tawender/Sensor_Research_System_Hardware/die_outline.bmp

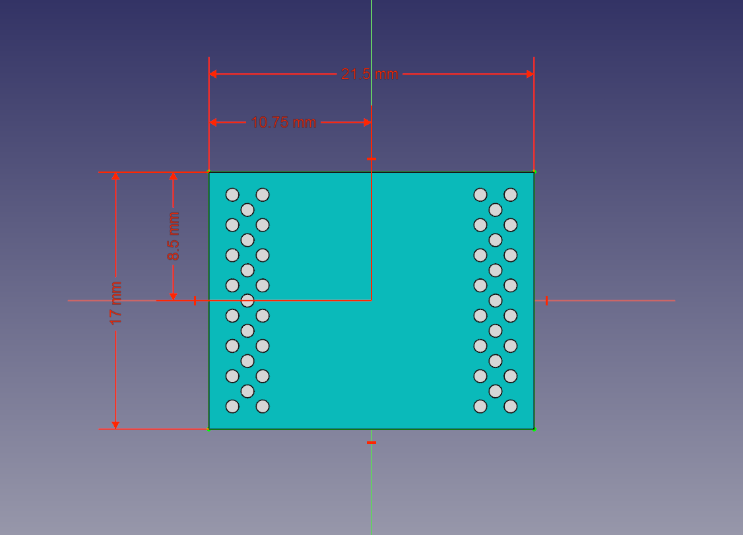
die_outline.bmp
