tawender/Sensor_Research_System_Hardware/fixture_bot.bmp

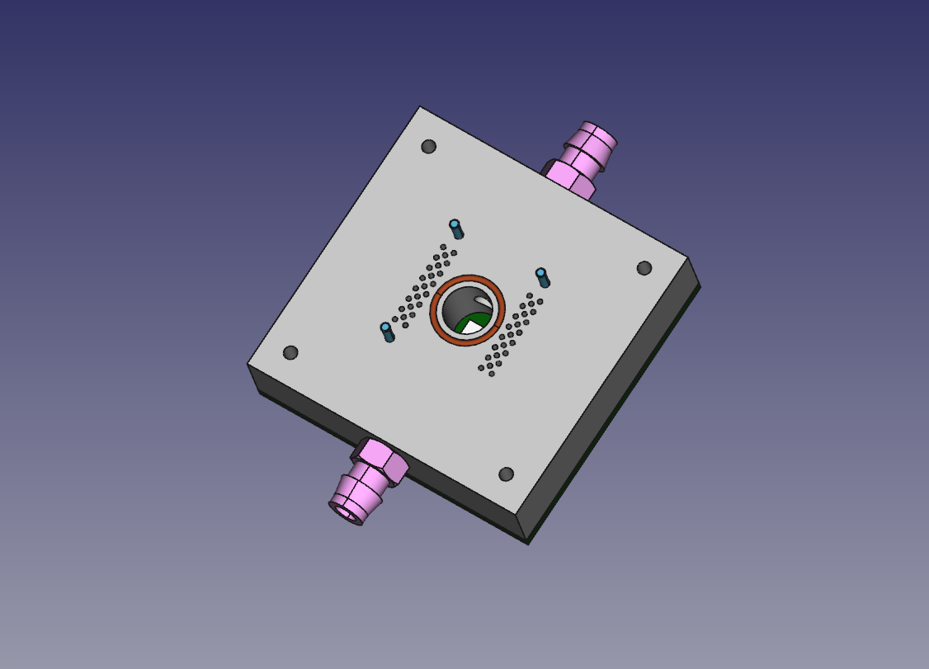
fixture_bot.bmp
