tawender/Sensor_Research_System_Hardware/mechanical_fixture_rev1_archive/readme.txt

These models were used to order the first go at this version 2 mechanical fixture to hold the nea sensor die.
The base was made of aluminum. The top and bottom probe holding plates were made of teflon and had the alignment dowels pressed into them.
