tawender/Sensor_Research_System_Hardware/pcb-breakout/rev1/nea_fixture_breakout_board_layout-R1.pdf

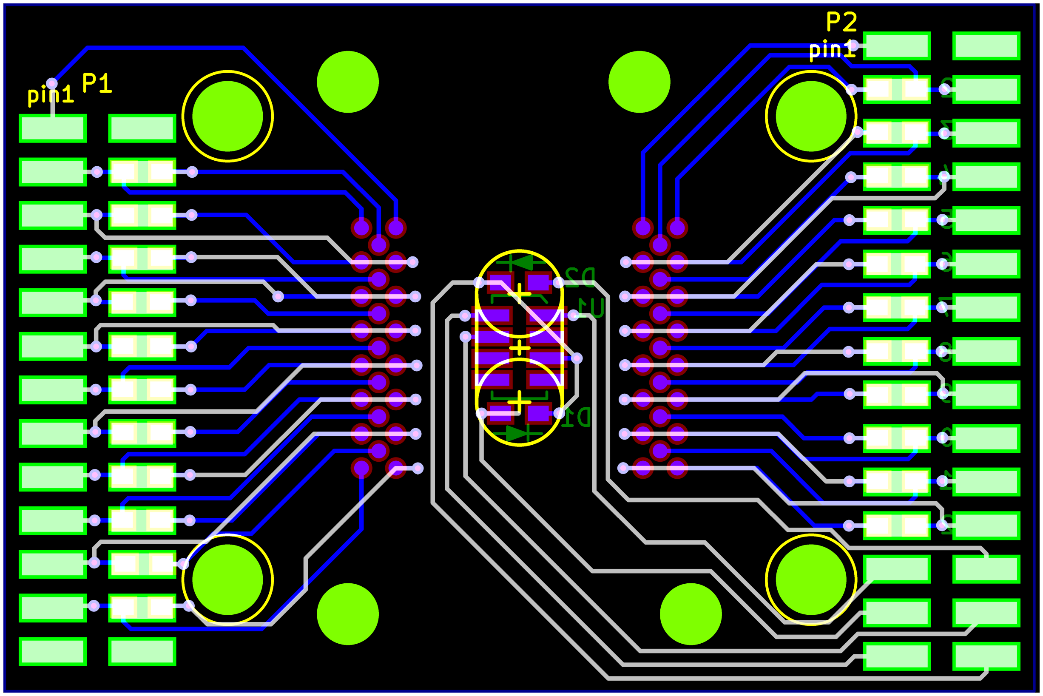
[picture p4: page 1]
