tawender/Sensor_Research_System_Hardware/bond_pad_spacing.bmp

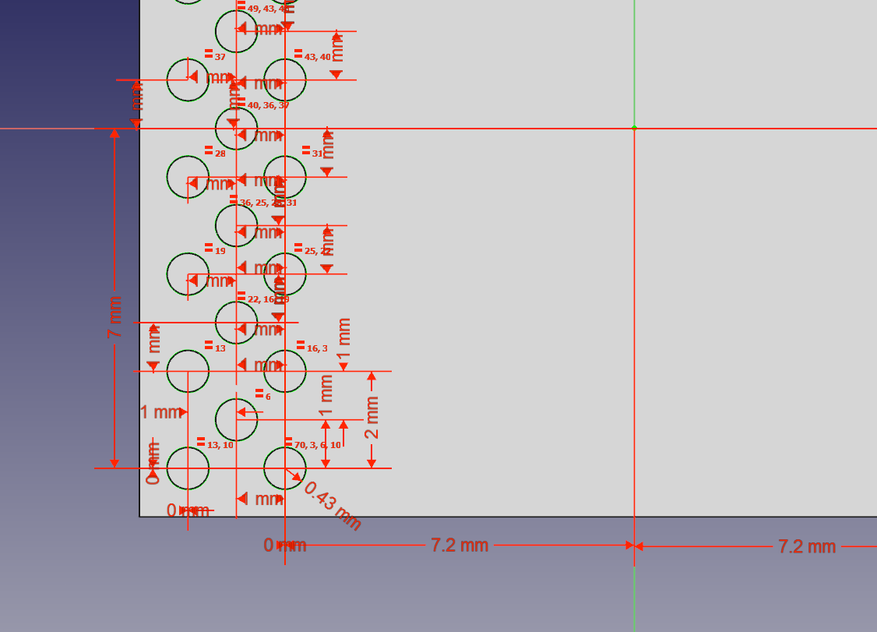
bond_pad_spacing.bmp
