tawender/Sensor_Research_System_Hardware/double_ended_probe_DE-50.png

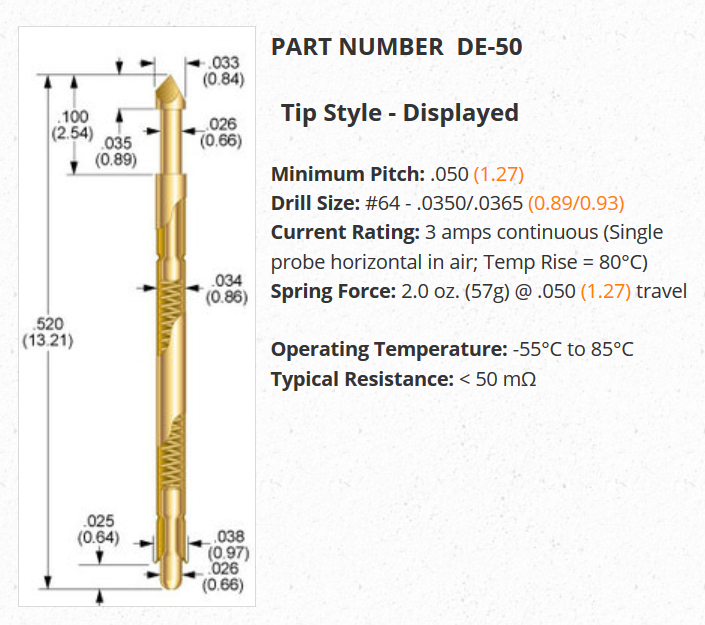
double_ended_probe_DE-50.png
