tawender/Sensor_Research_System_Hardware/fixture_top.bmp

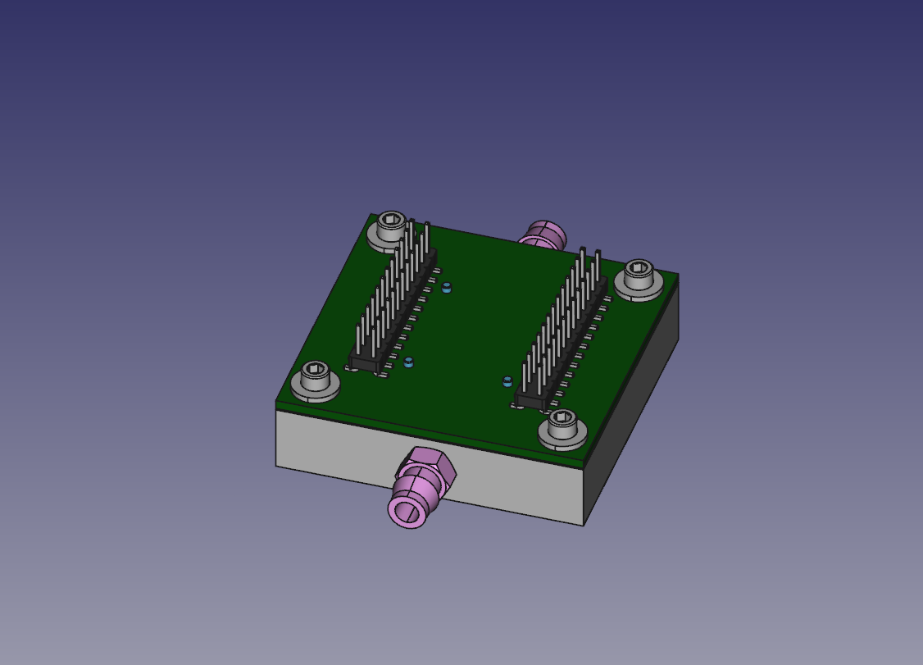
fixture_top.bmp
