tawender/Sensor_Research_System_Hardware/invoices/20170411_220916.jpg

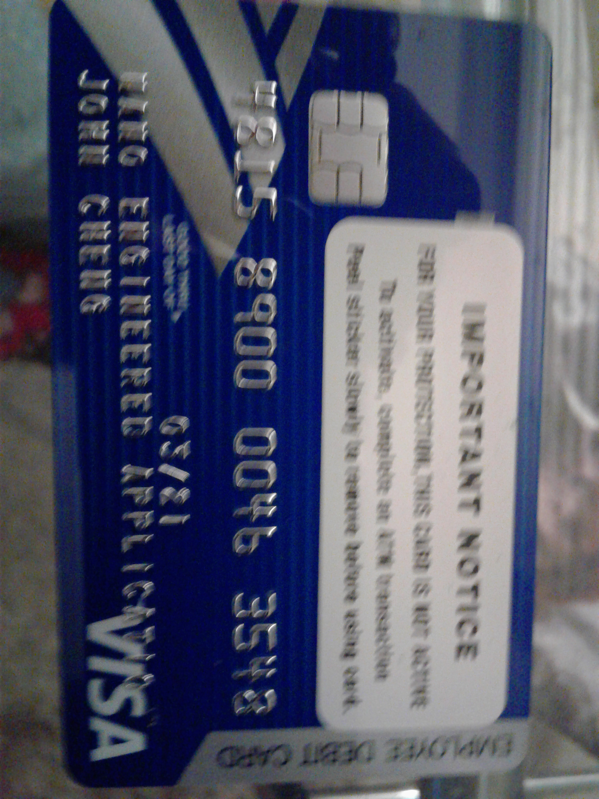
invoices/20170411_220916.jpg
