tawender/Sensor_Research_System_Hardware/invoices/20170411_221020.jpg

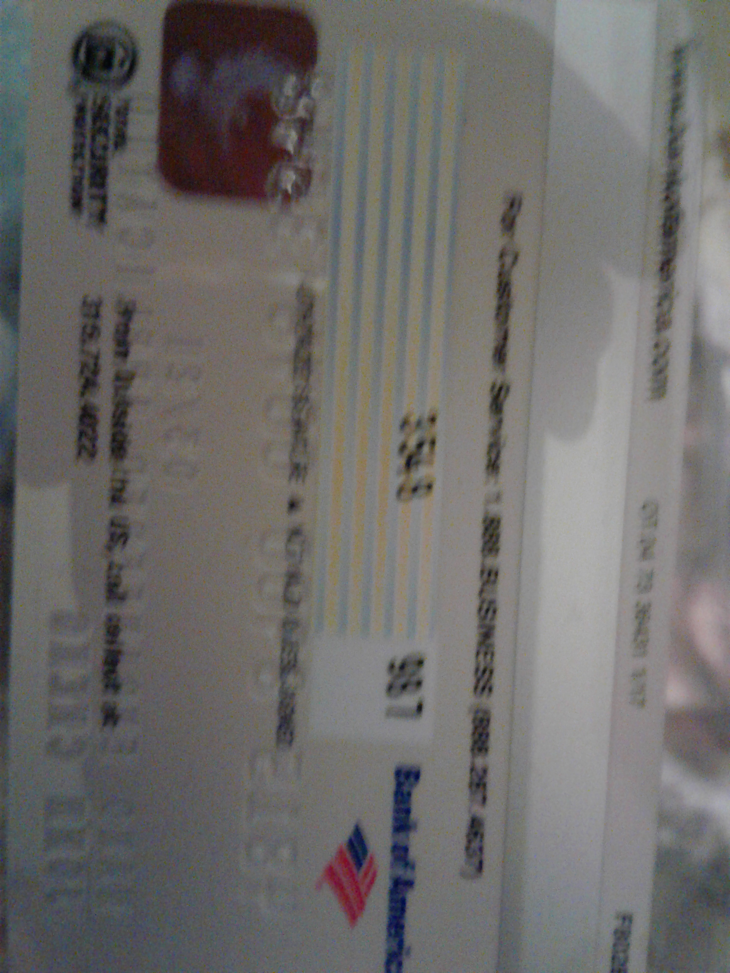
invoices/20170411_221020.jpg
