tawender/Sensor_Research_System_Hardware/new_screenshots/fixture_bot.bmp

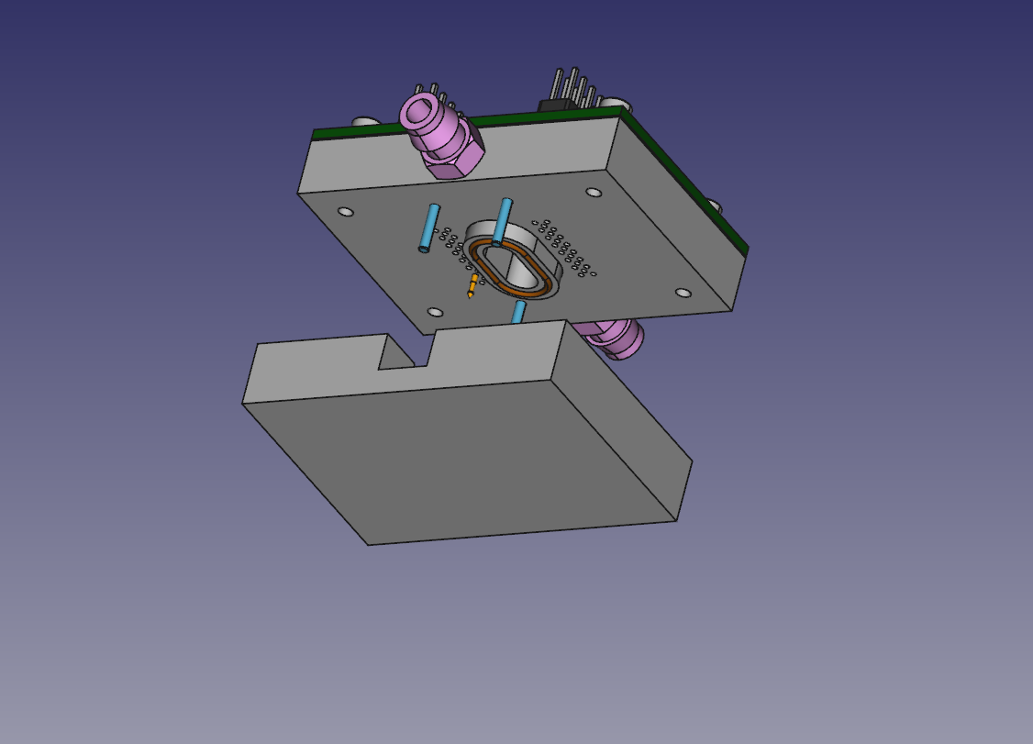
new_screenshots/fixture_bot.bmp
