tawender/Sensor_Research_System_Hardware/new_screenshots/fixture_top.bmp

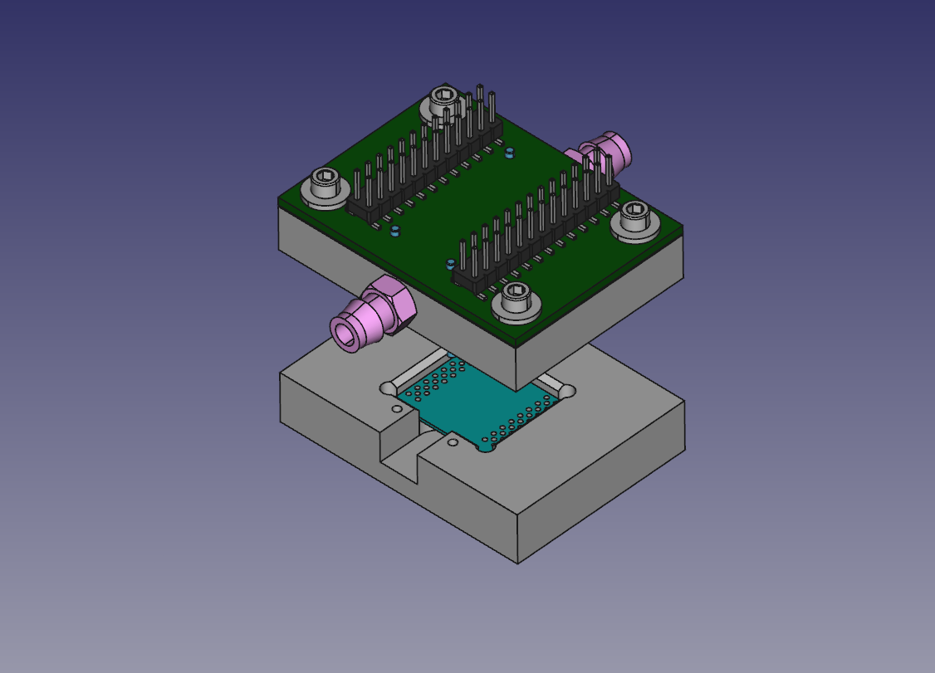
new_screenshots/fixture_top.bmp
