tawender/Sensor_Research_System_Hardware/pcb-measurement board/measurement_board_rev1_BOM.xls

BOM for NEA research fixture measurement board rev.1
# boards | 6
Reference | quantity | qty reqd | ordered | Value | supplier pn | description | Footprint | supplier | manufacturer | manufacturer pn
C1,C6,C13,C20,C26,C28,C19,C24,C33,C34,C30,C32,C16,C17,C22,C8,C25,C23,C15,C18,C5,C36,C37,C29,C40 | 25 | 150 | 250 | 0.1uF | 490-1532-1-ND | CAP CER 0.1UF 16V X7R 0603 | footprints_on_Cdrive:0603 | digikey | AVX Corporation | GRM188R71C104KA01D
C2,C10 | 2 |  |  | DNI | NA | do not install | footprints_on_Cdrive:0603 | NA | NA | NA
C21,C7,C35 | 3 | 18 | 100 | 10uF | 490-3896-1-ND | CAP CER 10UF 6.3V X5R 0603 | footprints_on_Cdrive:0603 | digikey | Murata | GRM188R60J106ME47D
C27 | 1 | 6 | 100 | 39nF | 399-9078-1-ND | CAP CER 0.039UF 16V X7R 0603 | footprints_on_Cdrive:0603 | digikey | Kemet | C0603C393K4RACTU
C31,C14,C38 | 3 | 18 | 100 | 1.1nF | 490-1452-1-ND | CAP CER 1100PF 50V C0G/NP0 0603 | footprints_on_Cdrive:0603 | digikey | Murata | GRM1885C1H112JA01D
C39 | 1 | 6 | 100 | 10pF | 490-5921-1-ND | CAP CER 10PF 50V C0G/NP0 0402 | footprints_on_Cdrive:0402 | digikey | Murata | GRM1555C1H100JA01D
C4,C3,C11,C12 | 4 | 24 | 100 | 0.47uF | 1276-1898-1-ND | CAP CER 0.47UF 10V X5R 0603 | footprints_on_Cdrive:0603 | digikey | Samsung | CL10A474KP8NNNC
C9 | 1 | 6 | 100 | 51pF | 490-1420-1-ND | CAP CER 51PF 50V C0G/NP0 0603 | footprints_on_Cdrive:0603 | digikey | Murata | GRM1885C1H510JA01D
P1 | 1 | 6 | 7 | 10-Pin Flex Conn | WM6745CT-ND | CONN_FFC_FPC_10POS_0.50MM_R/A | footprints_on_Cdrive:WM6745-FPC | digikey | Molex | 512811094
P2 | 1 | 6 | 6 | CONN_02X15 | A26494-ND | CONN RECEPT 30POS .100 VERT DUAL | footprints_on_Cdrive:Pin_Header_Straight_2x15_Pitch2.54mm | digikey | TE | 1-534998-5
P3 | 1 | 6 | 6 | CONN_02X13 | A26492-ND | CONN RECEPT 26POS .100 VERT DUAL | footprints_on_Cdrive:Pin_Header_Straight_2x13_Pitch2.54mm | digikey | TE | 1-534998-3
P4,P5 | 2 | 12 | 10 | CONN_02X05 | S2012EC-40-ND | CONN HEADER .100" DUAL STR 80POS | footprints_on_Cdrive:header_2x5_idc | digikey | Sullins Connector | PREC040DAAN-RC
Q1 | 1 | 6 | 20 | Si1103X | SI1013X-T1-GE3CT-ND | MOSFET P-CH 20V 350MA SC89-3 | footprints_on_Cdrive:SOT23 | digikey | Vishay | SI1013X-T1-GE3
Q2 | 1 | 6 | 25 | 2N7002 | 2N7002-FDICT-ND | MOSFET N-CH 60V 115MA SOT23-3 | footprints_on_Cdrive:SOT23 | digikey | Diodes Inc. | 2N7002-7-F
R4 | 1 | 6 | 100 | 2k | 311-2.00KHRCT-ND | RES SMD 2K OHM 1% 1/10W 0603 | footprints_on_Cdrive:0603 | digikey | Yageo | RC0603FR-072KL
R3 | 1 | 6 | 100 | 10k | 311-10.0KHRCT-ND | RES SMD 10.0K OHM 1% 1/10W 0603 | footprints_on_Cdrive:0603 | digikey | Yageo | RC0603FR-0710KL
R1 | 1 | 6 | 100 | 30k | 311-30.0KHRCT-ND | RES SMD 30K OHM 1% 1/10W 0603 | footprints_on_Cdrive:0603 | digikey | Yageo | RC0603FR-0730KL
R2 | 1 | 6 | 100 | 75k | 311-75.0KHRCT-ND | RES SMD 75K OHM 1% 1/10W 0603 | footprints_on_Cdrive:0603 | digikey | Yageo | RC0603FR-0775KL
R10,R5,R6,R8 | 4 | 24 | 100 | 1K | 311-1.00KHRCT-ND | RES SMD 1K OHM 1% 1/10W 0603 | footprints_on_Cdrive:0603 | digikey | Yageo | RC0603FR-071KLL
R11,R7 | 2 | 12 | 100 | 100k | 311-100KHRCT-ND | RES SMD 100K OHM 1% 1/10W 0603 | footprints_on_Cdrive:0603 | digikey | Yageo | RC0603FR-07100KL
R12 | 1 | 6 | 100 | 24.9k | 311-24.9KHRCT-ND | RES SMD 24.9K OHM 1% 1/10W 0603 | footprints_on_Cdrive:0603 | digikey | Yageo | RC0603FR-0724K9L
R14,R13 | 2 | 12 | --- | DNI | NA | NA | footprints_on_Cdrive:0603 | NA | NA | NA
R15,R16 | 2 | 12 | 100 | 47K | 311-47.0KHRCT-ND | RES SMD 47K OHM 1% 1/10W 0603 | footprints_on_Cdrive:0603 | digikey | Yageo | RC0603FR-0747KL
R17,R18 | 2 | 12 | 100 | 0 ohm | 311-0.0JRCT-ND | RES SMD 0.0OHM JUMPER 1/16W 0402 | footprints_on_Cdrive:0402 | digikey | Yageo | RC0402JR-070RL
R9 | 1 | 6 | 25 | 10ohm 0.1% | A110351CT-ND | RES SMD 10 OHM 0.1% 1/4W 0805 | footprints_on_Cdrive:0805 | digikey | TE Connectivity | 2-1625868-7
TP2,TP5,TP1,TP8,TP9,TP10,TP12,TP4,TP16,TP3 | 11 | 66 | --- | TP_SMT | None | None | footprints_on_Cdrive:TP_SMT.02 | None | None | None
U1,U4,U8,U11,U17,U18 | 6 | 36 | 40 | NX3L4051 | 568-12393-1-ND | IC ANALOG SWITCH 8CH 16TSSOP | footprints_on_Cdrive:TSSOP16 | digikey | NXP | NX3L4051PW-118
U12 | 1 | 6 | 7 | MSP430G2955 | 296-35703-1-ND | IC MCU 16BIT 56KB FLASH 40VQFN | footprints_on_Cdrive:VQFN40 | digikey | Texas Instruments | MSP430G2955IRHA40R
U16 | 1 | 6 | 10 | AD8293 | AD8293G160ARJZ-R7CT-ND | IC OPAMP INSTR 500HZ RRO SOT23-8 | footprints_on_Cdrive:SOT23-8 | digikey | Analog Devices Inc. | AD8293G160ARJZ-R7
U19,U20 | 2 | 12 | 13 | QS4A110 | 800-1776-5-ND | IC SWITCH 5PST 24QSOP | footprints_on_Cdrive:QSOP-24 | digikey | IDT | QS4A110QG
U2 | 1 | 6 | 15 | TPS73133 | 296-32553-1-ND | IC REG LDO 3.3V 0.15A SOT23-5 | footprints_on_Cdrive:SOT23-5 | digikey | Texas Instruments | TPS73133DBVR
U23 | 1 | 6 | 10 | AD7683 | AD7683ARMZRL7CT-ND | IC ADC 16BIT SAR 100KSPS 8MSOP | footprints_on_Cdrive:RM-8 | digikey | Analog Devices | AD7683ARMZRL7
U3 | 1 | 6 | 10 | 74CBTLV3253 | 568-5422-1-ND | IC MUX/DEMUX DUAL 1OF4 DHVQFN16 | footprints_on_Cdrive:DHVQFN16 | digikey | NXP Semiconductors | 74CBTLV3253BQ-115
U5 | 1 | 6 | 15 | TPS73125 | 296-15803-1-ND | IC REG LDO 2.5V 0.15A SOT23-5 | footprints_on_Cdrive:SOT23-5 | digikey | Texas Instruments | TPS73125DBVT
U6,U13 | 2 | 12 | 20 | AD8603 | AD8603AUJZREEL7CT-ND | IC OPAMP GP 400KHZ RRO TSOT23-5 | footprints_on_Cdrive:SOT23-5 | digikey | Analog Devices | AD8603AUJZ-REEL7
U7,U15 | 2 | 12 | 25 | MCP4921 | MCP4921T-E/MSCT-ND | ICDAC 12BIT SNGL W/SPI 8MSOP | footprints_on_Cdrive:MSOP-8 | digikey | Microchip Technology | MCP4921T-E/MS
U9,U14,U10,U21,U22 | 5 | 30 | 40 | TLV1G125 | 296-9109-1-ND | IC LV SINGLE FET BUS SW SOT-23-5 | footprints_on_Cdrive:SOT23-5 | digikey | Texas Instruments | SN74CBTLV1G125DBVR
BOM line items | 34
part count | 84
thruhole part count | 4
