tawender/Sensor_Research_System_Hardware/models_submitted/rev2/probe_block_combined01.step

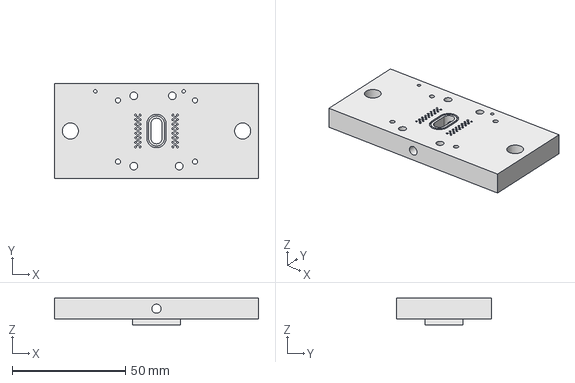
[picture p12: CAD file, 2017-04-08]
models_submitted/rev2/probe_block_combined01.step
90.0 x 42.0 x 11.7 mm
