tawender/Sensor_Research_System_Hardware/die_holder_block.FCStd

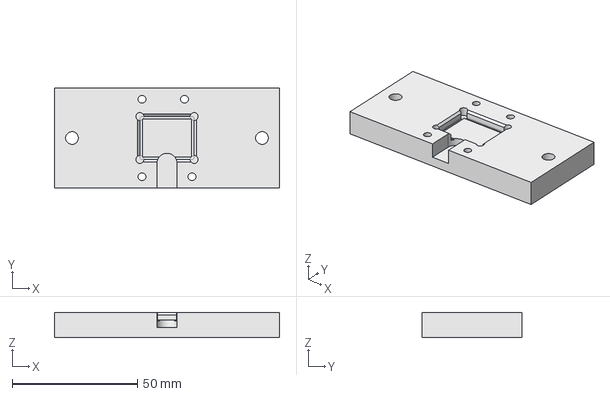
[picture p14: CAD file, 2017-04-08]
die_holder_block.FCStd
90.0 x 40.0 x 10.0 mm
