tawender/Sensor_Research_System_Hardware/models_submitted/rev2/probe_block_top_gas.step

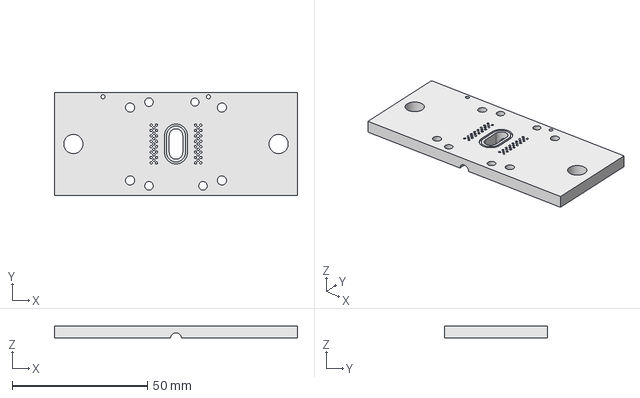
[picture p16: CAD file, 2017-02-18]
models_submitted/rev2/probe_block_top_gas.step
90.0 x 38.0 x 4.60 mm
