tawender/Sensor_Research_System_Hardware/pcb.FCStd

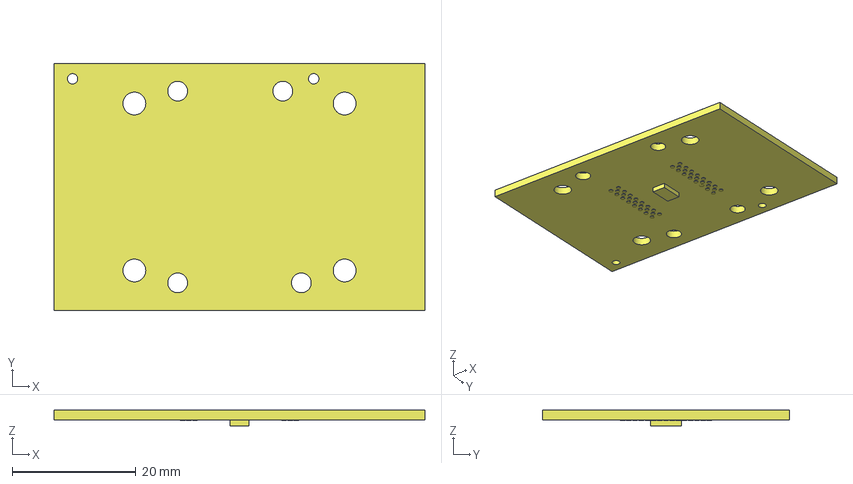
[picture p17: CAD file, 2017-02-22]
pcb.FCStd
60.0 x 40.0 x 2.57 mm
