tawender/Sensor_Research_System_Hardware/dowel_0.125x.625L.FCStd

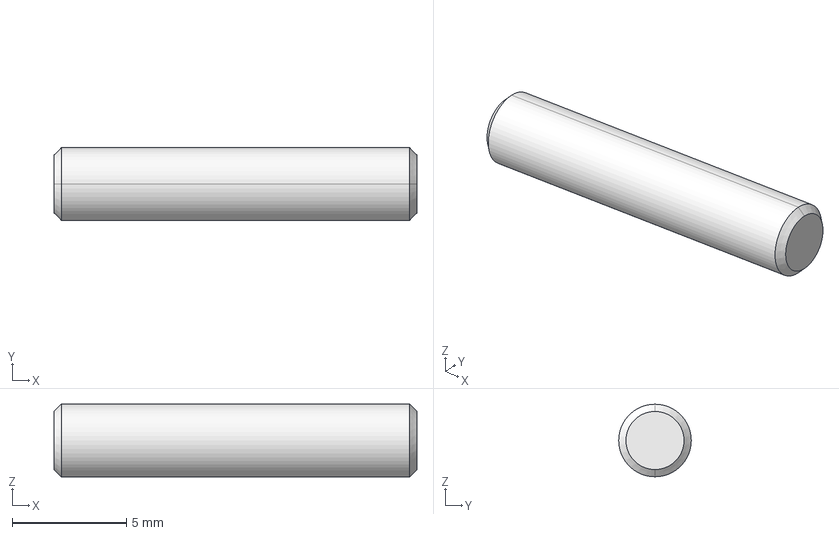
[picture p18: CAD file, 2017-02-22]
dowel_0.125x.625L.FCStd
15.9 x 3.17 x 3.17 mm
