tawender/Sensor_Research_System_Hardware/wafer_layout/SENSOR_CHIP_DAISY.DXF

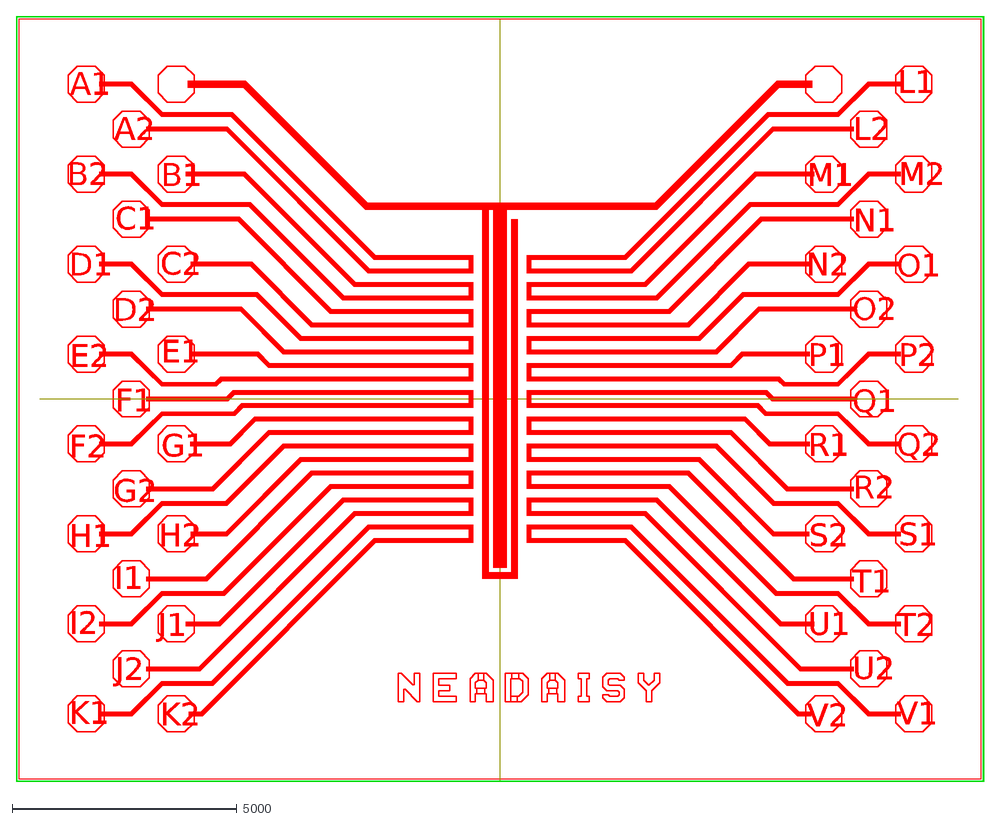
[picture p20: CAD file, 2017-01-20]
wafer_layout/SENSOR_CHIP_DAISY.DXF
A1
A2
B1
B2
C1
C2
D1
D2
E1
E2
F1
F2
G1
G2
H1
H2
I1
I2
J1
J2
K1
K2
L1
L2
M1
M2
N1
N2
O1
O2
P1
P2
Q1
Q2
R1
R2
S1
S2
T1
T2
U1
U2
V1
V2
