tawender/Sensor_Research_System_Hardware/dowel_0.0625x.5L.FCStd

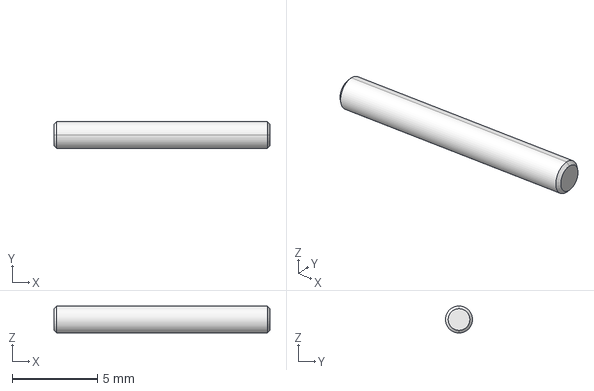
[picture p21: CAD file, 2017-02-22]
dowel_0.0625x.5L.FCStd
12.7 x 1.59 x 1.59 mm
