tawender/Sensor_Research_System_Hardware/models_submitted/rev2/probe_block_bot.step

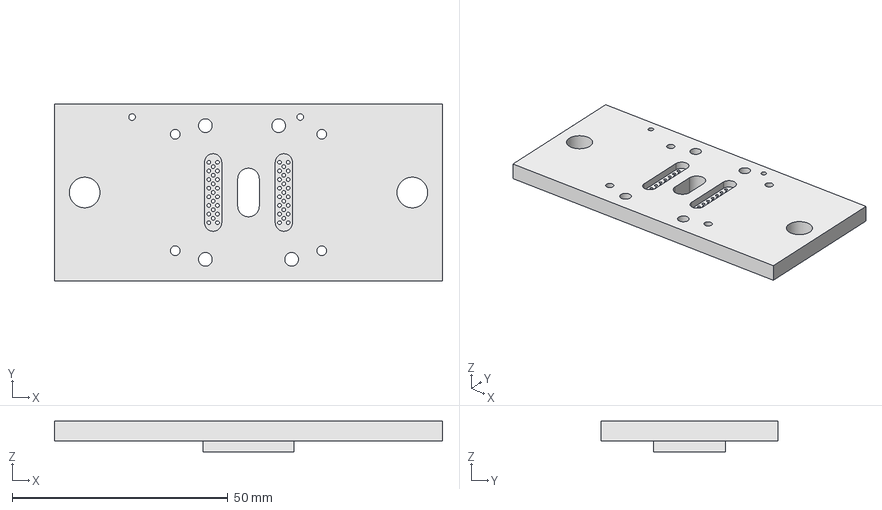
[picture p22: CAD file, 2017-02-18]
models_submitted/rev2/probe_block_bot.step
90.0 x 41.0 x 7.10 mm
