tawender/Sensor_Research_System_Hardware/models_submitted/rev2/die_holder_block_r2.step

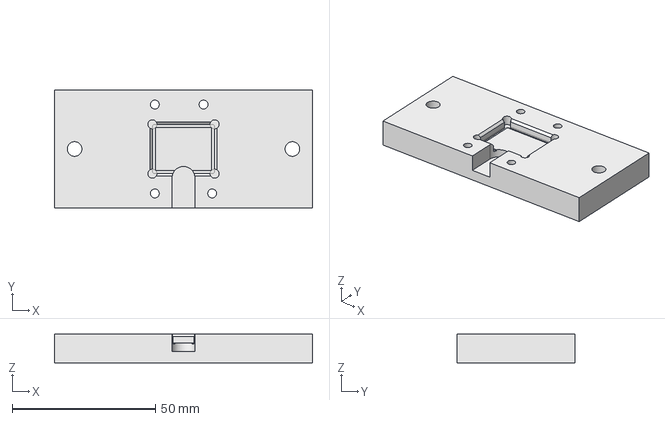
[picture p23: CAD file, 2017-02-15]
models_submitted/rev2/die_holder_block_r2.step
90.0 x 41.0 x 10.0 mm
