tawender/Sensor_Research_System_Hardware/models_submitted/rev2/probe_block_bot_gas.step

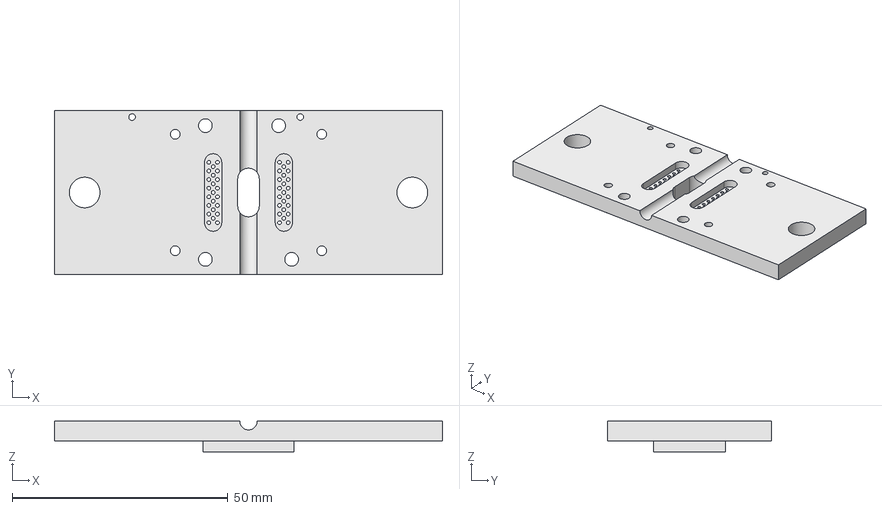
[picture p24: CAD file, 2017-02-15]
models_submitted/rev2/probe_block_bot_gas.step
90.0 x 38.0 x 7.10 mm
