tawender/Sensor_Research_System_Hardware/headers_smt_30.FCStd

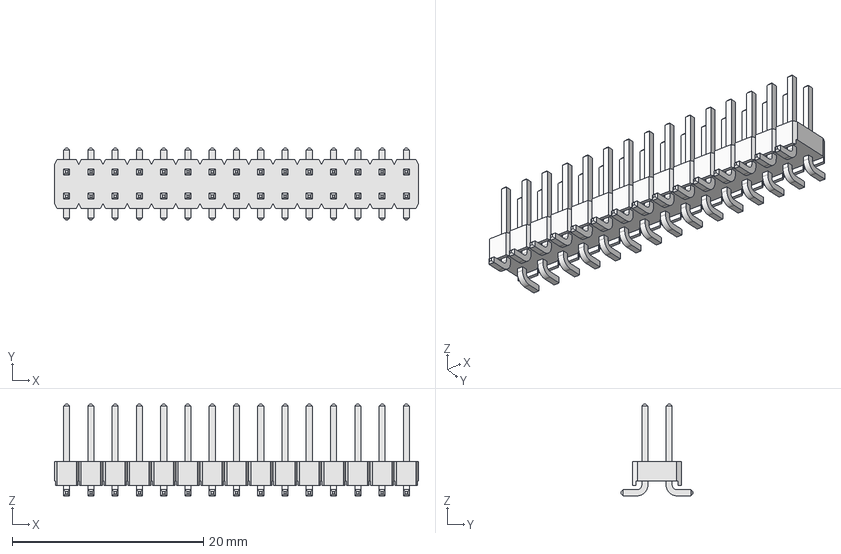
[picture p25: CAD file, 2017-01-21]
headers_smt_30.FCStd
38.1 x 7.50 x 9.60 mm
