tawender/Sensor_Research_System_Hardware/SHCS_4-40x0.4375.FCStd

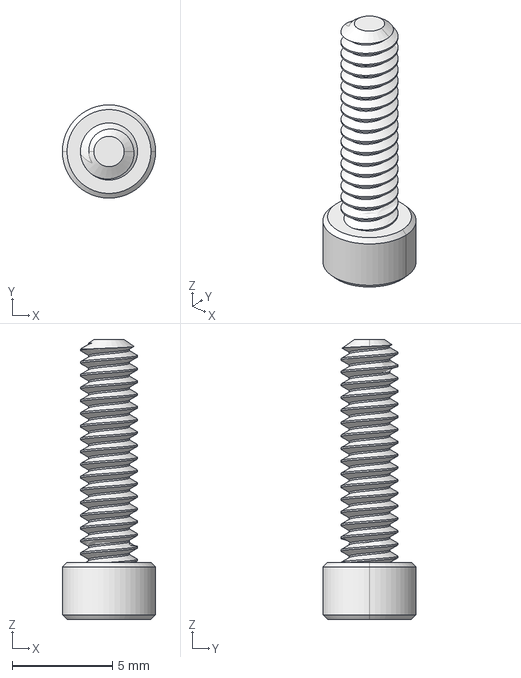
[picture p26: CAD file, 2017-01-20]
SHCS_4-40x0.4375.FCStd
4.65 x 4.65 x 14.0 mm
