tawender/Sensor_Research_System_Hardware/SHCS_4-40x0.5.FCStd

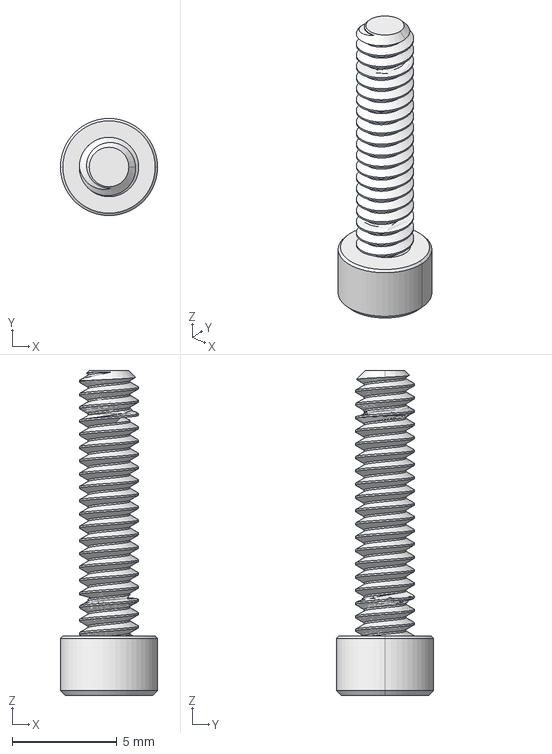
[picture p27: CAD file, 2017-01-20]
SHCS_4-40x0.5.FCStd
4.65 x 4.65 x 15.5 mm
