tawender/Sensor_Research_System_Hardware/thd_insert_0.25-20.FCStd

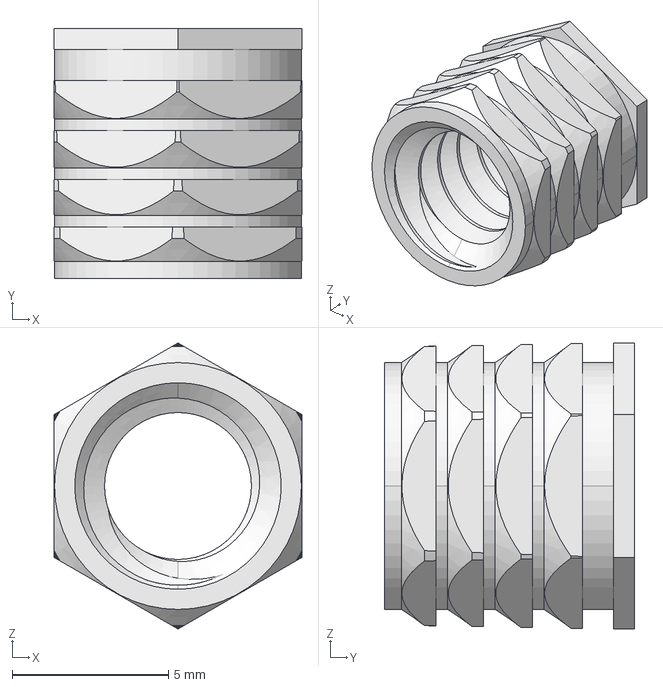
[picture p28: CAD file, 2017-01-20]
thd_insert_0.25-20.FCStd
7.92 x 8.00 x 9.15 mm
