tawender/Sensor_Research_System_Hardware/NEA_research_fixture_R2.FCStd

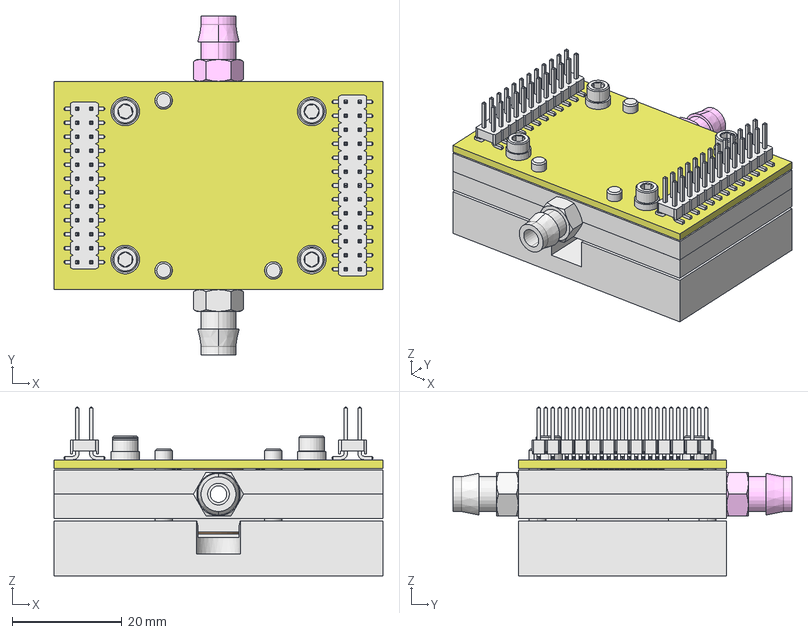
[picture p29: CAD file, 2017-01-19]
NEA_research_fixture_R2.FCStd
60.0 x 61.8 x 30.8 mm
hose_barb_10_32_01
pcb_01
hose_barb_10_32_01001
headers_smt_26_01
headers_smt_24_01
washer_num4_01
SHCS_1_4_20_01
SHCS_1_4_20_01001
washer_num4_02
SHCS_1_4_20_01002
washer_num4_03
SHCS_1_4_20_01003
washer_num4_04
probe_DE_50_01
o_ring_11mm_oval_01
o_ring_11mm_oval_01001
die_rev2_01
die_holder_block_01
probe_block_top_01
probe_block_bot01
dowel_0_125x_875L_01
dowel_0_125x_875L_01001
dowel_0_125x_875L_01002
