tawender/Sensor_Research_System_Hardware/dowel_0.125x.875L.FCStd

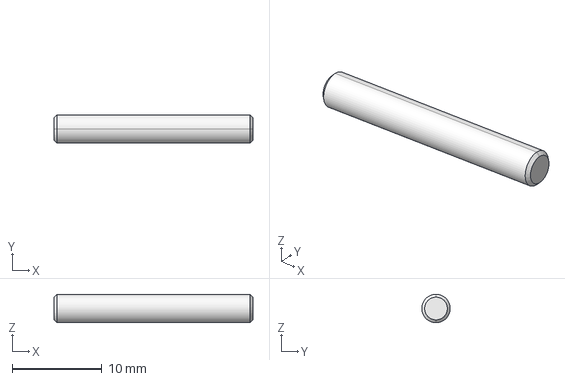
[picture p30: CAD file, 2017-01-18]
dowel_0.125x.875L.FCStd
22.2 x 3.17 x 3.17 mm
