tawender/Sensor_Research_System_Hardware/die_rev2.FCStd

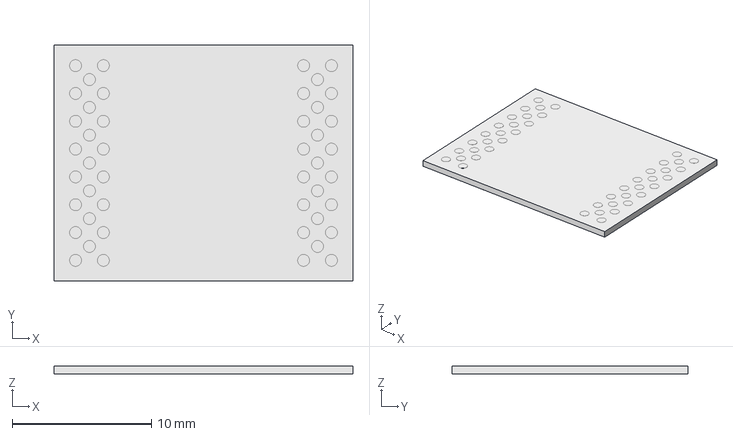
[picture p31: CAD file, 2017-01-17]
die_rev2.FCStd
21.5 x 17.0 x 0.61 mm
