tawender/Sensor_Research_System_Hardware/dowel_0.125x.75L.FCStd

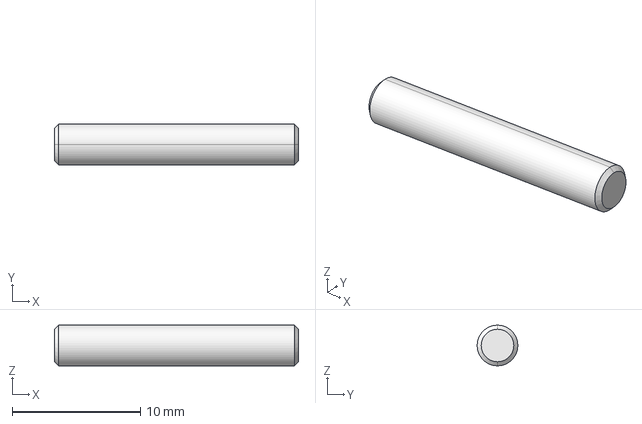
[picture p32: CAD file, 2017-01-17]
dowel_0.125x.75L.FCStd
19.1 x 3.17 x 3.17 mm
