tawender/Sensor_Research_System_Hardware/o-ring_11mm_oval.FCStd

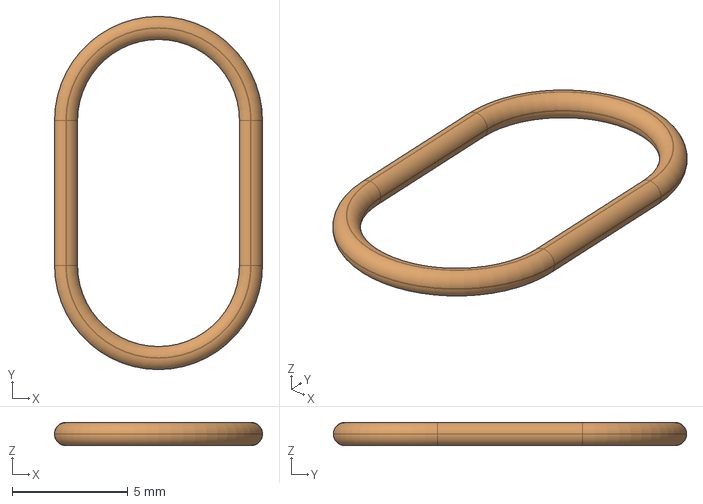
[picture p33: CAD file, 2017-01-11]
o-ring_11mm_oval.FCStd
9.00 x 15.3 x 1.00 mm
