tawender/Sensor_Research_System_Hardware/SHCS_4-40x0.25.FCStd

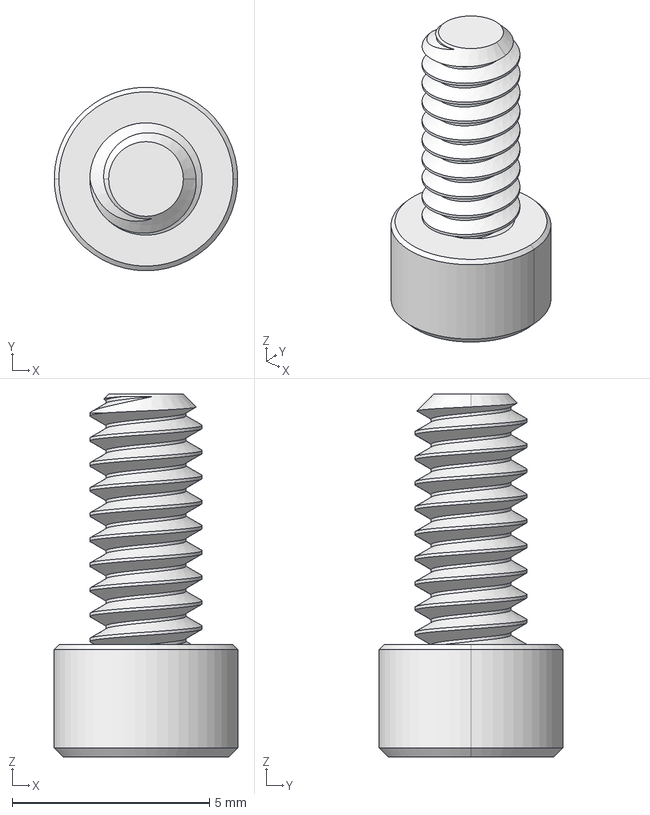
[picture p34: CAD file, 2017-01-11]
SHCS_4-40x0.25.FCStd
4.65 x 4.65 x 9.19 mm
