tawender/Sensor_Research_System_Hardware/o-ring_10mm.FCStd

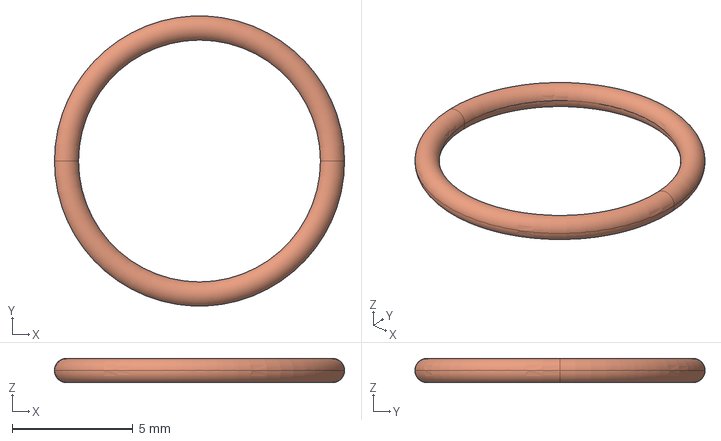
[picture p35: CAD file, 2017-01-11]
o-ring_10mm.FCStd
12.0 x 12.0 x 1.00 mm
