tawender/Sensor_Research_System_Hardware/headers_smt_26.FCStd

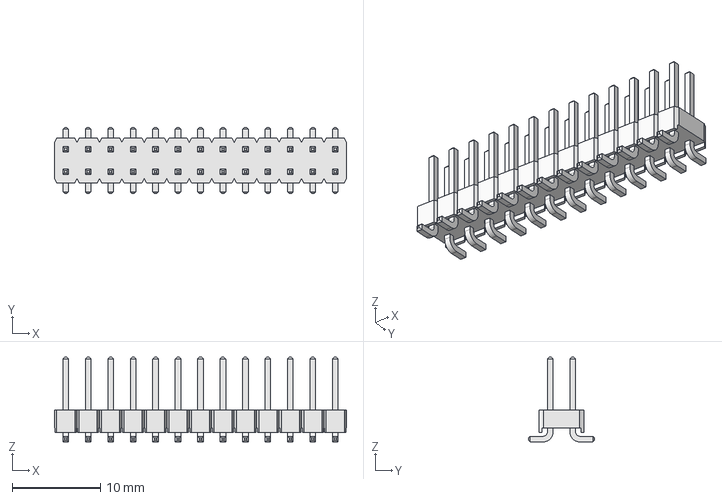
[picture p36: CAD file, 2017-01-11]
headers_smt_26.FCStd
33.0 x 7.50 x 9.60 mm
