tawender/Sensor_Research_System_Hardware/probe_DE-50.FCStd

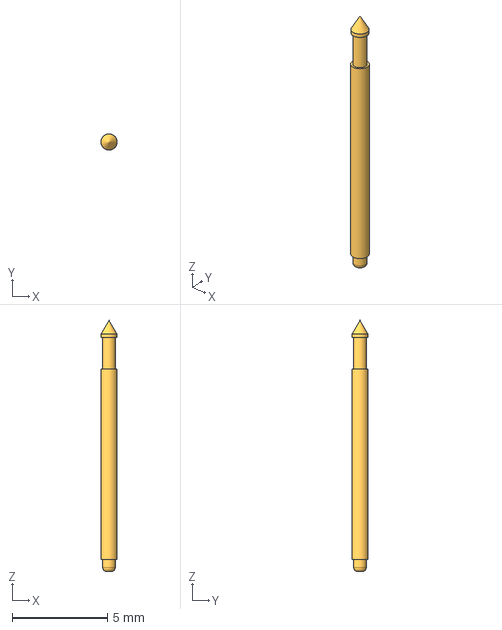
[picture p37: CAD file, 2017-01-11]
probe_DE-50.FCStd
0.859 x 0.86 x 13.2 mm
