tawender/Sensor_Research_System_Hardware/dowel_0.0625x.75L.FCStd

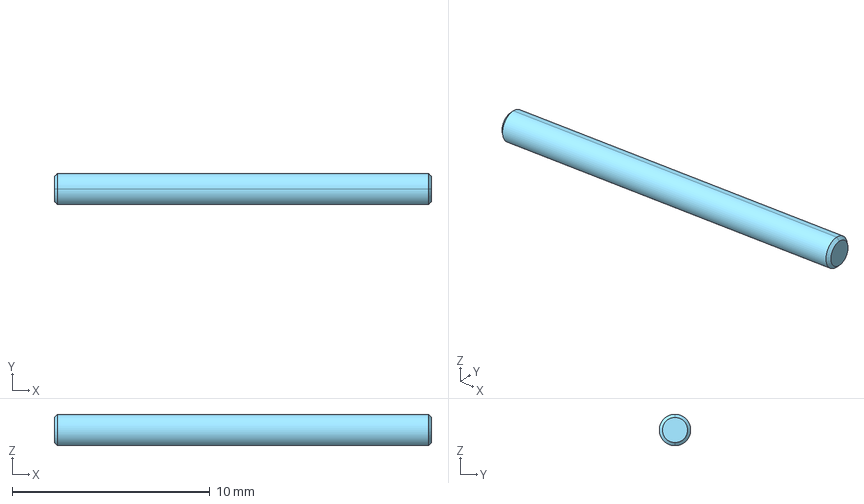
[picture p38: CAD file, 2017-01-11]
dowel_0.0625x.75L.FCStd
19.1 x 1.59 x 1.59 mm
