tawender/Sensor_Research_System_Hardware/headers_smt_24.FCStd

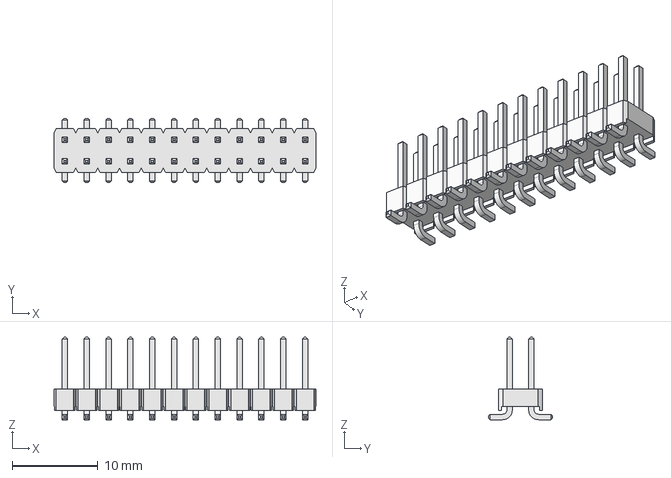
[picture p39: CAD file, 2017-01-11]
headers_smt_24.FCStd
30.5 x 7.50 x 9.60 mm
