tawender/Sensor_Research_System_Hardware/hose_barb_0.25.FCStd

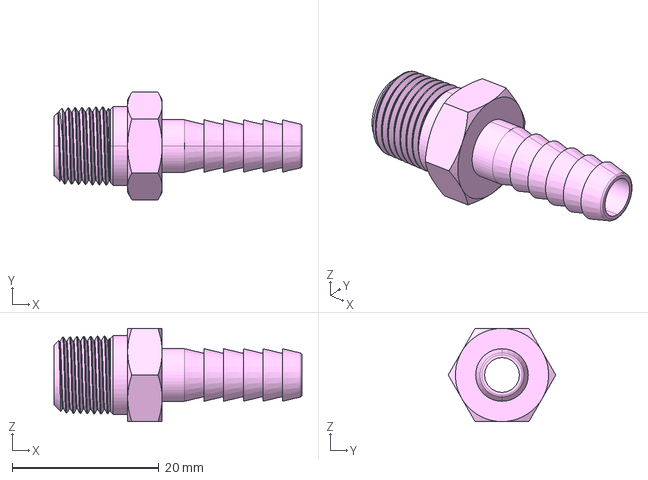
[picture p40: CAD file, 2017-01-11]
hose_barb_0.25.FCStd
33.8 x 14.7 x 12.7 mm
