tawender/Sensor_Research_System_Hardware/hose_barb_10-32.FCStd

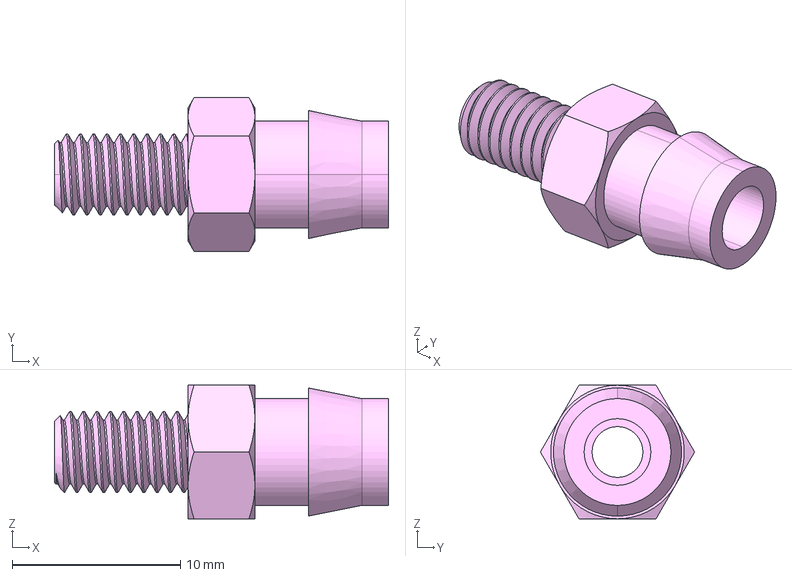
[picture p41: CAD file, 2017-01-11]
hose_barb_10-32.FCStd
19.8 x 9.17 x 7.94 mm
