tawender/Sensor_Research_System_Hardware/probe_block_thick.step

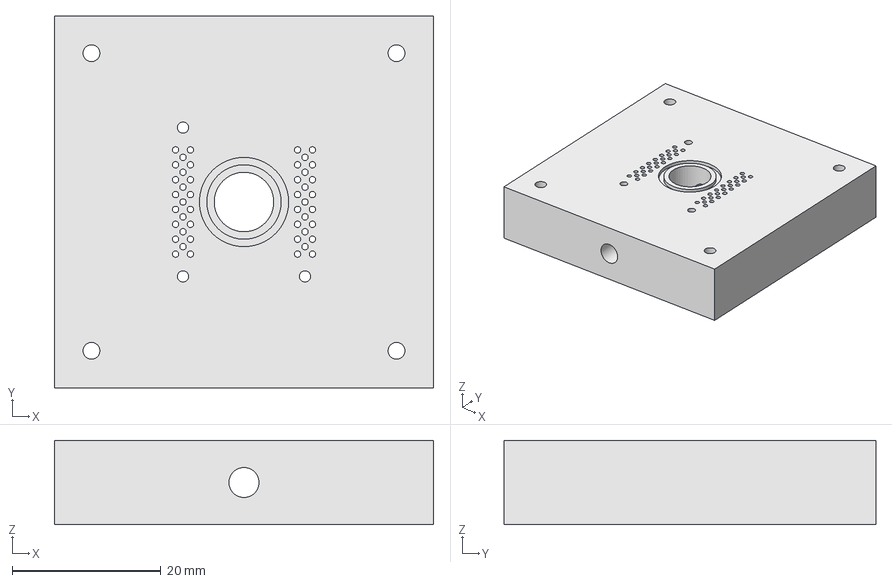
[picture p42: CAD file, 2017-01-11]
probe_block_thick.step
51.0 x 50.0 x 11.3 mm
