tawender/Sensor_Research_System_Hardware/(list of files, cad)

Other CAD files:
probe_block.FCStd
models_submitted/rev2/die_holder_block_r3.step
wafer_layout/NEA_002.DXF
probe_block_top_gas.FCStd
probe_block_bot_.FCStd
probe_block_top.FCStd
probe_block_bot_gas.FCStd
die_holder_block_thumbscrews.step
mechanical_fixture_rev1_archive/die_holder_block.FCStd
mechanical_fixture_rev1_archive/probe_block_bot_.FCStd
mechanical_fixture_rev1_archive/probe_block_top.FCStd
models_submitted/rev1/die_holder_block.step
models_submitted/rev1/probe_block_bot.step
models_submitted/rev1/probe_block_top.step
probe_block_bot_thumbscrews.step
probe_block_top_thumbscrews.step
thumbscrew_.25-20x.625.FCStd
washer_num4.FCStd
washer_num4_nylon.FCStd
