tawender/Sensor_Research_System_Hardware/fixture_rev2_wiring_diagram_SPI.xls

Sheet: Sheet1
The die test fixture has a breakout board with 26-pin(2x13) and 30-pin(2x15) headers on it
There is also a switch board that mates to the 2 headers on the breakout board.
The switch board combines the 26-pin and the 30-pin headers into a single 60-pin header.
A 60-pin ribbon cable with multiple connectors on it can connect multiple die fixtures to the tester. The tester can then control which die is 'switched' in for measurements.
On the breakout board there are 2 spots for ultraviolet LEDs and a sensor that is able to measure pressure, humidity, and temperature
The pressure/humidity/temperature sensor on the breakout board uses a SPI interface for communication
26-pin IDC on new SPI breakout board |  | 30-pin IDC on new SPI breakout board |  | 60-pin IDC on new SPI switch board
connector pin # | Die Pad # | connector pin # | Die Pad # | connector pin # | Die Pad # | Die Pad Numbering
1 | Com1 | 1 | Com2 | 1 | COM1 | A1 |  | Com1 | Com2 |  | L1
2 | NC | 2 | NC | 2 | COM2 |  | A2 |  |  | L2
3 | A1 | 3 | L1 | 3 | AQ | B2 |  | B1 | M1 |  | M2
4 | A2 | 4 | L2 | 4 | A2 |  | C1 |  |  | N1
5 | B1 | 5 | M1 | 5 | B1 | D1 |  | C2 | N2 |  | O1
6 | B2 | 6 | M2 | 6 | B2 |  | D2 |  |  | O2
7 | C1 | 7 | N1 | 7 | C1 | E2 |  | E1 | P1 |  | P2
8 | C2 | 8 | N2 | 8 | C2 |  | F1 |  |  | Q1
9 | D1 | 9 | O1 | 9 | D1 | F2 |  | G1 | R1 |  | Q2
10 | D2 | 10 | O2 | 10 | D2 |  | G2 |  |  | R2
11 | E1 | 11 | P1 | 11 | E1 | H1 |  | H2 | S2 |  | S1
12 | E2 | 12 | P2 | 12 | E2 |  | I1 |  |  | T1
13 | F1 | 13 | Q1 | 13 | F1 | I2 |  | U1 | U1 |  | T2
14 | F2 | 14 | Q2 | 14 | F2 |  | U2 |  |  | U2
15 | G1 | 15 | R1 | 15 | G1 | K1 |  | K2 | V2 |  | V1
16 | G2 | 16 | R2 | 16 | G2 | NEADAISY
17 | H1 | 17 | S1 | 17 | H1
18 | H2 | 18 | S2 | 18 | H2
19 | I1 | 19 | T1 | 19 | I1
20 | I2 | 20 | T2 | 20 | I2
21 | J1 | 21 | U1 | 21 | J1
22 | J2 | 22 | U2 | 22 | J2
23 | K1 | 23 | V1 | 23 | K1
24 | K2 | 24 | V2 | 24 | K2
25 | SIMO | 25 | VDD | 25 | L1
26 | SOMI | 26 | LED2 | 26 | L2
 |  | 27 | LED1 | 27 | M1
 |  | 28 | *CS | 28 | M2
 |  | 29 | SCL | 29 | N1
 |  | 30 | GND | 30 | N2
 |  |  |  | 31 | O1
 |  |  |  | 32 | O2
 |  |  |  | 33 | P1
 |  |  |  | 34 | P2
 |  |  |  | 35 | Q1
 |  |  |  | 36 | Q2
 |  |  |  | 37 | R1
 |  |  |  | 38 | R2
 |  |  |  | 39 | S1
 |  |  |  | 40 | S2
 |  |  |  | 41 | T1
 |  |  |  | 42 | T2
 |  |  |  | 43 | U1
 |  |  |  | 44 | U2
 |  |  |  | 45 | V1
 |  |  |  | 46 | V2
 |  |  |  | 47 | LED1
 |  |  |  | 48 | LED2
 |  |  |  | 49 | *CS
 |  |  |  | 50 | SCL
 |  |  |  | 51 | 5V
 |  |  |  | 52 | 5V
 |  |  |  | 53 | 5V
 |  |  |  | 54 | SIMO
 |  |  |  | 55 | 3V3
 |  |  |  | 56 | 3V3
 |  |  |  | 57 | SOMI
 |  |  |  | 58 | GND
 |  |  |  | 59 | GND
 |  |  |  | 60 | GND

Sheet: Sheet4
The die test fixture has a breakout board with 26-pin(2x13) and 30-pin(2x15) headers on it
There is also a switch board that mates to the 2 headers on the breakout board.
The switch board combines the 26-pin and the 30-pin headers into a single 60-pin header.
A 60-pin ribbon cable with multiple connectors on it can connect multiple die fixtures to the tester. The tester can then control which die is 'switched' in for measurements.
The connectors in gray show the pinout for a revised pcb that changes the pressure, temperature, humidity sensor to a BME280 in order to use the SPI bus instead of I2C so that I2C is free for the measurement board to use
26-pin IDC on original I2C breakout board |  | 26-pin IDC on new SPI breakout board |  | 30-pin IDC on original I2C breakout board |  | 30-pin IDC on new SPI breakout board |  | 60-pin IDC on original I2C switch board |  | 60-pin IDC on new SPI switch board
connector pin # | Die Pad # | connector pin # | Die Pad # | connector pin # | Die Pad # | connector pin # | Die Pad # | connector pin # | Die Pad # | connector pin # | Die Pad # | Die Pad Numbering
1 | Com1 | 1 | Com1 | 1 | Com2 | 1 | Com2 | 1 | COM1 | 1 | COM1 | A1 |  | Com1 | Com2 |  | L1
2 | NC | 2 | NC | 2 | NC | 2 | NC | 2 | COM2 | 2 | COM2 |  | A2 |  |  | L2
3 | A1 | 3 | A1 | 3 | L1 | 3 | L1 | 3 | AQ | 3 | AQ | B2 |  | B1 | M1 |  | M2
4 | A2 | 4 | A2 | 4 | L2 | 4 | L2 | 4 | A2 | 4 | A2 |  | C1 |  |  | N1
5 | B1 | 5 | B1 | 5 | M1 | 5 | M1 | 5 | B1 | 5 | B1 | D1 |  | C2 | N2 |  | O1
6 | B2 | 6 | B2 | 6 | M2 | 6 | M2 | 6 | B2 | 6 | B2 |  | D2 |  |  | O2
7 | C1 | 7 | C1 | 7 | N1 | 7 | N1 | 7 | C1 | 7 | C1 | E2 |  | E1 | P1 |  | P2
8 | C2 | 8 | C2 | 8 | N2 | 8 | N2 | 8 | C2 | 8 | C2 |  | F1 |  |  | Q1
9 | D1 | 9 | D1 | 9 | O1 | 9 | O1 | 9 | D1 | 9 | D1 | F2 |  | G1 | R1 |  | Q2
10 | D2 | 10 | D2 | 10 | O2 | 10 | O2 | 10 | D2 | 10 | D2 |  | G2 |  |  | R2
11 | E1 | 11 | E1 | 11 | P1 | 11 | P1 | 11 | E1 | 11 | E1 | H1 |  | H2 | S2 |  | S1
12 | E2 | 12 | E2 | 12 | P2 | 12 | P2 | 12 | E2 | 12 | E2 |  | I1 |  |  | T1
13 | F1 | 13 | F1 | 13 | Q1 | 13 | Q1 | 13 | F1 | 13 | F1 | I2 |  | U1 | U1 |  | T2
14 | F2 | 14 | F2 | 14 | Q2 | 14 | Q2 | 14 | F2 | 14 | F2 |  | U2 |  |  | U2
15 | G1 | 15 | G1 | 15 | R1 | 15 | R1 | 15 | G1 | 15 | G1 | K1 |  | K2 | V2 |  | V1
16 | G2 | 16 | G2 | 16 | R2 | 16 | R2 | 16 | G2 | 16 | G2 | NEADAISY
17 | H1 | 17 | H1 | 17 | S1 | 17 | S1 | 17 | H1 | 17 | H1
18 | H2 | 18 | H2 | 18 | S2 | 18 | S2 | 18 | H2 | 18 | H2
19 | I1 | 19 | I1 | 19 | T1 | 19 | T1 | 19 | I1 | 19 | I1
20 | I2 | 20 | I2 | 20 | T2 | 20 | T2 | 20 | I2 | 20 | I2
21 | J1 | 21 | J1 | 21 | U1 | 21 | U1 | 21 | J1 | 21 | J1
22 | J2 | 22 | J2 | 22 | U2 | 22 | U2 | 22 | J2 | 22 | J2
23 | K1 | 23 | K1 | 23 | V1 | 23 | V1 | 23 | K1 | 23 | K1
24 | K2 | 24 | K2 | 24 | V2 | 24 | V2 | 24 | K2 | 24 | K2
25 | NC | 25 | SIMO | 25 | VDD | 25 | VDD | 25 | L1 | 25 | L1
26 | NC | 26 | SOMI | 26 | LED2 | 26 | LED2 | 26 | L2 | 26 | L2
 |  |  |  | 27 | LED1 | 27 | LED1 | 27 | M1 | 27 | M1
 |  |  |  | 28 | SDA | 28 | *CS | 28 | M2 | 28 | M2
 |  |  |  | 29 | SCL | 29 | SCL | 29 | N1 | 29 | N1
 |  |  |  | 30 | GND | 30 | GND | 30 | N2 | 30 | N2
 |  |  |  |  |  |  |  | 31 | O1 | 31 | O1
 |  |  |  |  |  |  |  | 32 | O2 | 32 | O2
 |  |  |  |  |  |  |  | 33 | P1 | 33 | P1
 |  |  |  |  |  |  |  | 34 | P2 | 34 | P2
 |  |  |  |  |  |  |  | 35 | Q1 | 35 | Q1
 |  |  |  |  |  |  |  | 36 | Q2 | 36 | Q2
 |  |  |  |  |  |  |  | 37 | R1 | 37 | R1
 |  |  |  |  |  |  |  | 38 | R2 | 38 | R2
 |  |  |  |  |  |  |  | 39 | S1 | 39 | S1
 |  |  |  |  |  |  |  | 40 | S2 | 40 | S2
 |  |  |  |  |  |  |  | 41 | T1 | 41 | T1
 |  |  |  |  |  |  |  | 42 | T2 | 42 | T2
 |  |  |  |  |  |  |  | 43 | U1 | 43 | U1
 |  |  |  |  |  |  |  | 44 | U2 | 44 | U2
 |  |  |  |  |  |  |  | 45 | V1 | 45 | V1
 |  |  |  |  |  |  |  | 46 | V2 | 46 | V2
 |  |  |  |  |  |  |  | 47 | LED1 | 47 | LED1
 |  |  |  |  |  |  |  | 48 | LED2 | 48 | LED2
 |  |  |  |  |  |  |  | 49 | SDA | 49 | *CS
 |  |  |  |  |  |  |  | 50 | SCL | 50 | SCL
 |  |  |  |  |  |  |  | 51 | 5V | 51 | 5V
 |  |  |  |  |  |  |  | 52 | 5V | 52 | 5V
 |  |  |  |  |  |  |  | 53 | 5V | 53 | 5V
 |  |  |  |  |  |  |  | 54 | 3V3 | 54 | SIMO
 |  |  |  |  |  |  |  | 55 | 3V3 | 55 | 3V3
 |  |  |  |  |  |  |  | 56 | 3V3 | 56 | 3V3
 |  |  |  |  |  |  |  | 57 | NC | 57 | SOMI
 |  |  |  |  |  |  |  | 58 | GND | 58 | GND
 |  |  |  |  |  |  |  | 59 | GND | 59 | GND
 |  |  |  |  |  |  |  | 60 | GND | 60 | GND
