tawender/Sensor_Research_System_Hardware/pcb-measurement board/New folder/nea_research_current_measurement.xls

Sheet: calculated
Vbias | 0.5
Rsense | 10
Rhigh | 40000
Rlow | 1000 |  | gain | 160
Ihigh | 1.25e-05 |  | Vhigh | 0.020
Ilow | 0.0005 |  | Vlow | 0.800
Resistance (kohms) | Vout (volts) | Sensor Current (uAmps)
1 | 0.8000 | 500
2 | 0.4000 | 250
3 | 0.2667 | 166.6666667
4 | 0.2000 | 125
5 | 0.1600 | 100
6 | 0.1333 | 83.33333333
7 | 0.1143 | 71.42857143
8 | 0.1000 | 62.5
9 | 0.0889 | 55.55555556
10 | 0.0800 | 50
11 | 0.0727 | 45.45454545
12 | 0.0667 | 41.66666667
13 | 0.0615 | 38.46153846
14 | 0.0571 | 35.71428571
15 | 0.0533 | 33.33333333
16 | 0.0500 | 31.25
17 | 0.0471 | 29.41176471
18 | 0.0444 | 27.77777778
19 | 0.0421 | 26.31578947
20 | 0.0400 | 25
21 | 0.0381 | 23.80952381
22 | 0.0364 | 22.72727273
23 | 0.0348 | 21.73913043
24 | 0.0333 | 20.83333333
25 | 0.0320 | 20
26 | 0.0308 | 19.23076923
27 | 0.0296 | 18.51851852
28 | 0.0286 | 17.85714286
29 | 0.0276 | 17.24137931
30 | 0.0267 | 16.66666667
31 | 0.0258 | 16.12903226
32 | 0.0250 | 15.625
33 | 0.0242 | 15.15151515
34 | 0.0235 | 14.70588235
35 | 0.0229 | 14.28571429
36 | 0.0222 | 13.88888889
37 | 0.0216 | 13.51351351
38 | 0.0211 | 13.15789474
39 | 0.0205 | 12.82051282
40 | 0.0200 | 12.5
41 | 0.0195 | 12.19512195
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
