tawender/Sensor_Research_System_Hardware/hose_barb.pdf

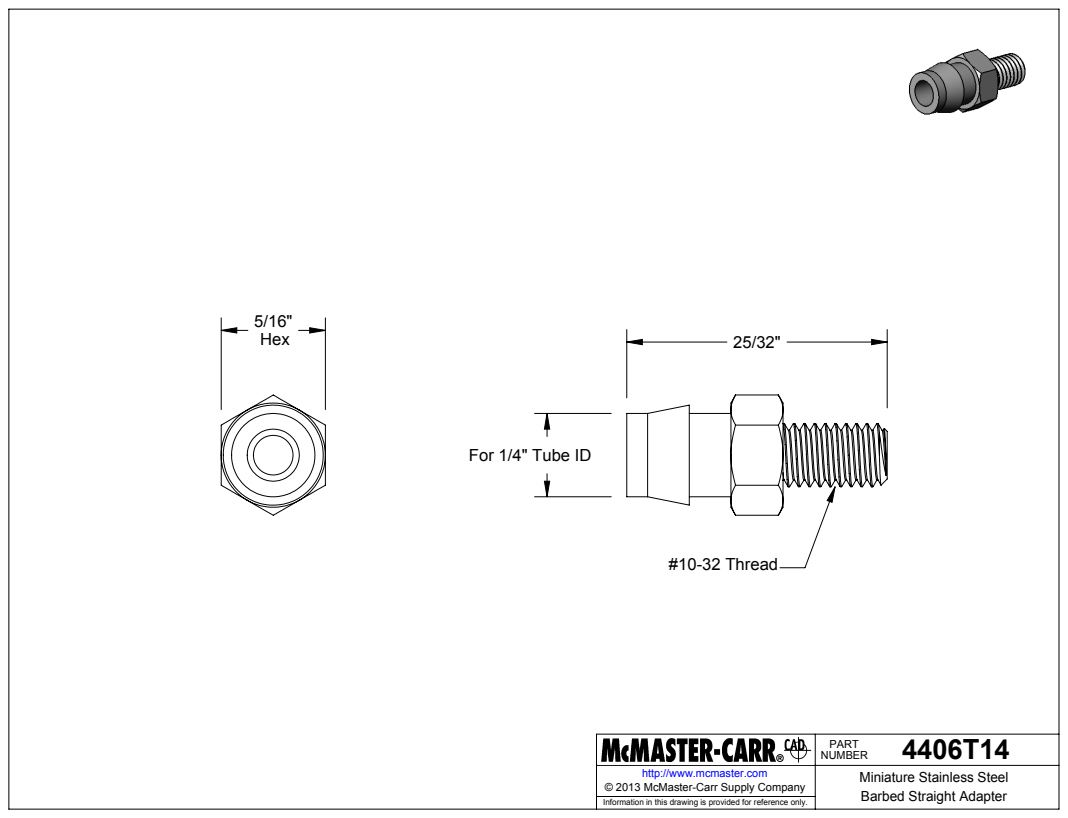
[picture p43: page 1]
#10-32 Thread

For 1/4" Tube ID

4406T14 PART NUMBER

http://www.mcmaster.com | Miniature Stainless Steel Barbed Straight Adapter © 2013 McMaster-Carr Supply Company

Information in this drawing is provided for reference only.
