tawender/Sensor_Research_System_Hardware/pcb-measurement board/Schematic-NEA_research_fixture_measurement_board.pdf

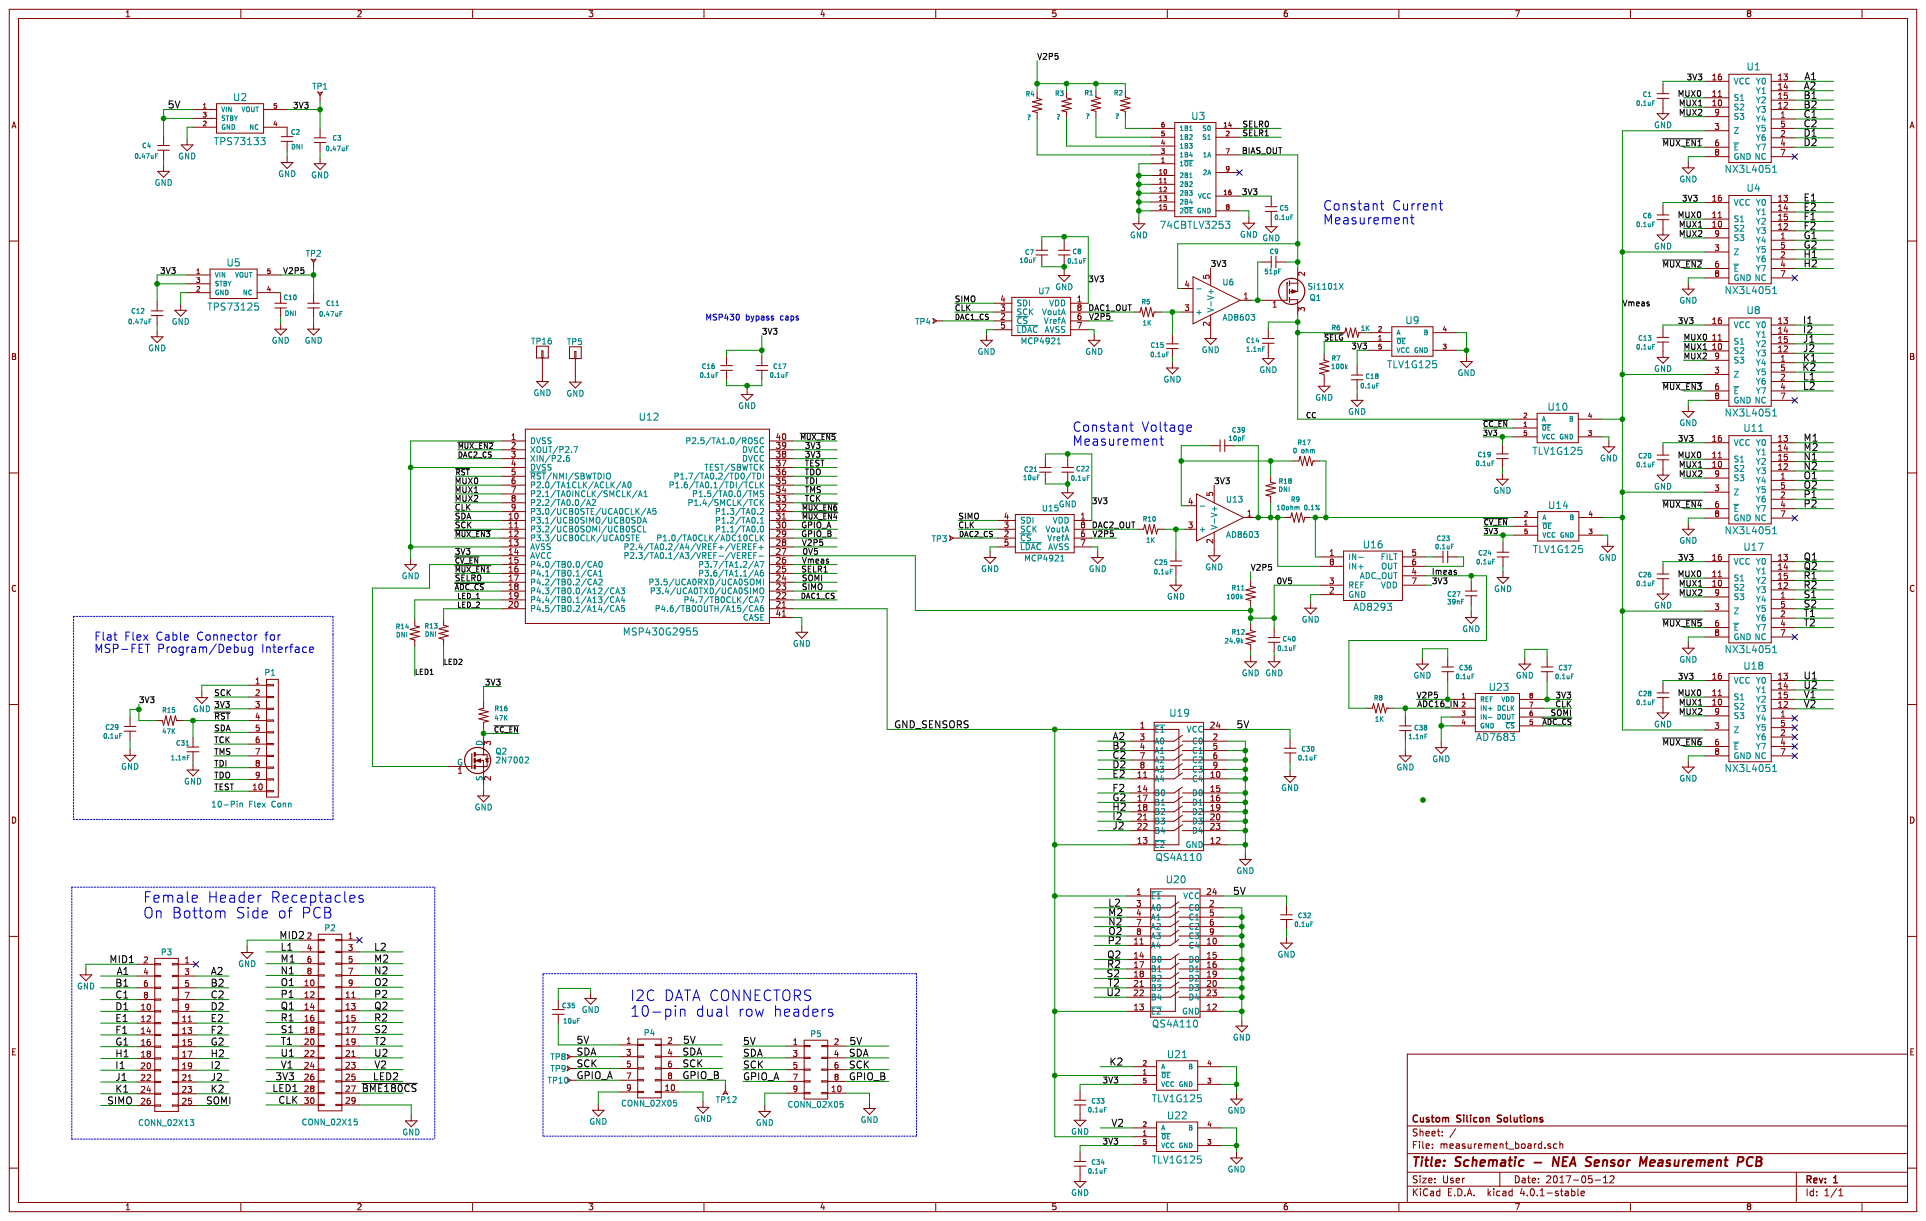
[picture p44: page 1]
