tawender/Sensor_Research_System_Hardware/pcb-breakout/rev2/nea_fixture_breakout_board_rev2_schematic.pdf

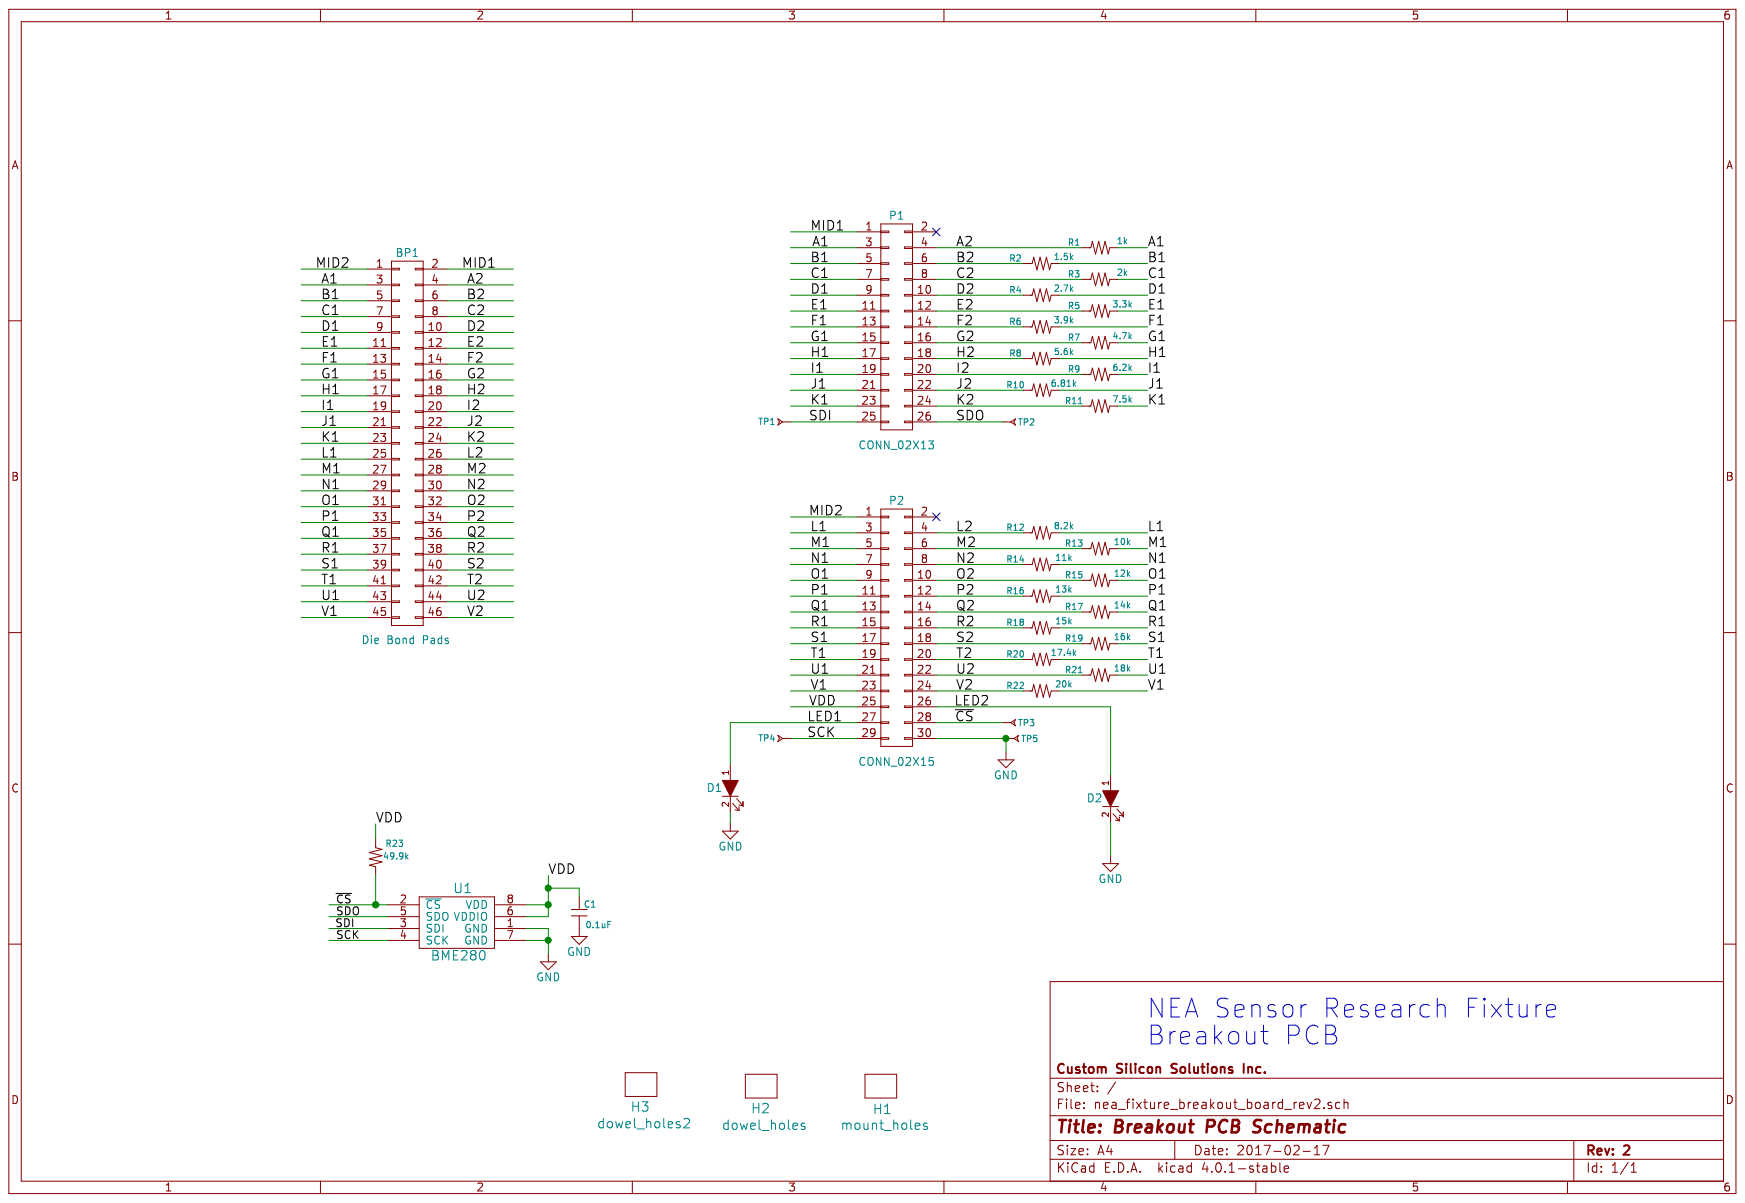
[picture p45: page 1]
