tawender/Sensor_Research_System_Hardware/pcb-switch_board/rev2/pcb-switch_board_schematic_rev2.pdf

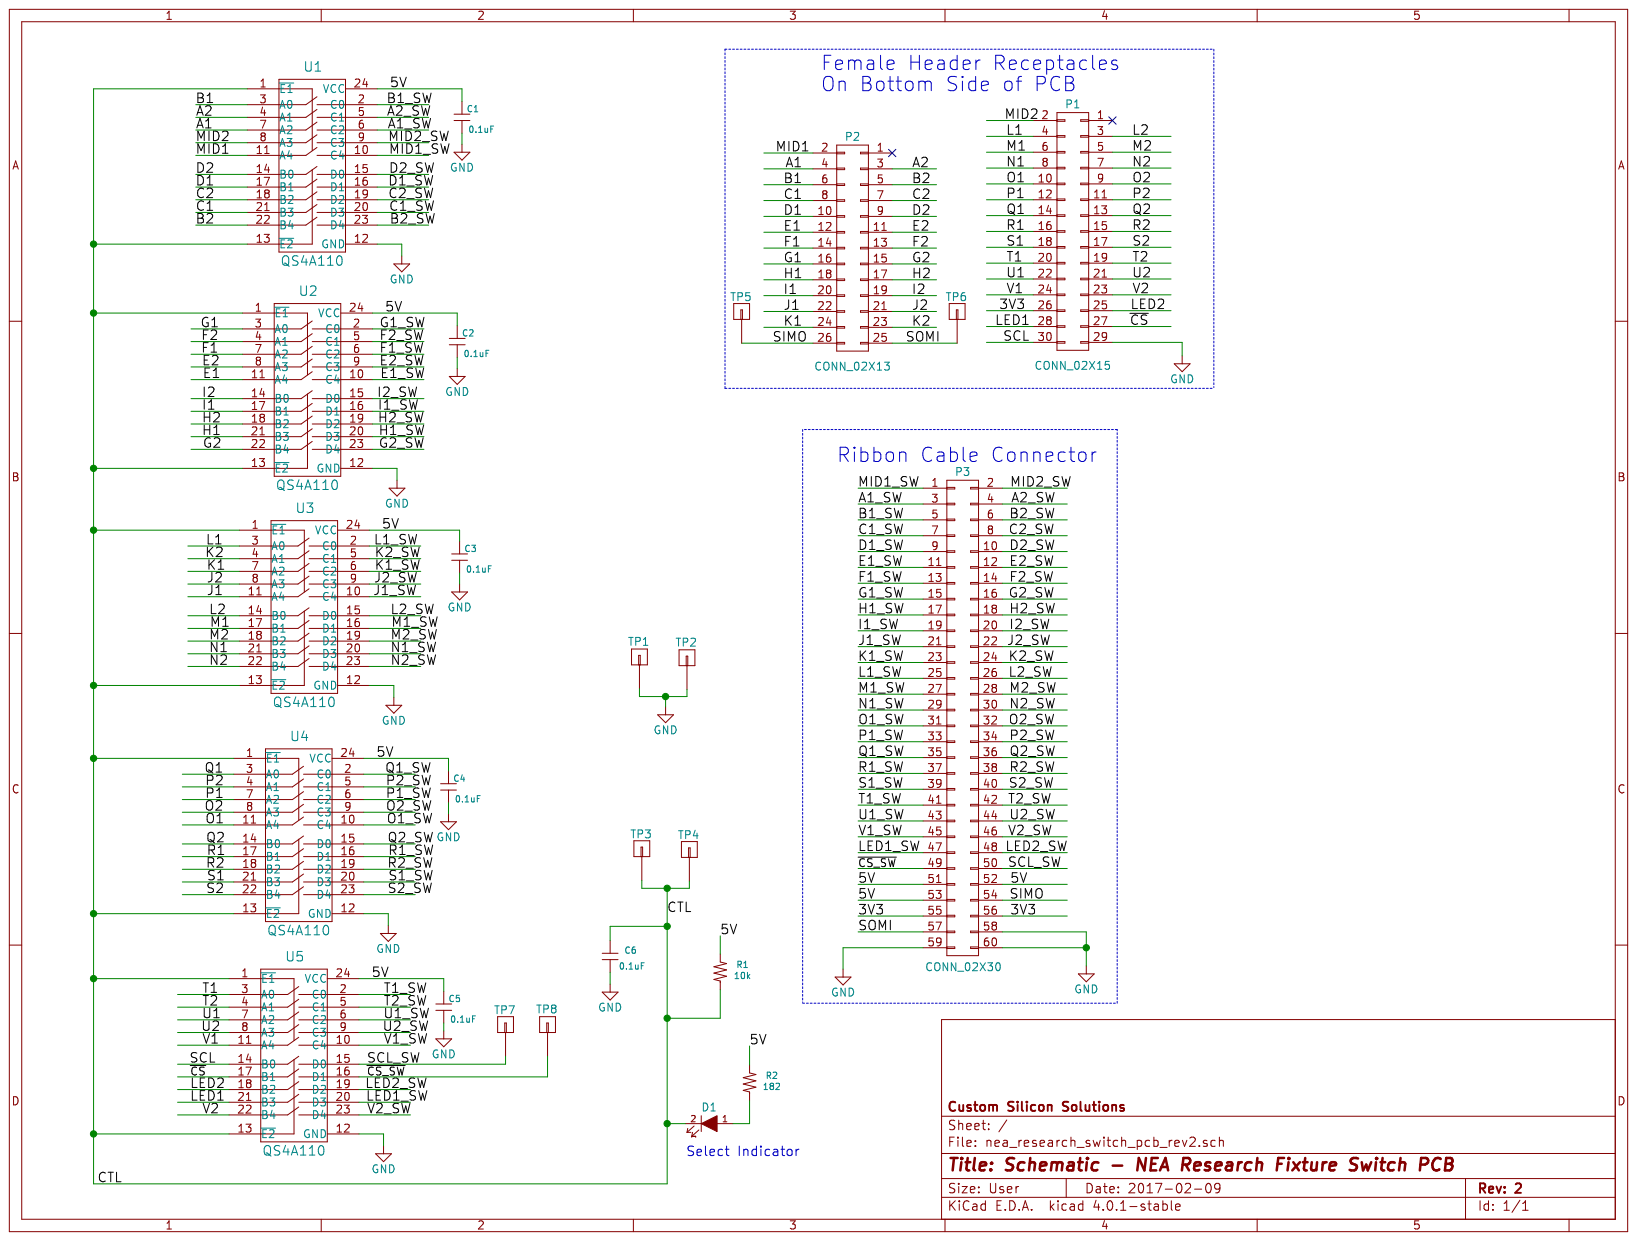
[picture p46: page 1]
