tawender/Sensor_Research_System_Hardware/pcb-control_board/nea_research_control_board_sch.pdf

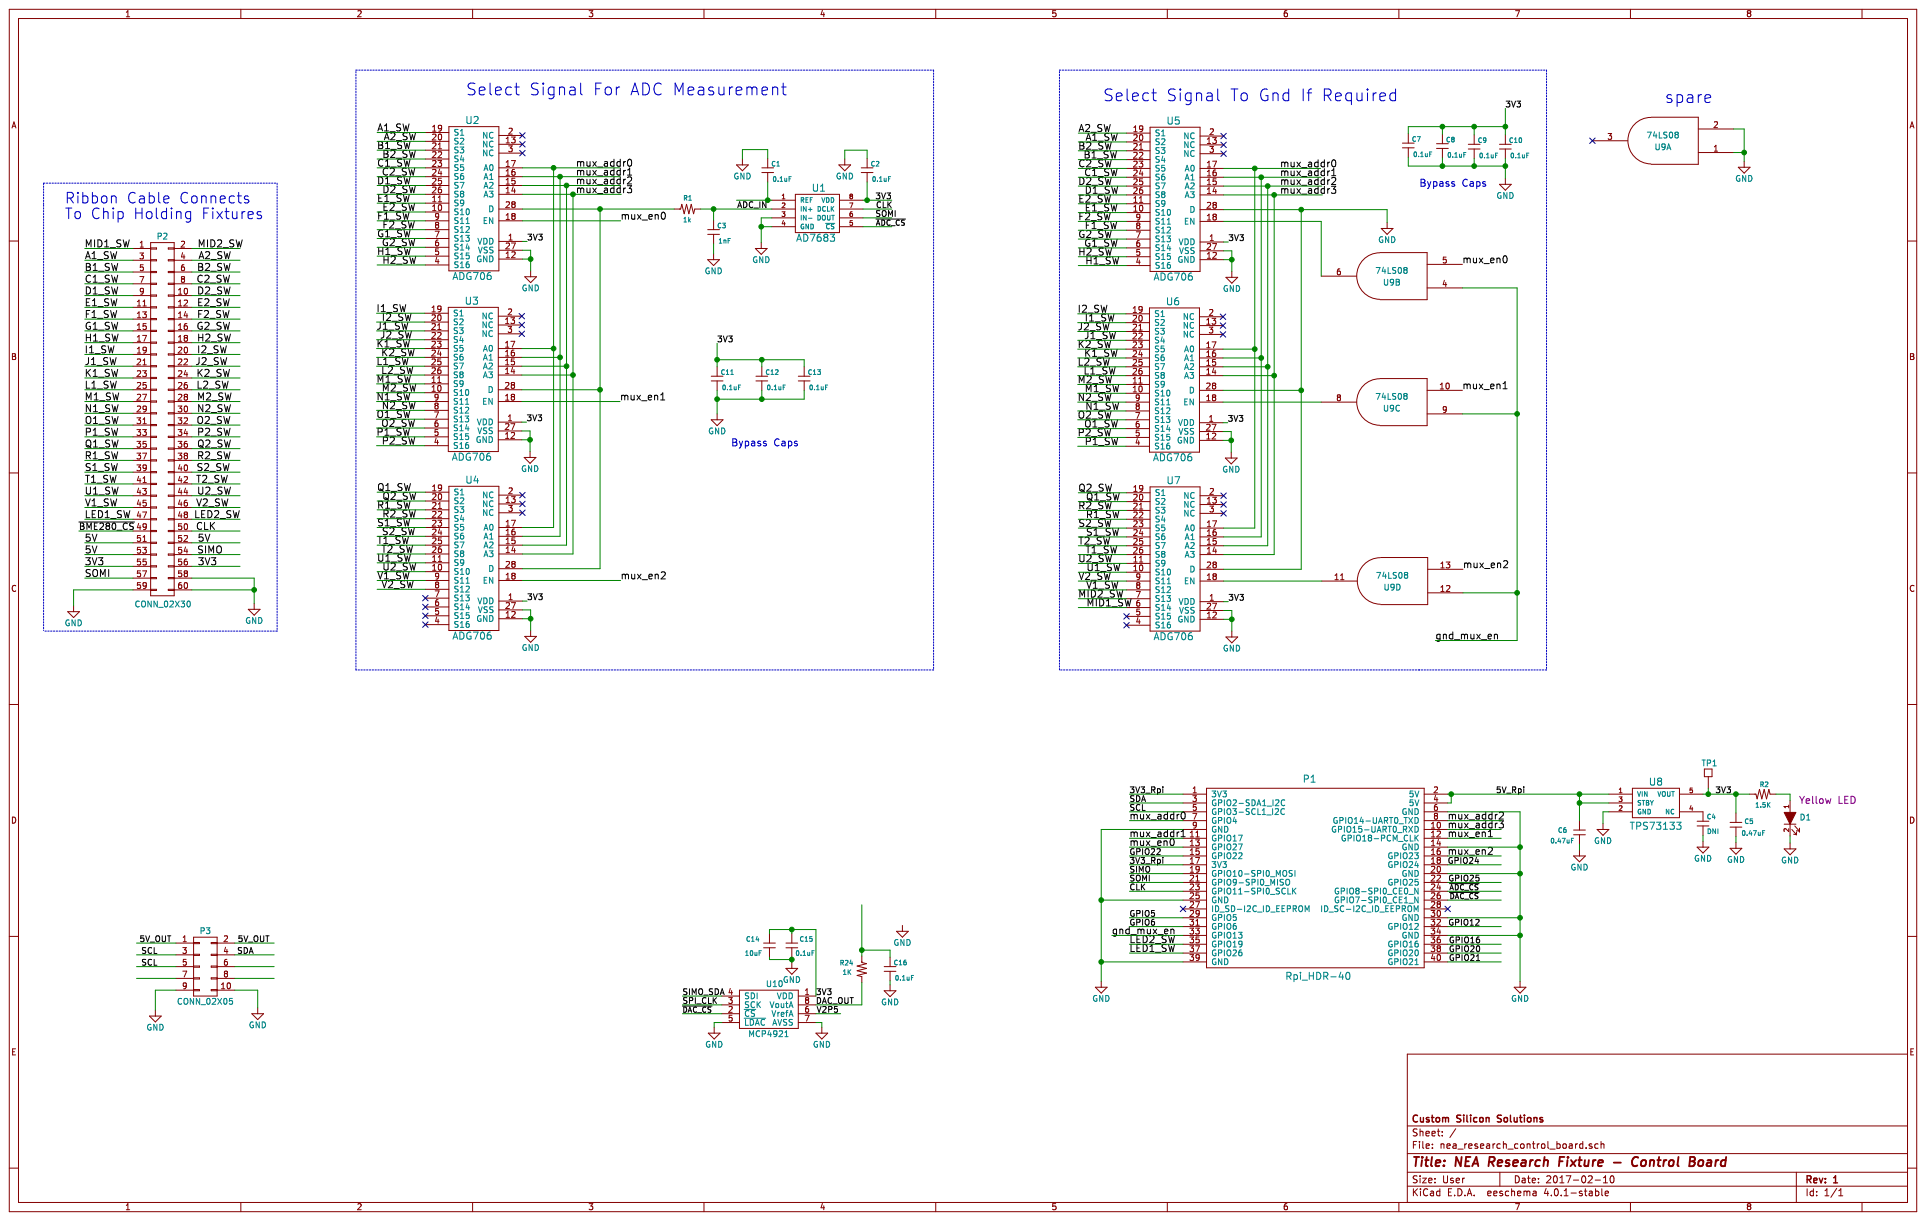
[picture p47: page 1]
