tawender/Sensor_Research_System_Hardware/pcb-breakout/rev1/nea_fixture_breakout_board_schematic-R1.pdf

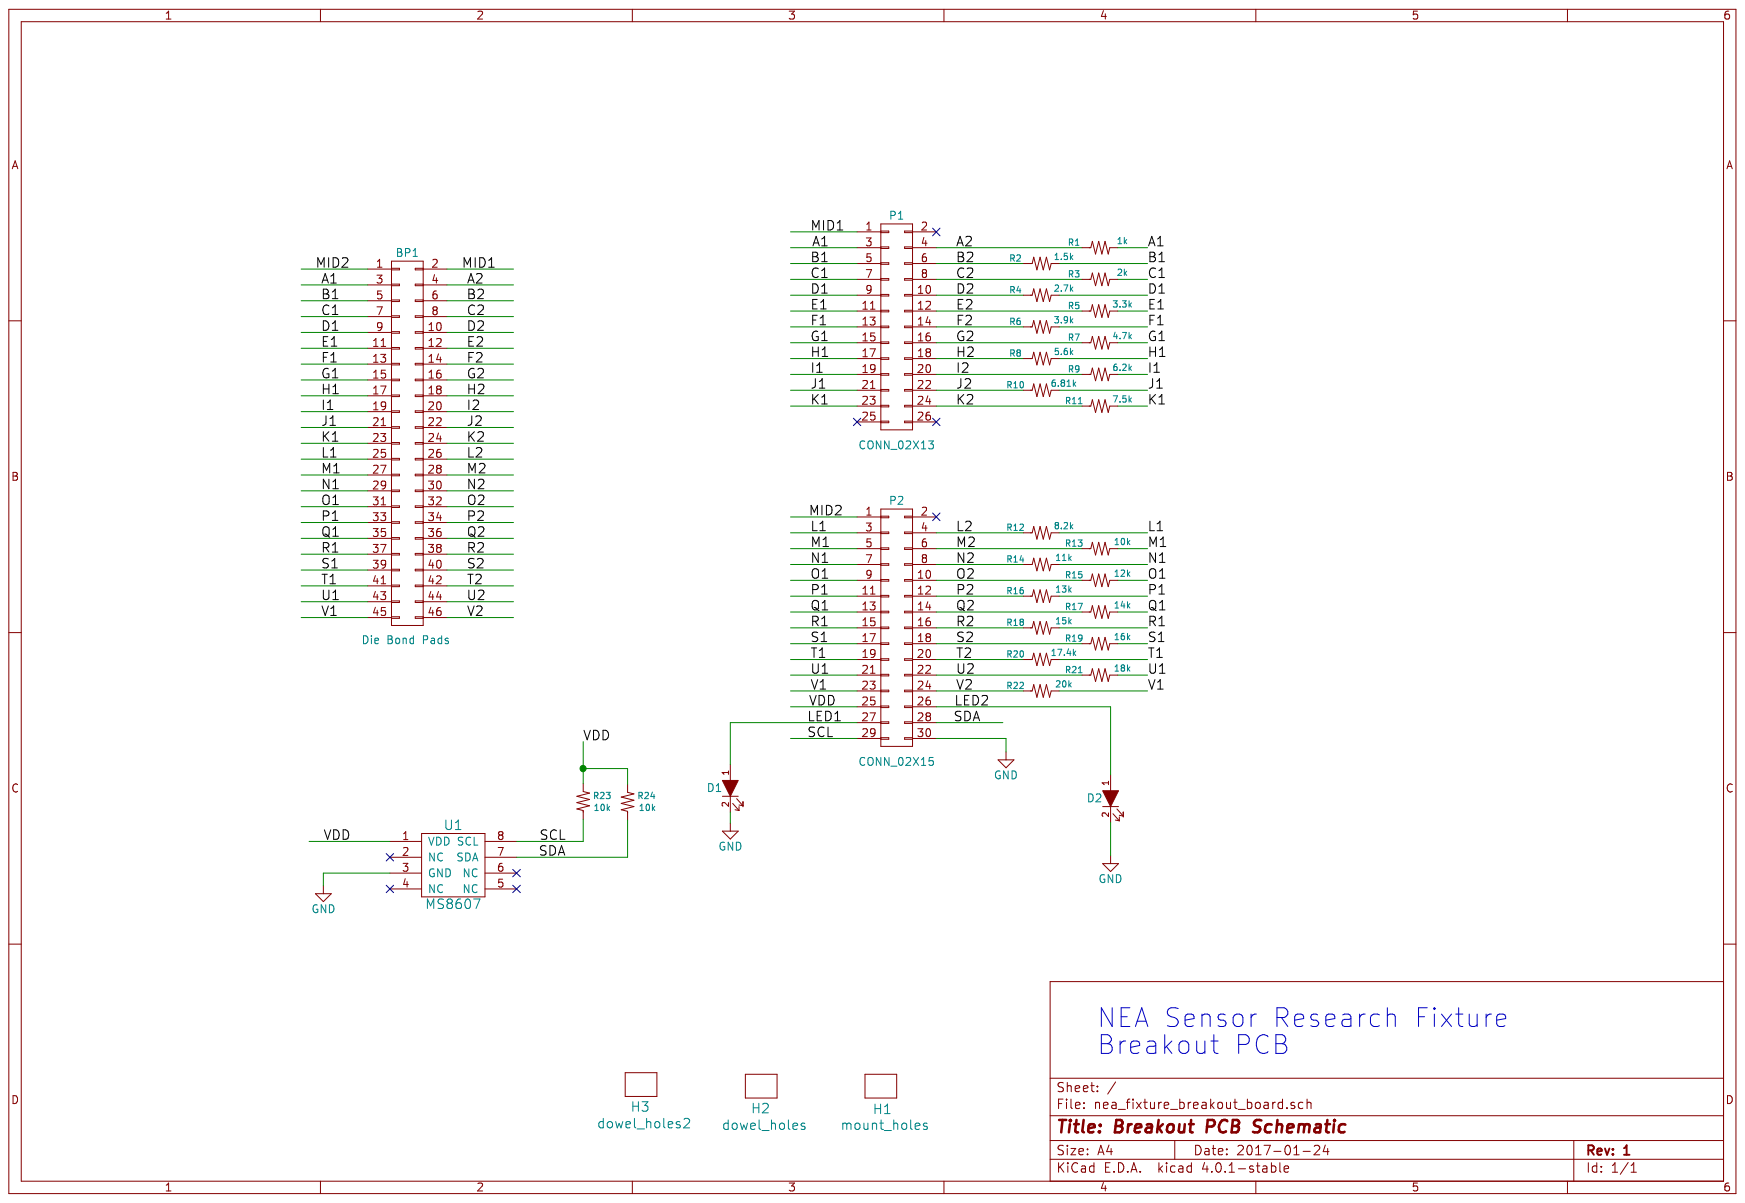
[picture p48: page 1]
