tawender/Sensor_Research_System_Hardware/pcb-switch_board/rev1/nea_research_fixture_switch_board_schematic_rev1.pdf

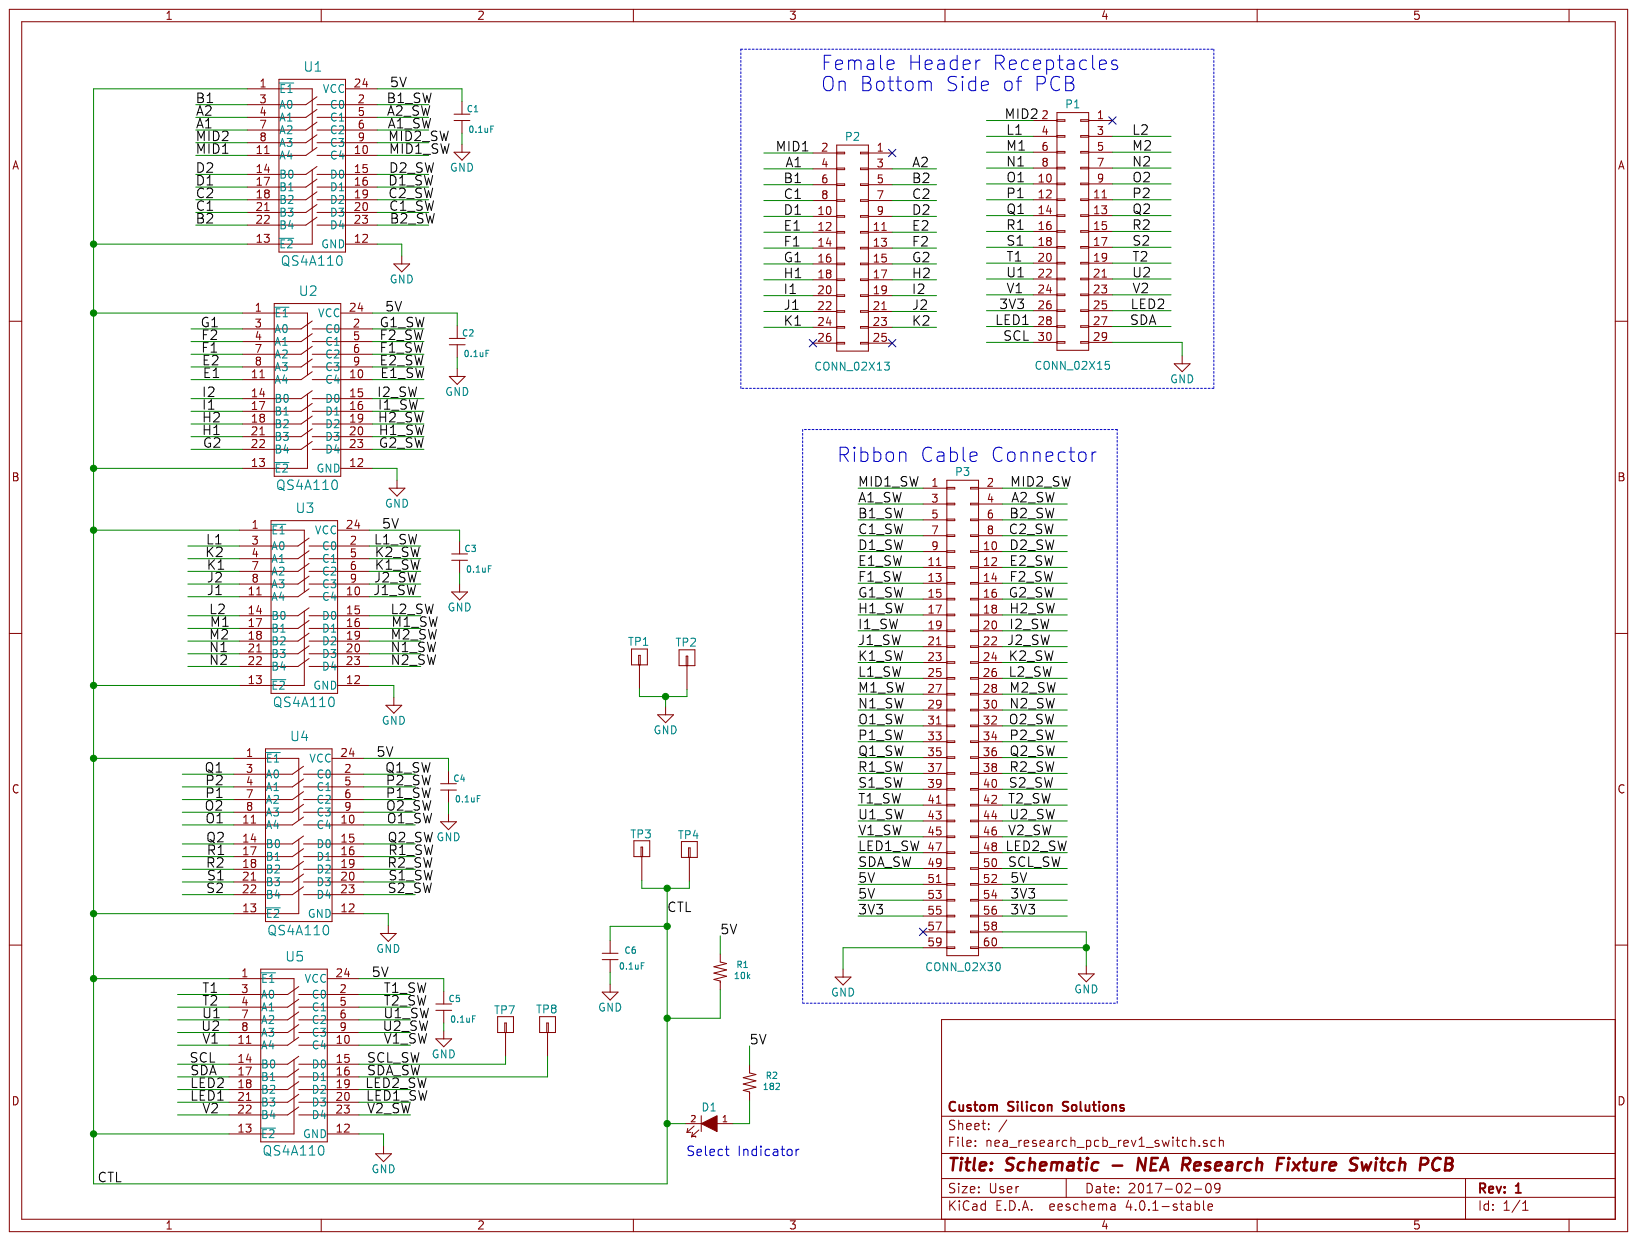
[picture p49: page 1]
