tawender/Sensor_Research_System_Hardware/pcb-measurement board/measurement_board.kicad_pcb

## KiCad design pcb-measurement board/measurement_board.kicad_pcb (2017-07-20)

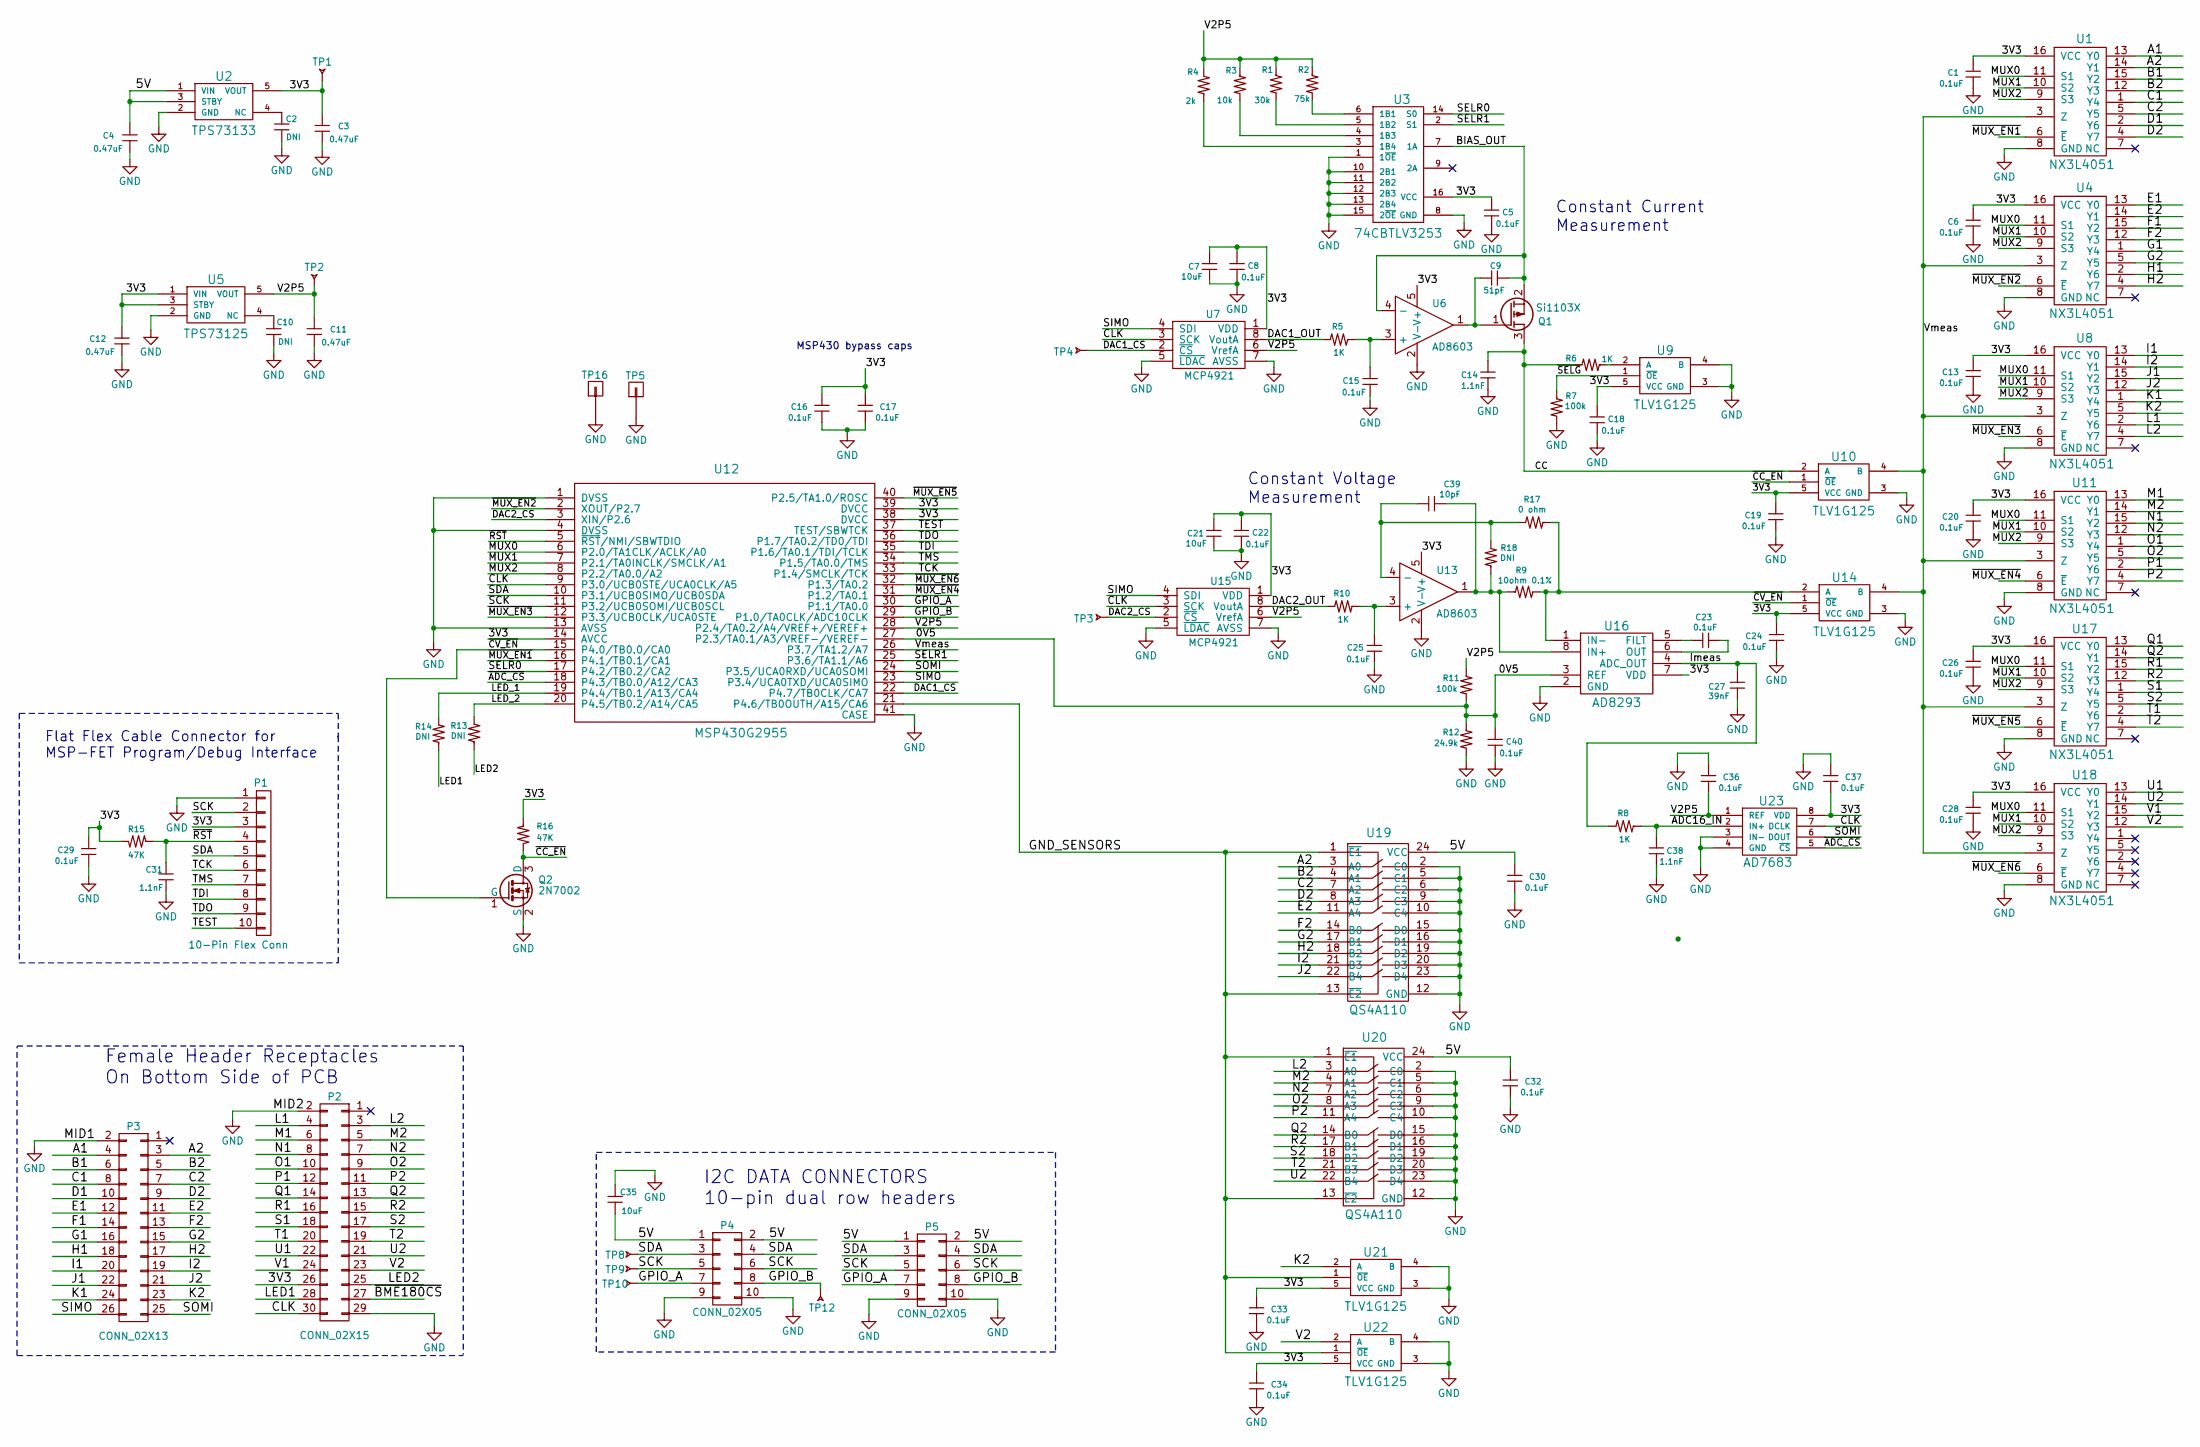
[picture p50: schematic measurement_board.sch, Schematic - NEA Sensor Measurement PCB]

Parts:
C1, C5, C6, C8, C13, C15, C16, C17, C18, C19, C20, C22, C23, C24, C25, C26, C28, C29, C36, C37, C40: 0.1uF; 0603; manufacturer pn GRM188R71C104KA01D
C2, C10: DNI; 0603; manufacturer pn NA
C3, C4, C11, C12: 0.47uF; 0603; manufacturer pn CL10A474KP8NNNC
C7, C21, C35: 10uF; 0603; manufacturer pn GRM188R60J106ME47D
C9: 51pF; 0603; manufacturer pn GRM1885C1H510JA01D
C14, C31, C38: 1.1nF; 0603; manufacturer pn GRM1885C1H112JA01D
C27: 39nF; 0603; manufacturer pn C0603C393K4RACTU
C30, C32, C33, C34: 0.1uF; R_0603_HandSoldering; manufacturer pn GRM188R71C104KA01D
C39: 10pF; 0402; manufacturer pn GRM1555C1H100JA01D
P1: 10-Pin Flex Conn; WM6745-FPC; manufacturer pn 0512811094
P2: CONN_02X15; Pin_Header_Straight_2x15_Pitch2.54mm; manufacturer pn 1-534998-5
P3: CONN_02X13; Pin_Header_Straight_2x13_Pitch2.54mm; manufacturer pn 1-534998-3
P4: CONN_02X05; header_2x5_idc; manufacturer pn PREC040DAAN-RC
P5: CONN_02X05; header_2x5_idc
Q1: Si1103X; SOT23; manufacturer pn SI1013X-T1-GE3
Q2: 2N7002; SOT23; manufacturer pn 2N7002-7-F
R1: 30k; 0603; manufacturer pn RC0603FR-0730KL
R2: 75k; 0603; manufacturer pn RC0603FR-0775KL
R3: 10k; 0603; manufacturer pn RC0603FR-0710KL
R4: 2k; 0603; manufacturer pn RC0603FR-072KL
R5, R6, R8, R10: 1K; 0603; manufacturer pn RC0603FR-071KLL
R7, R11: 100k; 0603; manufacturer pn RC0603FR-07100KL
R9: 10ohm 0.1%; 0805; manufacturer pn 2-1625868-7
R12: 24.9k; 0603; manufacturer pn RC0603FR-0724K9L
R13, R14: DNI; 0603
R15, R16: 47K; 0603; manufacturer pn RC0603FR-0747KL
R17: 0 ohm; 0402; manufacturer pn RC0402JR-070RL
R18: DNI; 0402; manufacturer pn RC0402JR-070RL
TP1, TP2, TP3, TP4, TP8, TP9, TP10, TP12: TP_SMT; TP_SMT.02
TP5, TP16: header_pin; Header_Pin_Rnd
U1, U4, U8, U11, U17, U18: NX3L4051; TSSOP16; manufacturer pn NX3L4051PW-118
U2: TPS73133; SOT23-5; manufacturer pn TPS73133DBVR
U3: 74CBTLV3253; DHVQFN16; manufacturer pn 74CBTLV3253BQ-115
U5: TPS73125; SOT23-5; manufacturer pn TPS73125DBVT
U6, U13: AD8603; SOT23-5; manufacturer pn AD8603AUJZ-REEL7
U7, U15: MCP4921; MSOP-8; manufacturer pn MCP4921T-E/MS
U9, U10, U14, U21, U22: TLV1G125; SOT23-5; manufacturer pn SN74CBTLV1G125DBVR
U12: MSP430G2955; VQFN40; manufacturer pn MSP430G2955IRHA40R
U16: AD8293; SOT23-8; manufacturer pn AD8293G160ARJZ-R7
U19, U20: QS4A110; QSOP-24; manufacturer pn QS4A110QG
U23: AD7683; RM-8; manufacturer pn AD7683ARMZRL7

Connections:
/0V5: C40.1, R11.1, R12.2, U12.27 (P2.3/TA0.1/A3/VREF-/VEREF-), U16.3 (REF)
/3V3: C1.1, C3.1, C5.1, C6.1, C7.1, C8.1, C12.1, C13.1, C16.1, C17.1, C18.1, C19.1, C20.1, C21.1, C22.1, C24.1, C26.1, C28.1, C29.1, C33.1, C34.1, C37.2, P1.3, P2.26, R15.1, R16.2, TP1.1, U1.16 (VCC), U2.5 (VOUT), U3.16 (VCC), U4.16 (VCC), U5.1 (VIN), U5.3 (STBY), U6.5 (V+), U7.1 (VDD), U8.16 (VCC), U9.5 (VCC), U10.5 (VCC), U11.16 (VCC), U12.14 (AVCC), U12.38 (DVCC), U12.39 (DVCC), U13.5 (V+), U14.5 (VCC), U15.1 (VDD), U16.7 (VDD), U17.16 (VCC), U18.16 (VCC), U21.5 (VCC), U22.5 (VCC), U23.8 (VDD)
/5V: C4.1, C30.1, C32.1, C35.2, P4.1, P4.2, P5.1, P5.2, U2.1 (VIN), U2.3 (STBY), U19.24 (VCC), U20.24 (VCC)
/A1: P3.4, U1.13 (Y0)
/A2: P3.3, U1.14 (Y1), U19.3 (A0)
/ADC16_IN: C38.1, R8.2, U23.2 (IN+)
/B1: P3.6, U1.15 (Y2)
/B2: P3.5, U1.12 (Y3), U19.4 (A1)
/BIAS_OUT: C9.1, Q1.2 (S), U3.7 (1A), U6.4 (-)
/C1: P3.8, U1.1 (Y4)
/C2: P3.7, U1.5 (Y5), U19.7 (A2)
/CC: C14.1, Q1.3 (D), R6.1, U10.2 (A)
/CLK: P2.30, U7.3 (SCK), U12.9 (P3.0/UCB0STE/UCA0CLK/A5), U15.3 (SCK), U23.7 (DCLK)
/D1: P3.10, U1.2 (Y6)
/D2: P3.9, U1.4 (Y7), U19.8 (A3)
/DAC1_CS: TP4.1, U7.2 (~CS~), U12.22 (P4.7/TB0CLK/CA7)
/DAC1_OUT: R5.1, U7.8 (VoutA)
/DAC2_CS: TP3.1, U12.3 (XIN/P2.6), U15.2 (~CS~)
/DAC2_OUT: R10.1, U15.8 (VoutA)
/E1: P3.12, U4.13 (Y0)
/E2: P3.11, U4.14 (Y1), U19.11 (A4)
/F1: P3.14, U4.15 (Y2)
/F2: P3.13, U4.12 (Y3), U19.14 (B0)
/G1: P3.16, U4.1 (Y4)
/G2: P3.15, U4.5 (Y5), U19.17 (B1)
/GND_SENSORS: U12.21 (P4.6/TB0OUTH/A15/CA6), U19.1 (~E1), U19.13 (~E2), U20.1 (~E1), U20.13 (~E2), U21.1 (~OE), U22.1 (~OE)
/GPIO_A: P4.7, P5.7, TP10.1, U12.30 (P1.1/TA0.0)
/GPIO_B: P4.8, P5.8, TP12.1, U12.29 (P1.0/TA0CLK/ADC10CLK)
/H1: P3.18, U4.2 (Y6)
/H2: P3.17, U4.4 (Y7), U19.18 (B2)
/I1: P3.20, U8.13 (Y0)
/I2: P3.19, U8.14 (Y1), U19.21 (B3)
/Imeas: C27.1, R8.1, U16.4 (ADC_OUT)
/J1: P3.22, U8.15 (Y2)
/J2: P3.21, U8.12 (Y3), U19.22 (B4)
/K1: P3.24, U8.1 (Y4)
/K2: P3.23, U8.5 (Y5), U21.2 (A)
/L1: P2.4, U8.2 (Y6)
/L2: P2.3, U8.4 (Y7), U20.3 (A0)
/LED1: P2.28, R14.2
/LED2: P2.25, R13.2
/LED_1: R14.1, U12.19 (P4.4/TB0.1/A13/CA4)
/LED_2: R13.1, U12.20 (P4.5/TB0.2/A14/CA5)
/M1: P2.6, U11.13 (Y0)
/M2: P2.5, U11.14 (Y1), U20.4 (A1)
/MUX0: U1.11 (S1), U4.11 (S1), U8.11 (S1), U11.11 (S1), U12.6 (P2.0/TA1CLK/ACLK/A0), U17.11 (S1), U18.11 (S1)
/MUX1: U1.10 (S2), U4.10 (S2), U8.10 (S2), U11.10 (S2), U12.7 (P2.1/TA0INCLK/SMCLK/A1), U17.10 (S2), U18.10 (S2)
/MUX2: U1.9 (S3), U4.9 (S3), U8.9 (S3), U11.9 (S3), U12.8 (P2.2/TA0.0/A2), U17.9 (S3), U18.9 (S3)
/N1: P2.8, U11.15 (Y2)
/N2: P2.7, U11.12 (Y3), U20.7 (A2)
/O1: P2.10, U11.1 (Y4)
/O2: P2.9, U11.5 (Y5), U20.8 (A3)
/P1: P2.12, U11.2 (Y6)
/P2: P2.11, U11.4 (Y7), U20.11 (A4)
/Q1: P2.14, U17.13 (Y0)
/Q2: P2.13, U17.14 (Y1), U20.14 (B0)
/R1: P2.16, U17.15 (Y2)
/R2: P2.15, U17.12 (Y3), U20.17 (B1)
/S1: P2.18, U17.1 (Y4)
/S2: P2.17, U17.5 (Y5), U20.18 (B2)
/SCK: P1.2, P4.5, P4.6, P5.5, P5.6, TP9.1, U12.11 (P3.2/UCB0SOMI/UCB0SCL)
/SDA: P1.5, P4.3, P4.4, P5.3, P5.4, TP8.1, U12.10 (P3.1/UCB0SIMO/UCB0SDA)
/SELR0: U3.14 (S0), U12.17 (P4.2/TB0.2/CA2)
/SELR1: U3.2 (S1), U12.25 (P3.6/TA1.1/A6)
/SIMO: P3.26, U7.4 (SDI), U12.23 (P3.4/UCA0TXD/UCA0SIMO), U15.4 (SDI)
/SOMI: P3.25, U12.24 (P3.5/UCA0RXD/UCA0SOMI), U23.6 (DOUT)
/T1: P2.20, U17.2 (Y6)
/T2: P2.19, U17.4 (Y7), U20.21 (B3)
/TCK: P1.6, U12.33 (P1.4/SMCLK/TCK)
/TDI: P1.8, U12.35 (P1.6/TA0.1/TDI/TCLK)
/TDO: P1.9, U12.36 (P1.7/TA0.2/TD0/TDI)
/TEST: P1.10, U12.37 (TEST/SBWTCK)
/TMS: P1.7, U12.34 (P1.5/TA0.0/TMS)
/U1: P2.22, U18.13 (Y0)
/U2: P2.21, U18.14 (Y1), U20.22 (B4)
/V1: P2.24, U18.15 (Y2)
/V2: P2.23, U18.12 (Y3), U22.2 (A)
/Vmeas: U1.3 (Z), U4.3 (Z), U8.3 (Z), U10.4 (B), U11.3 (Z), U12.26 (P3.7/TA1.2/A7), U14.4 (B), U17.3 (Z), U18.3 (Z)
/~ADC_CS: U12.18 (P4.3/TB0.0/A12/CA3), U23.5 (~CS)
/~BME180CS: P2.27
/~CC_EN: Q2.3 (D), R16.1, U10.1 (~OE)
/~CV_EN: Q2.1 (G), U12.15 (P4.0/TB0.0/CA0), U14.1 (~OE)
/~MUX_EN1: U1.6 (~E), U12.16 (P4.1/TB0.1/CA1)
/~MUX_EN2: U4.6 (~E), U12.2 (XOUT/P2.7)
/~MUX_EN3: U8.6 (~E), U12.12 (P3.3/UCB0CLK/UCA0STE)
/~MUX_EN4: U11.6 (~E), U12.31 (P1.2/TA0.1)
/~MUX_EN5: U12.40 (P2.5/TA1.0/ROSC), U17.6 (~E)
/~MUX_EN6: U12.32 (P1.3/TA0.2), U18.6 (~E)
/~RST: C31.1, P1.4, R15.2, U12.5 (~RST~/NMI/SBWTDIO)
/~SELG: R7.2, U9.1 (~OE)
GND: C1.2, C2.2, C3.2, C4.2, C5.2, C6.2, C7.2, C8.2, C10.2, C11.2, C12.2, C13.2, C14.2, C15.2, C16.2, C17.2, C18.2, C19.2, C20.2, C21.2, C22.2, C24.2, C25.2, C26.2, C27.2, C28.2, C29.2, C30.2, C31.2, C32.2, C33.2, C34.2, C35.1, C36.1, C37.1, C38.2, C40.2, P1.1, P2.2, P2.29, P3.2, P4.9, P4.10, P5.9, P5.10, Q2.2 (S), R7.1, R12.1, TP5.1, TP16.1, U1.8 (GND), U2.2 (GND), U3.1 (1~OE), U3.8 (GND), U3.10 (2B1), U3.11 (2B2), U3.12 (2B3), U3.13 (2B4), U3.15 (2~OE), U4.8 (GND), U5.2 (GND), U6.2 (V-), U7.5 (~LDAC~), U7.7 (AVSS), U8.8 (GND), U9.3 (GND), U9.4 (B), U10.3 (GND), U11.8 (GND), U12.1 (DVSS), U12.4 (DVSS), U12.13 (AVSS), U12.41 (CASE), U13.2 (V-), U14.3 (GND), U15.5 (~LDAC~), U15.7 (AVSS), U16.2 (GND), U17.8 (GND), U18.8 (GND), U19.2 (C0), U19.5 (C1), U19.6 (C2), U19.9 (C3), U19.10 (C4), U19.12 (GND), U19.15 (D0), U19.16 (D1), U19.19 (D2), U19.20 (D3), U19.23 (D4), U20.2 (C0), U20.5 (C1), U20.6 (C2), U20.9 (C3), U20.10 (C4), U20.12 (GND), U20.15 (D0), U20.16 (D1), U20.19 (D2), U20.20 (D3), U20.23 (D4), U21.3 (GND), U21.4 (B), U22.3 (GND), U22.4 (B), U23.3 (IN-), U23.4 (GND)
unnamed: C2.1, U2.4 (NC)
unnamed: C9.2, Q1.1 (G), U6.1
unnamed: C10.1, U5.4 (NC)
unnamed: C15.1, R5.2, U6.3 (+)
unnamed: C23.1, U16.6 (OUT)
unnamed: C23.2, U16.5 (FILT)
unnamed: C25.1, R10.2, U13.3 (+)
unnamed: C39.1, R9.2, R18.2, U13.1, U16.8 (IN+)
unnamed: C39.2, R17.1, R18.1, U13.4 (-)
unnamed: R1.1, U3.5 (1B2)
unnamed: R2.1, U3.6 (1B1)
unnamed: R3.1, U3.4 (1B3)
unnamed: R6.2, U9.2 (A)
unnamed: R9.1, R17.2, U14.2 (A), U16.1 (IN-)

Notes on the sheet:
MSP430 bypass caps
Female Header Receptacles On Bottom Side of PCB
Flat Flex Cable Connector for MSP-FET Program/Debug Interface
I2C DATA CONNECTORS 10-pin dual row headers
Constant Current Measurement
Constant Voltage Measurement

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
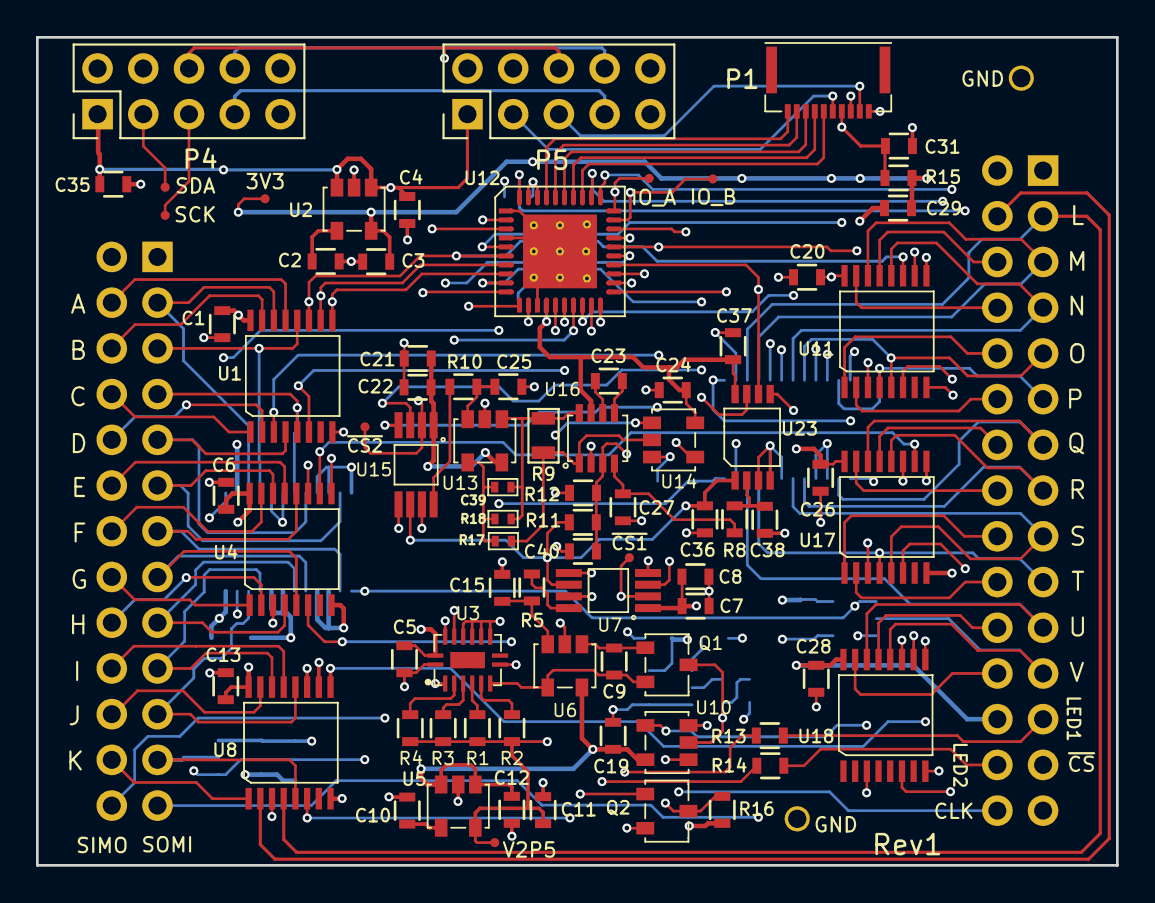
[picture p51: board pcb-measurement board/measurement_board.kicad_pcb from above]

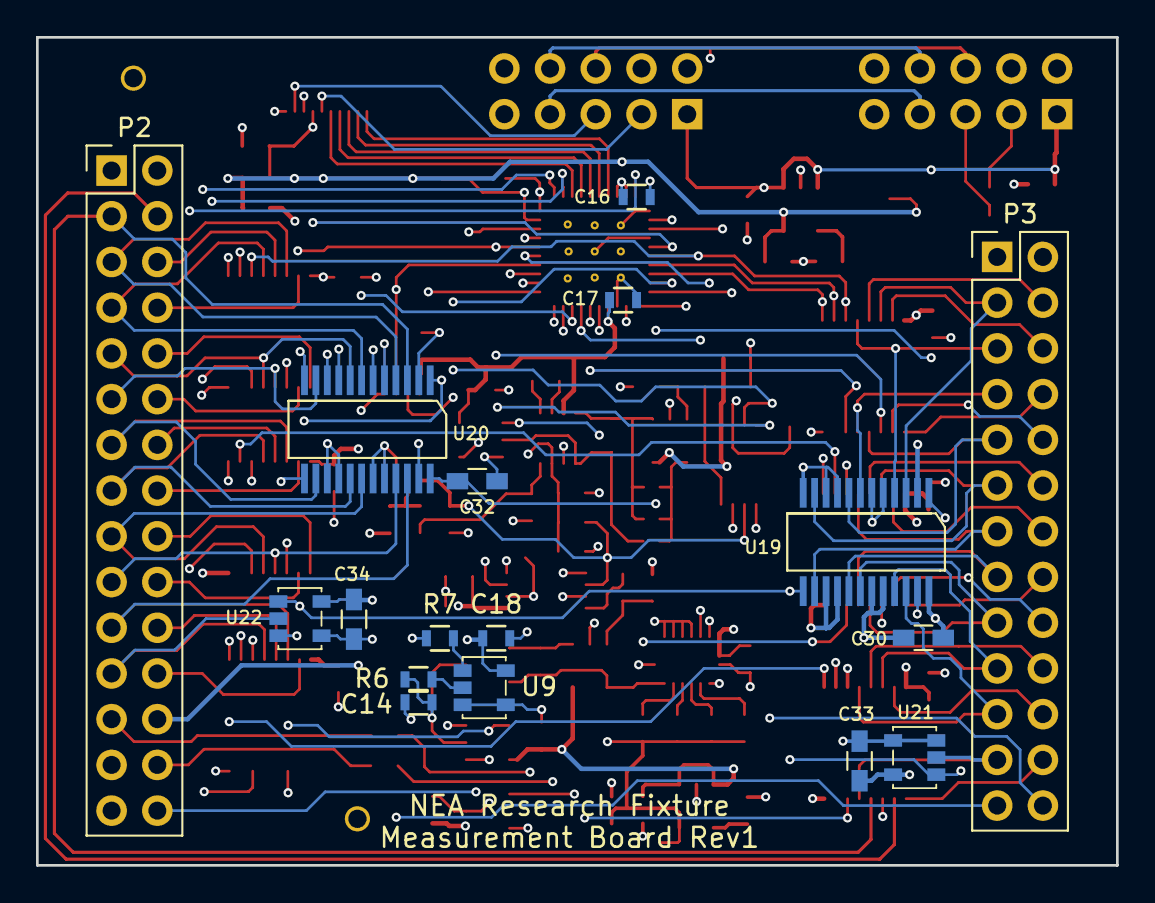
[picture p52: board pcb-measurement board/measurement_board.kicad_pcb from below]

Board: 4 copper layers, 60.0 x 46.0 mm, 98 parts (17 on the bottom side), 106 nets.
