tawender/Sensor_Research_System_Hardware/pcb-measurement board/New folder/measurement_board.kicad_pcb

## KiCad design pcb-measurement board/New folder/measurement_board.kicad_pcb (2017-04-28)

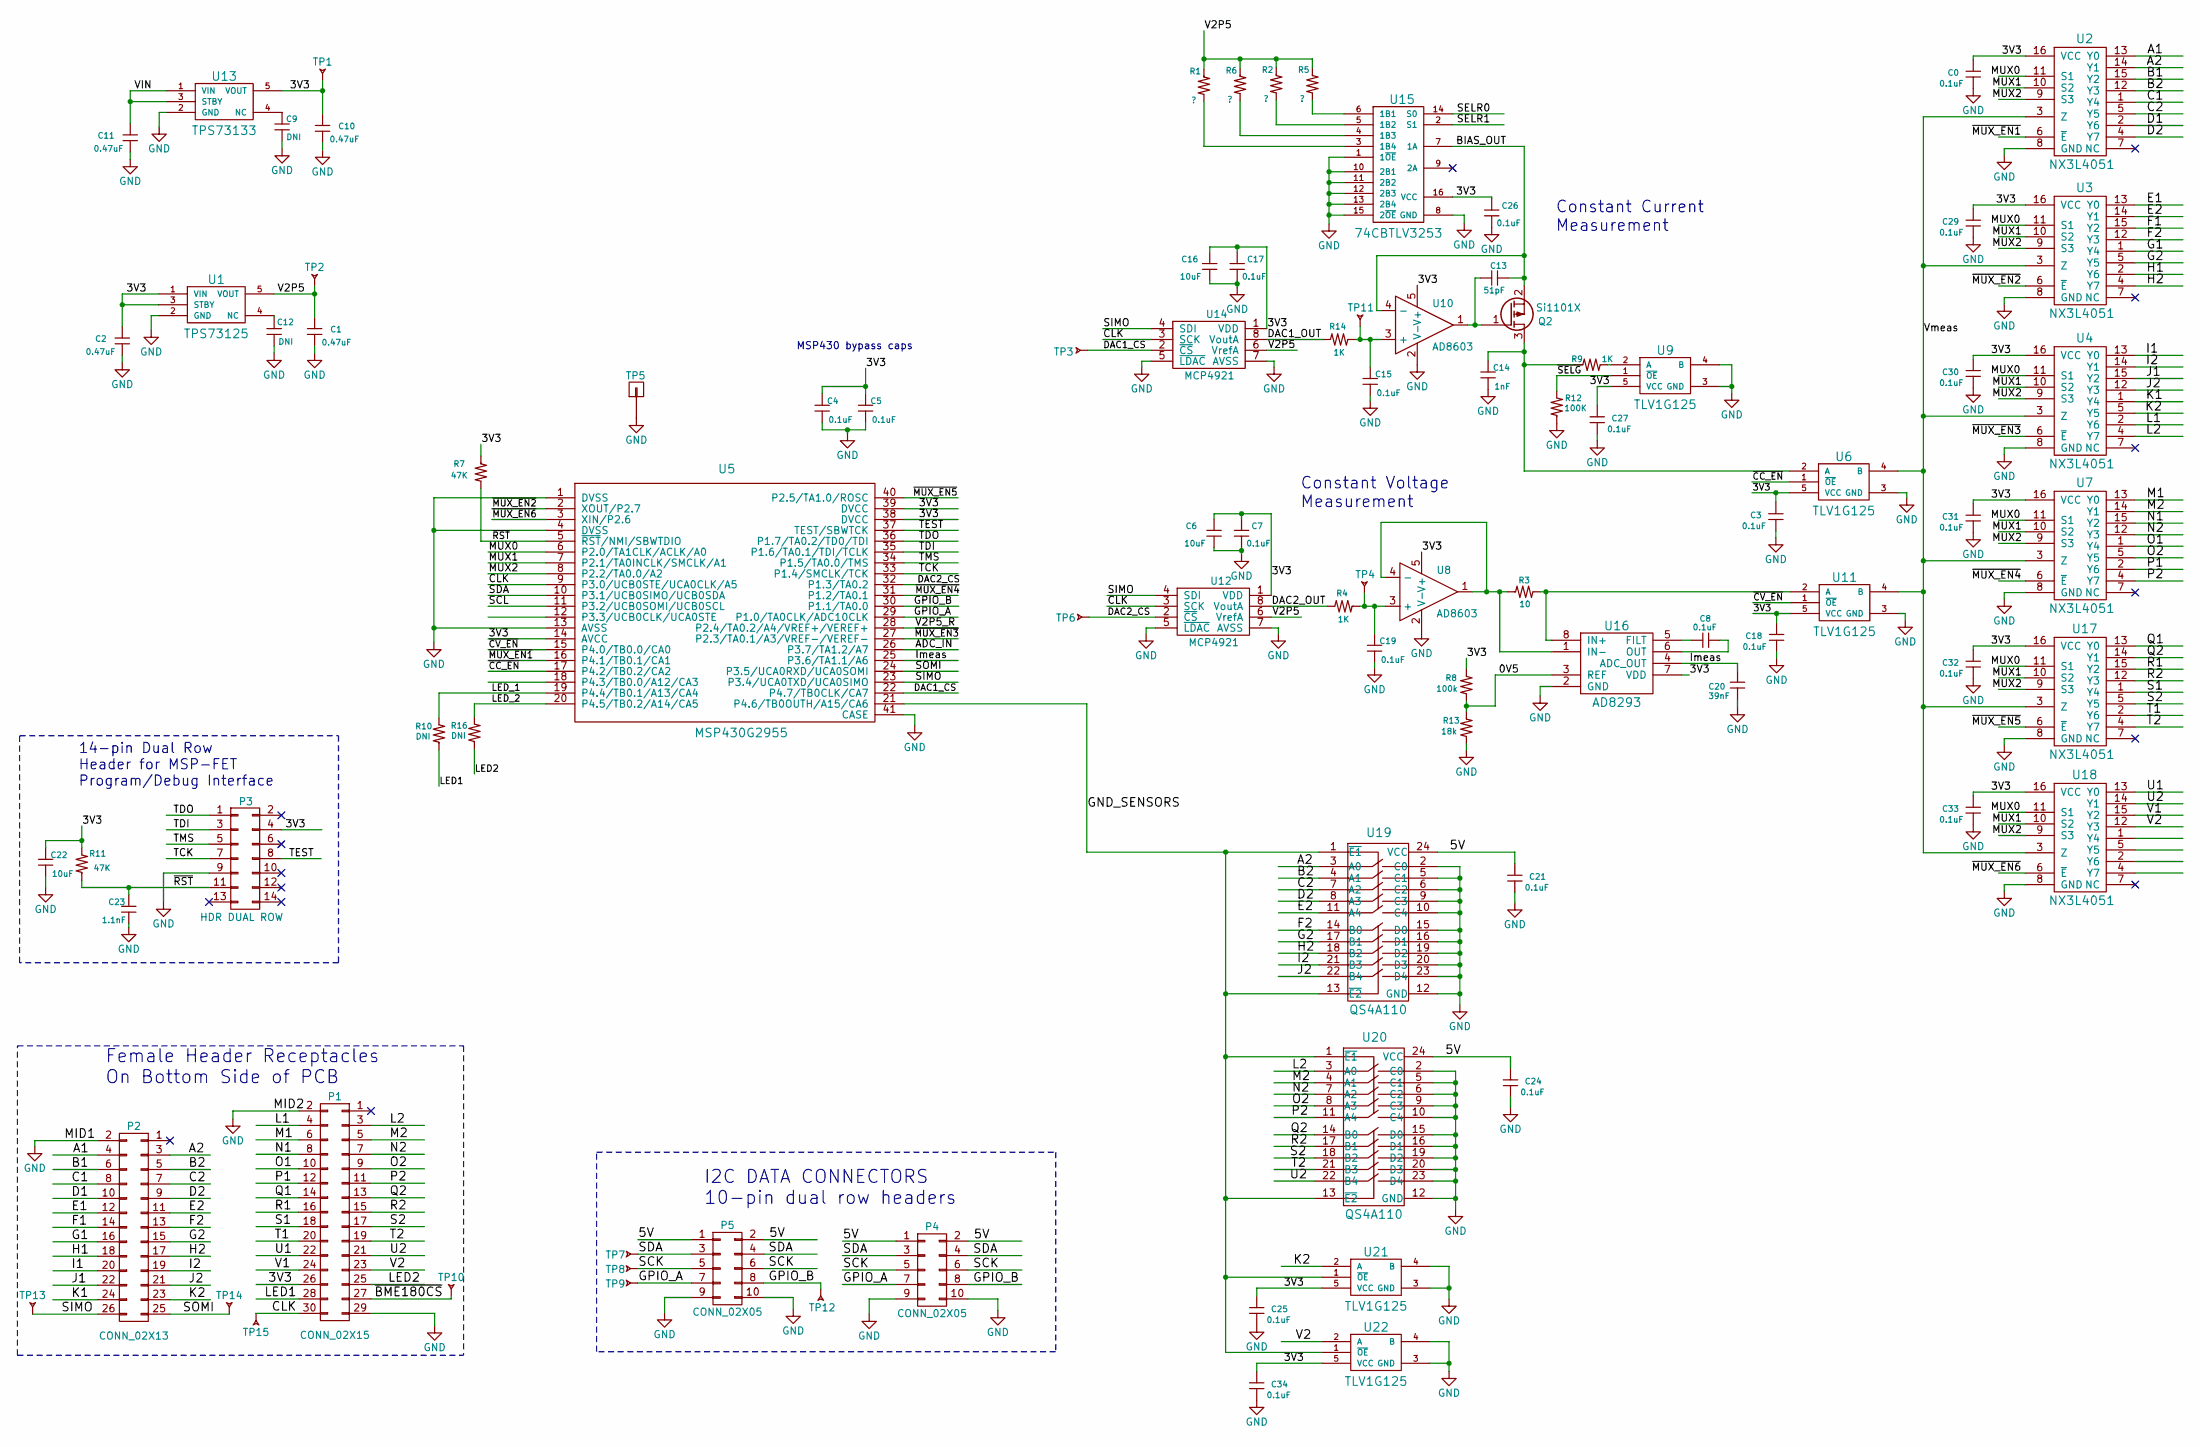
[picture p53: schematic measurement_board.sch, Schematic - NEA Sensor Measurement PCB]

Parts:
C0: 0.1uF; 0603; manufacturer pn GRM188R71C104KA01D
C1, C2, C10, C11: 0.47uF; 0603; manufacturer pn CL10A474KP8NNNC
C3, C18, C21, C24, C25, C27, C29, C30, C31, C32, C33, C34: 0.1uF; R_0603_HandSoldering; manufacturer pn GRM188R71C104KA01D
C4, C5, C7, C8, C15, C17, C19, C26: 0.1uF; 0402; manufacturer pn 0402YD104KAT2A
C6, C16: 10uF; 0402; manufacturer pn CL05A106MP8NUB8
C9, C12: DNI; 0603; manufacturer pn NA
C13: 51pF; 0402; manufacturer pn GRM1555C1H510JA01D
C14: 1nF; 0402; manufacturer pn GRM155R71H102KA01D
C20: 39nF; 0402; manufacturer pn 0402YD104KAT2A
C22: 10uF; 0402; manufacturer pn GRM155R60G106ME44D
C23: 1.1nF; 0402; manufacturer pn C0402C112J5GAC7867
P1: CONN_02X15; Pin_Header_Straight_2x15_Pitch2.54mm; manufacturer pn 2-146134-1
P2: CONN_02X13; Pin_Header_Straight_2x13_Pitch2.54mm; manufacturer pn 1-534998-5
P3: HDR DUAL ROW; Pin_Header_Straight_2x07_Pitch2.54mm; manufacturer pn PEC36DFAN
P4, P5: CONN_02X05; Pin_Header_Straight_2x05_Pitch2.54mm
Q2: Si1101X; SOT23; manufacturer pn SI1011X-T1-GE3
R1, R2, R5, R6: ?; 0603
R3: 10; 0402; manufacturer pn RC0402FR-07100KL
R4, R9, R14: 1K; 0402; manufacturer pn RC0402FR-071KL
R7: 47K; 0402; manufacturer pn RMCF0402FT47K0
R8: 100k; 0402; manufacturer pn RC0402FR-07100KL
R10, R16: DNI; 0603
R11: 47K; 0402; manufacturer pn RC0402FR-0747KL
R12: 100K; 0402; manufacturer pn RC0402FR-07100KL
R13: 18k; 0402; manufacturer pn RC0402FR-07100KL
TP1, TP2, TP3, TP4, TP6, TP7, TP8, TP9, TP10, TP11, TP12, TP13, TP14, TP15: TP_SMT; TP_SMT.02
TP5: header_pin; Header_Pin_Rnd
U1: TPS73125; SOT23-5; manufacturer pn TPS73125DBVT
U2, U3, U4, U7, U17, U18: NX3L4051; TSSOP16; manufacturer pn NX3L4051PW-118
U5: MSP430G2955; VQFN40; manufacturer pn MSP430G2955IRHA40R
U6, U9, U11, U21, U22: TLV1G125; SOT23-5; manufacturer pn SN74CBTLV1G125DBVR
U8, U10: AD8603; SOT23-5; manufacturer pn AD8603AUJZ-REEL7
U12, U14: MCP4921; MSOP-8; manufacturer pn MCP4921T-E/MS
U13: TPS73133; SOT23-5; manufacturer pn TPS73133DBVR
U15: 74CBTLV3253; DHVQFN16; manufacturer pn 74CBTLV3253BQ-115
U16: AD8293; SOT23-8; manufacturer pn AD8293G160ARJZ-R7
U19, U20: QS4A110; QSOP-24; manufacturer pn QS4A110QG

Connections:
/0V5: R8.1, R13.2, U16.3 (REF)
/3V3: C0.1, C2.1, C3.1, C4.1, C5.1, C6.1, C7.1, C10.1, C16.1, C17.1, C18.1, C22.1, C25.1, C26.1, C27.1, C29.1, C30.1, C31.1, C32.1, C33.1, C34.1, P1.26, P3.4, R7.2, R8.2, R11.1, TP1.1, U1.1 (VIN), U1.3 (STBY), U2.16 (VCC), U3.16 (VCC), U4.16 (VCC), U5.14 (AVCC), U5.38 (DVCC), U5.39 (DVCC), U6.5 (VCC), U7.16 (VCC), U8.5 (V+), U9.5 (VCC), U10.5 (V+), U11.5 (VCC), U12.1 (VDD), U13.5 (VOUT), U14.1 (VDD), U15.16 (VCC), U16.7 (VDD), U17.16 (VCC), U18.16 (VCC), U21.5 (VCC), U22.5 (VCC)
/5V: C21.1, C24.1, P4.1, P4.2, P5.1, P5.2, U19.24 (VCC), U20.24 (VCC)
/A1: P2.4, U2.13 (Y0)
/A2: P2.3, U2.14 (Y1), U19.3 (A0)
/ADC_IN: U5.26 (P3.7/TA1.2/A7)
/B1: P2.6, U2.15 (Y2)
/B2: P2.5, U2.12 (Y3), U19.4 (A1)
/BIAS_OUT: C13.1, Q2.2 (S), U10.4 (-), U15.7 (1A)
/C1: P2.8, U2.1 (Y4)
/C2: P2.7, U2.5 (Y5), U19.7 (A2)
/CLK: P1.30, TP15.1, U5.9 (P3.0/UCB0STE/UCA0CLK/A5), U12.3 (SCK), U14.3 (SCK)
/D1: P2.10, U2.2 (Y6)
/D2: P2.9, U2.4 (Y7), U19.8 (A3)
/DAC1_CS: TP3.1, U5.22 (P4.7/TB0CLK/CA7), U14.2 (~CS~)
/DAC1_OUT: R14.1, U14.8 (VoutA)
/DAC2_CS: TP6.1, U5.32 (P1.3/TA0.2), U12.2 (~CS~)
/DAC2_OUT: R4.1, U12.8 (VoutA)
/E1: P2.12, U3.13 (Y0)
/E2: P2.11, U3.14 (Y1), U19.11 (A4)
/F1: P2.14, U3.15 (Y2)
/F2: P2.13, U3.12 (Y3), U19.14 (B0)
/G1: P2.16, U3.1 (Y4)
/G2: P2.15, U3.5 (Y5), U19.17 (B1)
/GND_SENSORS: U5.21 (P4.6/TB0OUTH/A15/CA6), U19.1 (~E1), U19.13 (~E2), U20.1 (~E1), U20.13 (~E2), U21.1 (~OE), U22.1 (~OE)
/GPIO_A: P4.7, P5.7, TP9.1, U5.29 (P1.0/TA0CLK/ADC10CLK)
/GPIO_B: P4.8, P5.8, TP12.1, U5.30 (P1.1/TA0.0)
/H1: P2.18, U3.2 (Y6)
/H2: P2.17, U3.4 (Y7), U19.18 (B2)
/I1: P2.20, U4.13 (Y0)
/I2: P2.19, U4.14 (Y1), U19.21 (B3)
/Imeas: C20.1, U5.25 (P3.6/TA1.1/A6), U16.4 (ADC_OUT)
/J1: P2.22, U4.15 (Y2)
/J2: P2.21, U4.12 (Y3), U19.22 (B4)
/K1: P2.24, U4.1 (Y4)
/K2: P2.23, U4.5 (Y5), U21.2 (A)
/L1: P1.4, U4.2 (Y6)
/L2: P1.3, U4.4 (Y7), U20.3 (A0)
/LED1: P1.28, R10.2
/LED2: P1.25, R16.2
/LED_1: R10.1, U5.19 (P4.4/TB0.1/A13/CA4)
/LED_2: R16.1, U5.20 (P4.5/TB0.2/A14/CA5)
/M1: P1.6, U7.13 (Y0)
/M2: P1.5, U7.14 (Y1), U20.4 (A1)
/MUX0: U2.11 (S1), U3.11 (S1), U4.11 (S1), U5.6 (P2.0/TA1CLK/ACLK/A0), U7.11 (S1), U17.11 (S1), U18.11 (S1)
/MUX1: U2.10 (S2), U3.10 (S2), U4.10 (S2), U5.7 (P2.1/TA0INCLK/SMCLK/A1), U7.10 (S2), U17.10 (S2), U18.10 (S2)
/MUX2: U2.9 (S3), U3.9 (S3), U4.9 (S3), U5.8 (P2.2/TA0.0/A2), U7.9 (S3), U17.9 (S3), U18.9 (S3)
/N1: P1.8, U7.15 (Y2)
/N2: P1.7, U7.12 (Y3), U20.7 (A2)
/O1: P1.10, U7.1 (Y4)
/O2: P1.9, U7.5 (Y5), U20.8 (A3)
/P1: P1.12, U7.2 (Y6)
/P2: P1.11, U7.4 (Y7), U20.11 (A4)
/Q1: P1.14, U17.13 (Y0)
/Q2: P1.13, U17.14 (Y1), U20.14 (B0)
/R1: P1.16, U17.15 (Y2)
/R2: P1.15, U17.12 (Y3), U20.17 (B1)
/S1: P1.18, U17.1 (Y4)
/S2: P1.17, U17.5 (Y5), U20.18 (B2)
/SCK: P4.5, P4.6, P5.5, P5.6, TP8.1
/SCL: U5.11 (P3.2/UCB0SOMI/UCB0SCL)
/SDA: P4.3, P4.4, P5.3, P5.4, TP7.1, U5.10 (P3.1/UCB0SIMO/UCB0SDA)
/SELR0: U15.14 (S0)
/SELR1: U15.2 (S1)
/SIMO: P2.26, TP13.1, U5.23 (P3.4/UCA0TXD/UCA0SIMO), U12.4 (SDI), U14.4 (SDI)
/SOMI: P2.25, TP14.1, U5.24 (P3.5/UCA0RXD/UCA0SOMI)
/T1: P1.20, U17.2 (Y6)
/T2: P1.19, U17.4 (Y7), U20.21 (B3)
/TCK: P3.7, U5.33 (P1.4/SMCLK/TCK)
/TDI: P3.3, U5.35 (P1.6/TA0.1/TDI/TCLK)
/TDO: P3.1, U5.36 (P1.7/TA0.2/TD0/TDI)
/TEST: P3.8, U5.37 (TEST/SBWTCK)
/TMS: P3.5, U5.34 (P1.5/TA0.0/TMS)
/U1: P1.22, U18.13 (Y0)
/U2: P1.21, U18.14 (Y1), U20.22 (B4)
/V1: P1.24, U18.15 (Y2)
/V2: P1.23, U18.12 (Y3), U22.2 (A)
/V2P5: C1.1, R1.2, R2.2, R5.2, R6.2, TP2.1, U1.5 (VOUT), U12.6 (VrefA), U14.6 (VrefA)
/V2P5_R: U5.28 (P2.4/TA0.2/A4/VREF+/VEREF+)
/VIN: C11.1, U13.1 (VIN), U13.3 (STBY)
/Vmeas: U2.3 (Z), U3.3 (Z), U4.3 (Z), U6.4 (B), U7.3 (Z), U11.4 (B), U17.3 (Z), U18.3 (Z)
/~BME180CS: P1.27, TP10.1
/~CC_EN: U5.17 (P4.2/TB0.2/CA2), U6.1 (~OE)
/~CV_EN: U5.15 (P4.0/TB0.0/CA0), U11.1 (~OE)
/~MUX_EN1: U2.6 (~E), U5.16 (P4.1/TB0.1/CA1)
/~MUX_EN2: U3.6 (~E), U5.2 (XOUT/P2.7)
/~MUX_EN3: U4.6 (~E), U5.27 (P2.3/TA0.1/A3/VREF-/VEREF-)
/~MUX_EN4: U5.31 (P1.2/TA0.1), U7.6 (~E)
/~MUX_EN5: U5.40 (P2.5/TA1.0/ROSC), U17.6 (~E)
/~MUX_EN6: U5.3 (XIN/P2.6), U18.6 (~E)
/~RST: C23.1, P3.11, R7.1, R11.2, U5.5 (~RST~/NMI/SBWTDIO)
/~SELG: R12.1, U9.1 (~OE)
GND: C0.2, C1.2, C2.2, C3.2, C4.2, C5.2, C6.2, C7.2, C9.2, C10.2, C11.2, C12.2, C14.2, C15.2, C16.2, C17.2, C18.2, C19.2, C20.2, C21.2, C22.2, C23.2, C24.2, C25.2, C26.2, C27.2, C29.2, C30.2, C31.2, C32.2, C33.2, C34.2, P1.2, P1.29, P2.2, P3.9, P4.9, P4.10, P5.9, P5.10, R12.2, R13.1, TP5.1, U1.2 (GND), U2.8 (GND), U3.8 (GND), U4.8 (GND), U5.1 (DVSS), U5.4 (DVSS), U5.13 (AVSS), U5.41 (CASE), U6.3 (GND), U7.8 (GND), U8.2 (V-), U9.3 (GND), U9.4 (B), U10.2 (V-), U11.3 (GND), U12.5 (~LDAC~), U12.7 (AVSS), U13.2 (GND), U14.5 (~LDAC~), U14.7 (AVSS), U15.1 (1~OE), U15.8 (GND), U15.10 (2B1), U15.11 (2B2), U15.12 (2B3), U15.13 (2B4), U15.15 (2~OE), U16.2 (GND), U17.8 (GND), U18.8 (GND), U19.2 (C0), U19.5 (C1), U19.6 (C2), U19.9 (C3), U19.10 (C4), U19.12 (GND), U19.15 (D0), U19.16 (D1), U19.19 (D2), U19.20 (D3), U19.23 (D4), U20.2 (C0), U20.5 (C1), U20.6 (C2), U20.9 (C3), U20.10 (C4), U20.12 (GND), U20.15 (D0), U20.16 (D1), U20.19 (D2), U20.20 (D3), U20.23 (D4), U21.3 (GND), U21.4 (B), U22.3 (GND), U22.4 (B)
unnamed: C8.1, U16.5 (FILT)
unnamed: C8.2, U16.6 (OUT)
unnamed: C9.1, U13.4 (NC)
unnamed: C12.1, U1.4 (NC)
unnamed: C13.2, Q2.1 (G), U10.1
unnamed: C14.1, Q2.3 (D), R9.2, U6.2 (A)
unnamed: C15.1, R14.2, TP11.1, U10.3 (+)
unnamed: C19.1, R4.2, TP4.1, U8.3 (+)
unnamed: R1.1, U15.3 (1B4)
unnamed: R2.1, U15.5 (1B2)
unnamed: R3.1, U11.2 (A), U16.8 (IN+)
unnamed: R3.2, U8.1, U8.4 (-), U16.1 (IN-)
unnamed: R5.1, U15.6 (1B1)
unnamed: R6.1, U15.4 (1B3)
unnamed: R9.1, U9.2 (A)

Notes on the sheet:
MSP430 bypass caps
Female Header Receptacles On Bottom Side of PCB
14-pin Dual Row Header for MSP-FET Program/Debug Interface
I2C DATA CONNECTORS 10-pin dual row headers
Constant Current Measurement
Constant Voltage Measurement

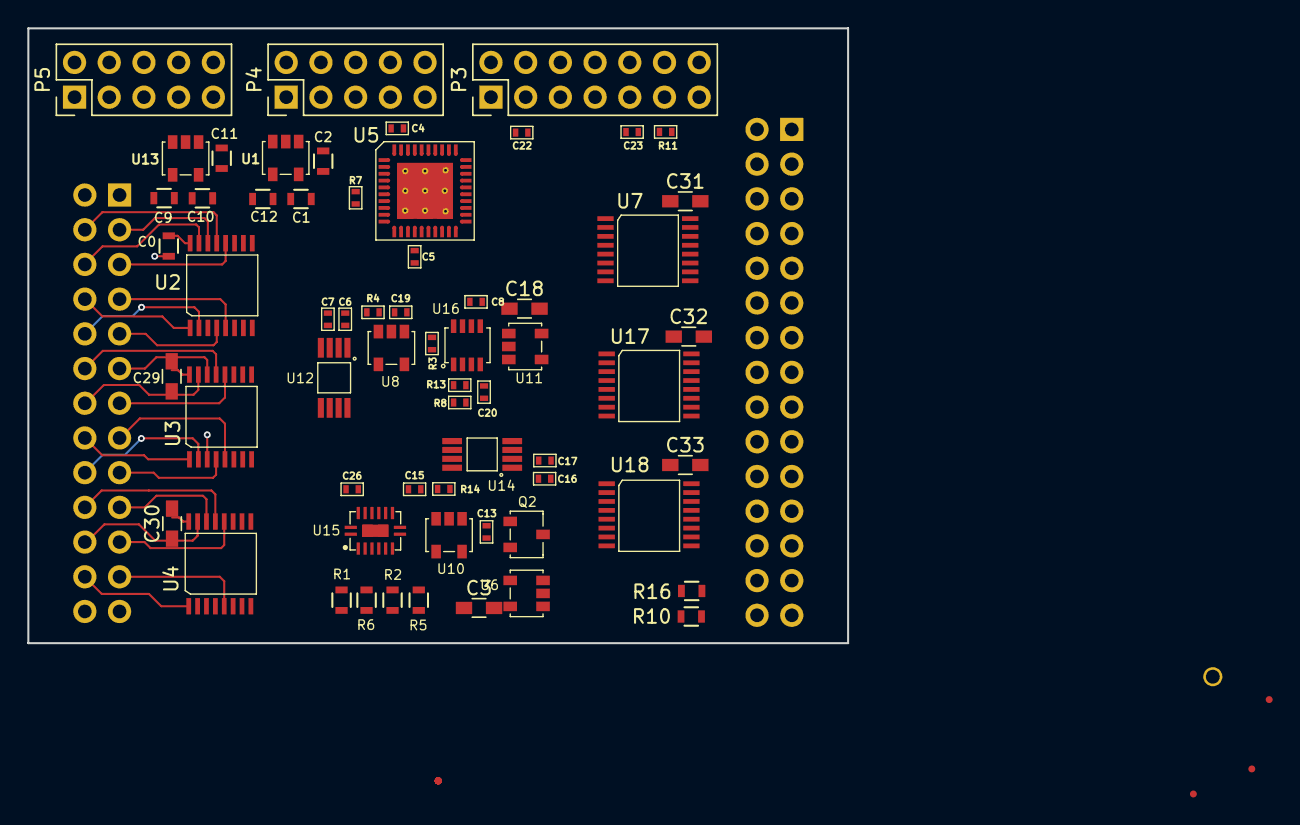
[picture p54: board pcb-measurement board/New folder/measurement_board.kicad_pcb from above]

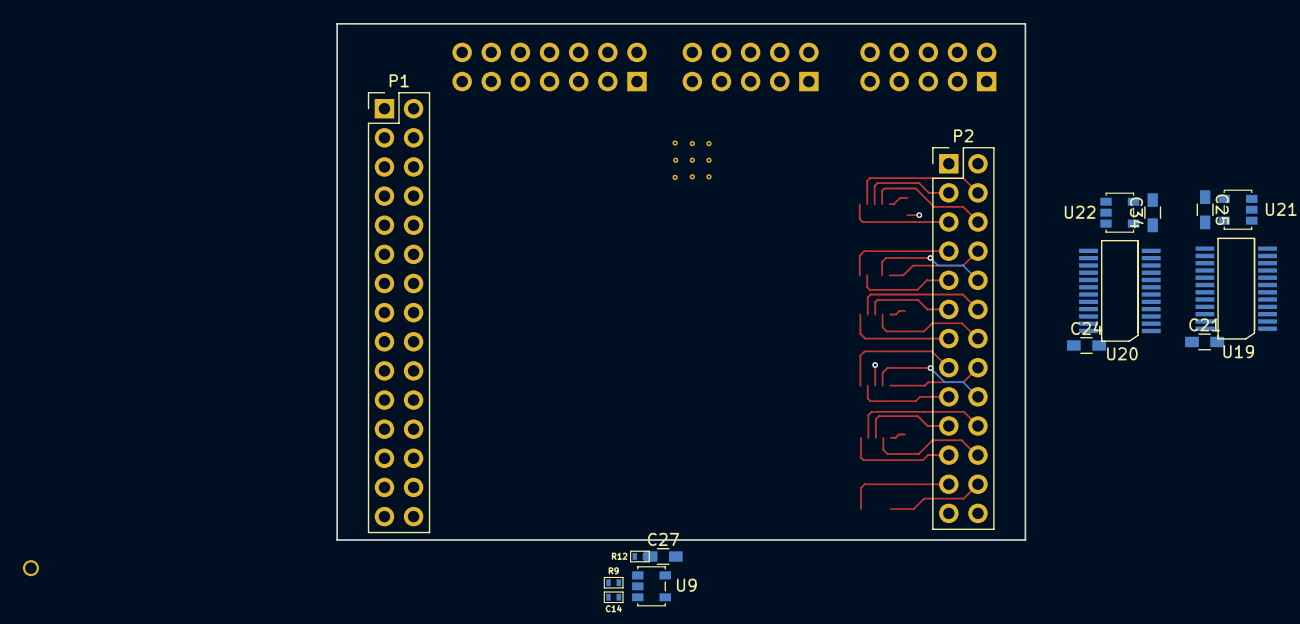
[picture p55: board pcb-measurement board/New folder/measurement_board.kicad_pcb from below]

Board: 4 copper layers, 60.0 x 45.0 mm, 92 parts (15 on the bottom side), 103 nets.
