tawender/Sensor_Research_System_Hardware/pcb-breakout/rev2/nea_fixture_breakout_board_rev2.kicad_pcb

## KiCad design pcb-breakout/rev2/nea_fixture_breakout_board_rev2.kicad_pcb (2017-02-21)

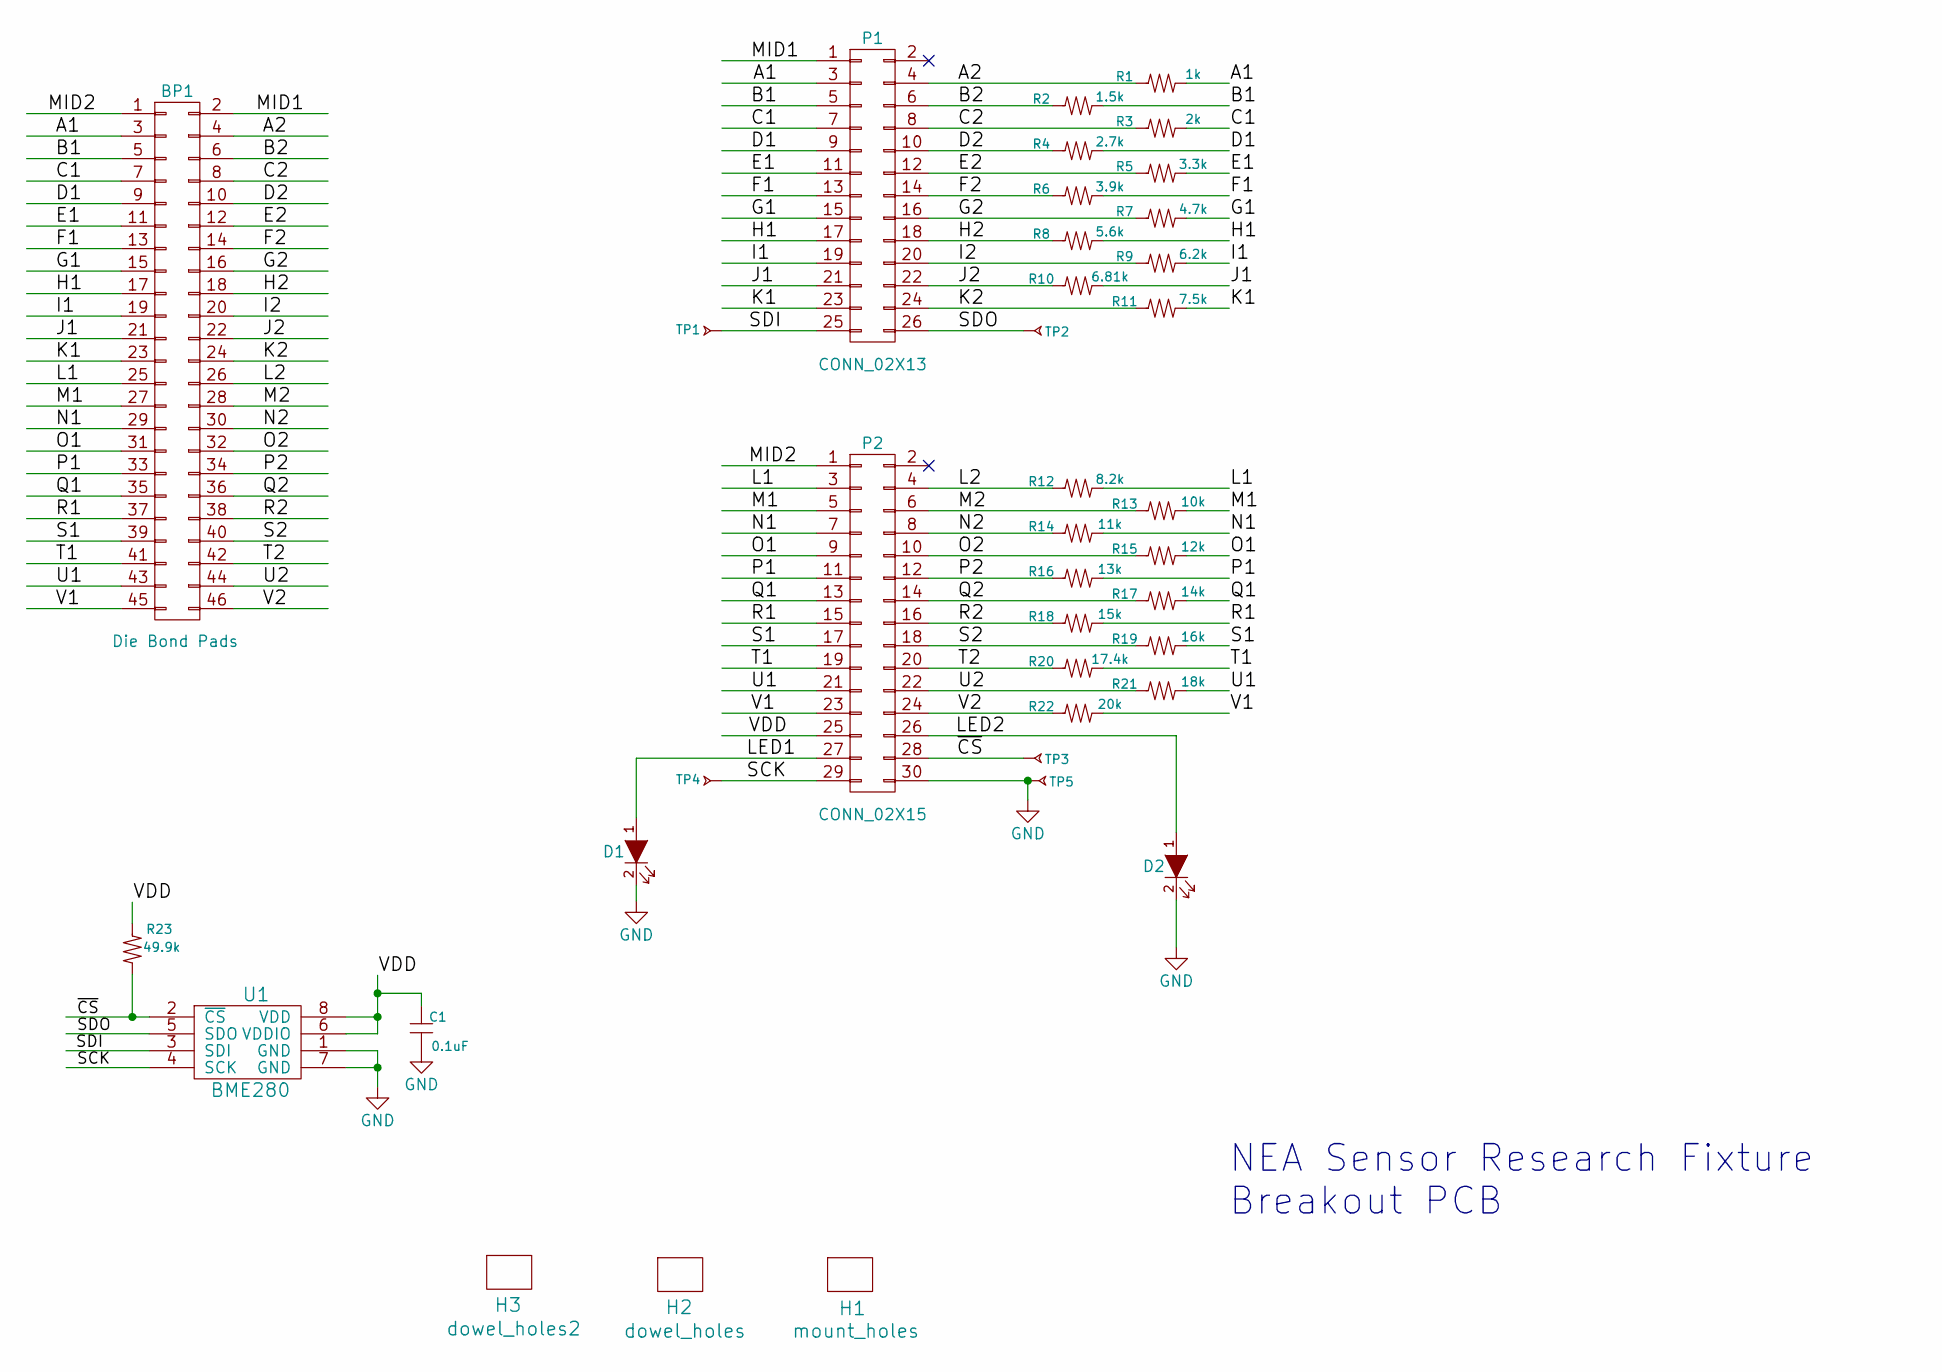
[picture p56: schematic nea_fixture_breakout_board_rev2.sch, Breakout PCB Schematic]

Parts:
BP1: Die Bond Pads; bondpads
C1: 0.1uF; R_0603_HandSoldering; manufacturer pn GRM188R71C104KA01D
D1, D2: LED_SMT; 0603_diode; manufacturer pn APT1608SGC
H1: mount_holes
H2: dowel_holes
H3: dowel_holes2
P1: CONN_02X13; header_smt_2x13
P2: CONN_02X15; header_smt_2x15; manufacturer pn 2-146134-1
R1: 1k; R_0603_HandSoldering; manufacturer pn RC0603FR-071KL
R2: 1.5k; R_0603_HandSoldering; manufacturer pn RC0603FR-071K5L
R3: 2k; R_0603_HandSoldering; manufacturer pn RC0603FR-071KL
R4: 2.7k; R_0603_HandSoldering; manufacturer pn RC0603FR-071KL
R5: 3.3k; R_0603_HandSoldering; manufacturer pn RC0603FR-071KL
R6: 3.9k; R_0603_HandSoldering; manufacturer pn RC0603FR-071KL
R7: 4.7k; R_0603_HandSoldering; manufacturer pn RC0603FR-071KL
R8: 5.6k; R_0603_HandSoldering; manufacturer pn RC0603FR-071KL
R9: 6.2k; R_0603_HandSoldering; manufacturer pn RC0603FR-071KL
R10: 6.81k; R_0603_HandSoldering; manufacturer pn RC0603FR-071KL
R11: 7.5k; R_0603_HandSoldering; manufacturer pn RC0603FR-071KL
R12: 8.2k; R_0603_HandSoldering; manufacturer pn RC0603FR-071KL
R13: 10k; R_0603_HandSoldering; manufacturer pn RC0603FR-071KL
R14: 11k; R_0603_HandSoldering; manufacturer pn RC0603FR-071KL
R15: 12k; R_0603_HandSoldering; manufacturer pn RC0603FR-071KL
R16: 13k; R_0603_HandSoldering; manufacturer pn RC0603FR-071KL
R17: 14k; R_0603_HandSoldering; manufacturer pn RC0603FR-071KL
R18: 15k; R_0603_HandSoldering; manufacturer pn RC0603FR-071KL
R19: 16k; R_0603_HandSoldering; manufacturer pn RC0603FR-071KL
R20: 17.4k; R_0603_HandSoldering; manufacturer pn RC0603FR-071KL
R21: 18k; R_0603_HandSoldering; manufacturer pn RC0603FR-071KL
R22: 20k; R_0603_HandSoldering; manufacturer pn RC0603FR-071KL
R23: 49.9k; R_0603_HandSoldering; manufacturer pn RC0603FR-0749K9L
TP1, TP2, TP3, TP4, TP5: TP_wirehole; Header_Pin_Res
U1: BME280; BME280_hand; manufacturer pn BME280

Connections:
/A1: BP1.3, P1.3, R1.1
/A2: BP1.4, P1.4, R1.2
/B1: BP1.5, P1.5, R2.1
/B2: BP1.6, P1.6, R2.2
/C1: BP1.7, P1.7, R3.1
/C2: BP1.8, P1.8, R3.2
/D1: BP1.9, P1.9, R4.1
/D2: BP1.10, P1.10, R4.2
/E1: BP1.11, P1.11, R5.1
/E2: BP1.12, P1.12, R5.2
/F1: BP1.13, P1.13, R6.1
/F2: BP1.14, P1.14, R6.2
/G1: BP1.15, P1.15, R7.1
/G2: BP1.16, P1.16, R7.2
/H1: BP1.17, P1.17, R8.1
/H2: BP1.18, P1.18, R8.2
/I1: BP1.19, P1.19, R9.1
/I2: BP1.20, P1.20, R9.2
/J1: BP1.21, P1.21, R10.1
/J2: BP1.22, P1.22, R10.2
/K1: BP1.23, P1.23, R11.1
/K2: BP1.24, P1.24, R11.2
/L1: BP1.25, P2.3, R12.1
/L2: BP1.26, P2.4, R12.2
/LED1: D1.1 (A), P2.27
/LED2: D2.1 (A), P2.26
/M1: BP1.27, P2.5, R13.1
/M2: BP1.28, P2.6, R13.2
/MID1: BP1.2, P1.1
/MID2: BP1.1, P2.1
/N1: BP1.29, P2.7, R14.1
/N2: BP1.30, P2.8, R14.2
/O1: BP1.31, P2.9, R15.1
/O2: BP1.32, P2.10, R15.2
/P1: BP1.33, P2.11, R16.1
/P2: BP1.34, P2.12, R16.2
/Q1: BP1.35, P2.13, R17.1
/Q2: BP1.36, P2.14, R17.2
/R1: BP1.37, P2.15, R18.1
/R2: BP1.38, P2.16, R18.2
/S1: BP1.39, P2.17, R19.1
/S2: BP1.40, P2.18, R19.2
/SCK: P2.29, TP4.1, U1.4 (SCK)
/SDI: P1.25, TP1.1, U1.3 (SDI)
/SDO: P1.26, TP2.1, U1.5 (SDO)
/T1: BP1.41, P2.19, R20.1
/T2: BP1.42, P2.20, R20.2
/U1: BP1.43, P2.21, R21.1
/U2: BP1.44, P2.22, R21.2
/V1: BP1.45, P2.23, R22.1
/V2: BP1.46, P2.24, R22.2
/VDD: C1.1, P2.25, R23.2, U1.6 (VDDIO), U1.8 (VDD)
/~CS: P2.28, R23.1, TP3.1, U1.2 (~CS)
GND: C1.2, D1.2 (K), D2.2 (K), P2.30, TP5.1, U1.1 (GND), U1.7 (GND)

Notes on the sheet:
NEA Sensor Research Fixture Breakout PCB

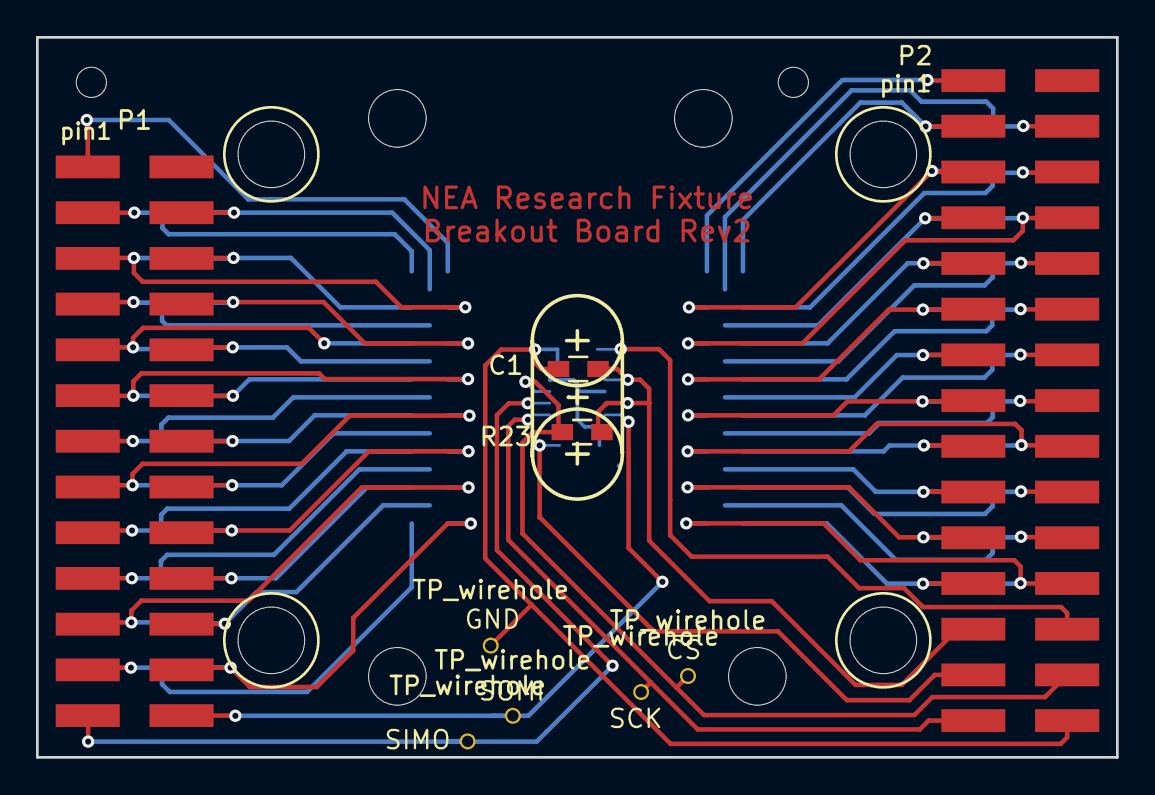
[picture p57: board nea_fixture_breakout_board_rev2.kicad_pcb from above]

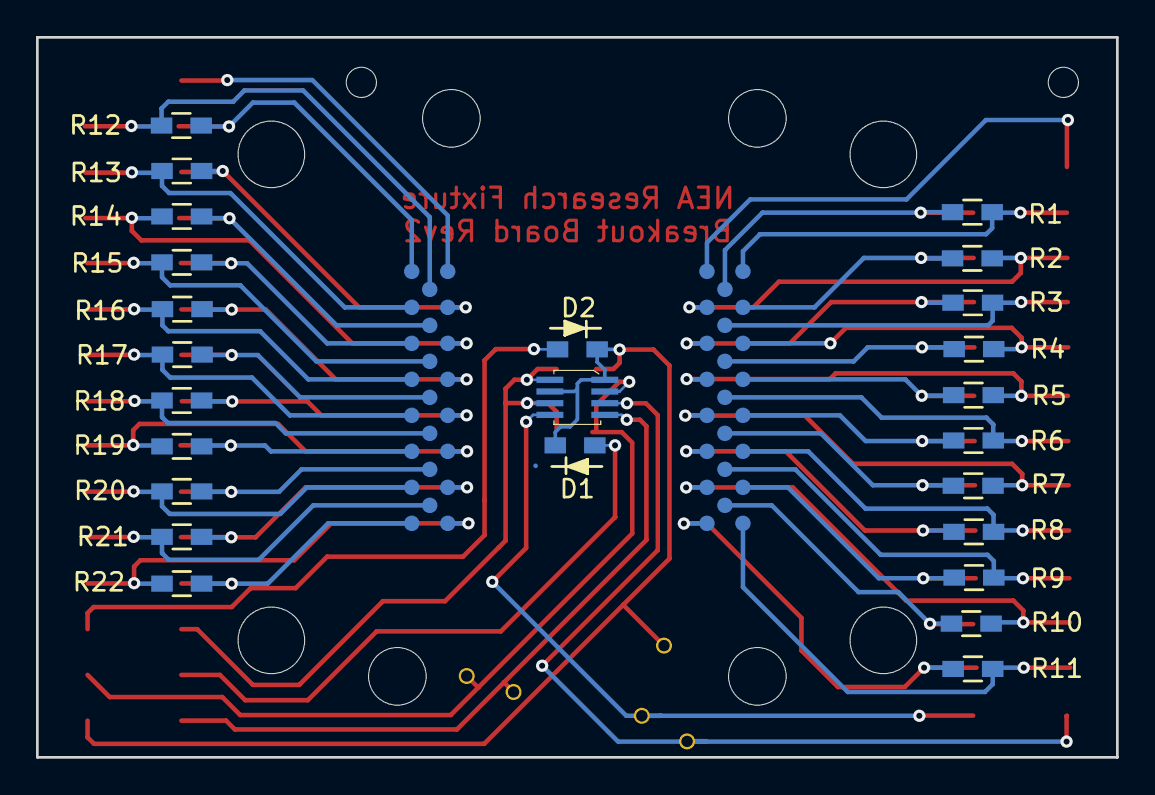
[picture p58: board nea_fixture_breakout_board_rev2.kicad_pcb from below]

Board: 2 copper layers, 60.0 x 40.0 mm, 38 parts (26 on the bottom side), 54 nets.
