tawender/Sensor_Research_System_Hardware/pcb-switch_board/rev1/nea_research_pcb_rev1_switch.kicad_pcb

## KiCad design pcb-switch_board/rev1/nea_research_pcb_rev1_switch.kicad_pcb (2017-02-10, an earlier design)

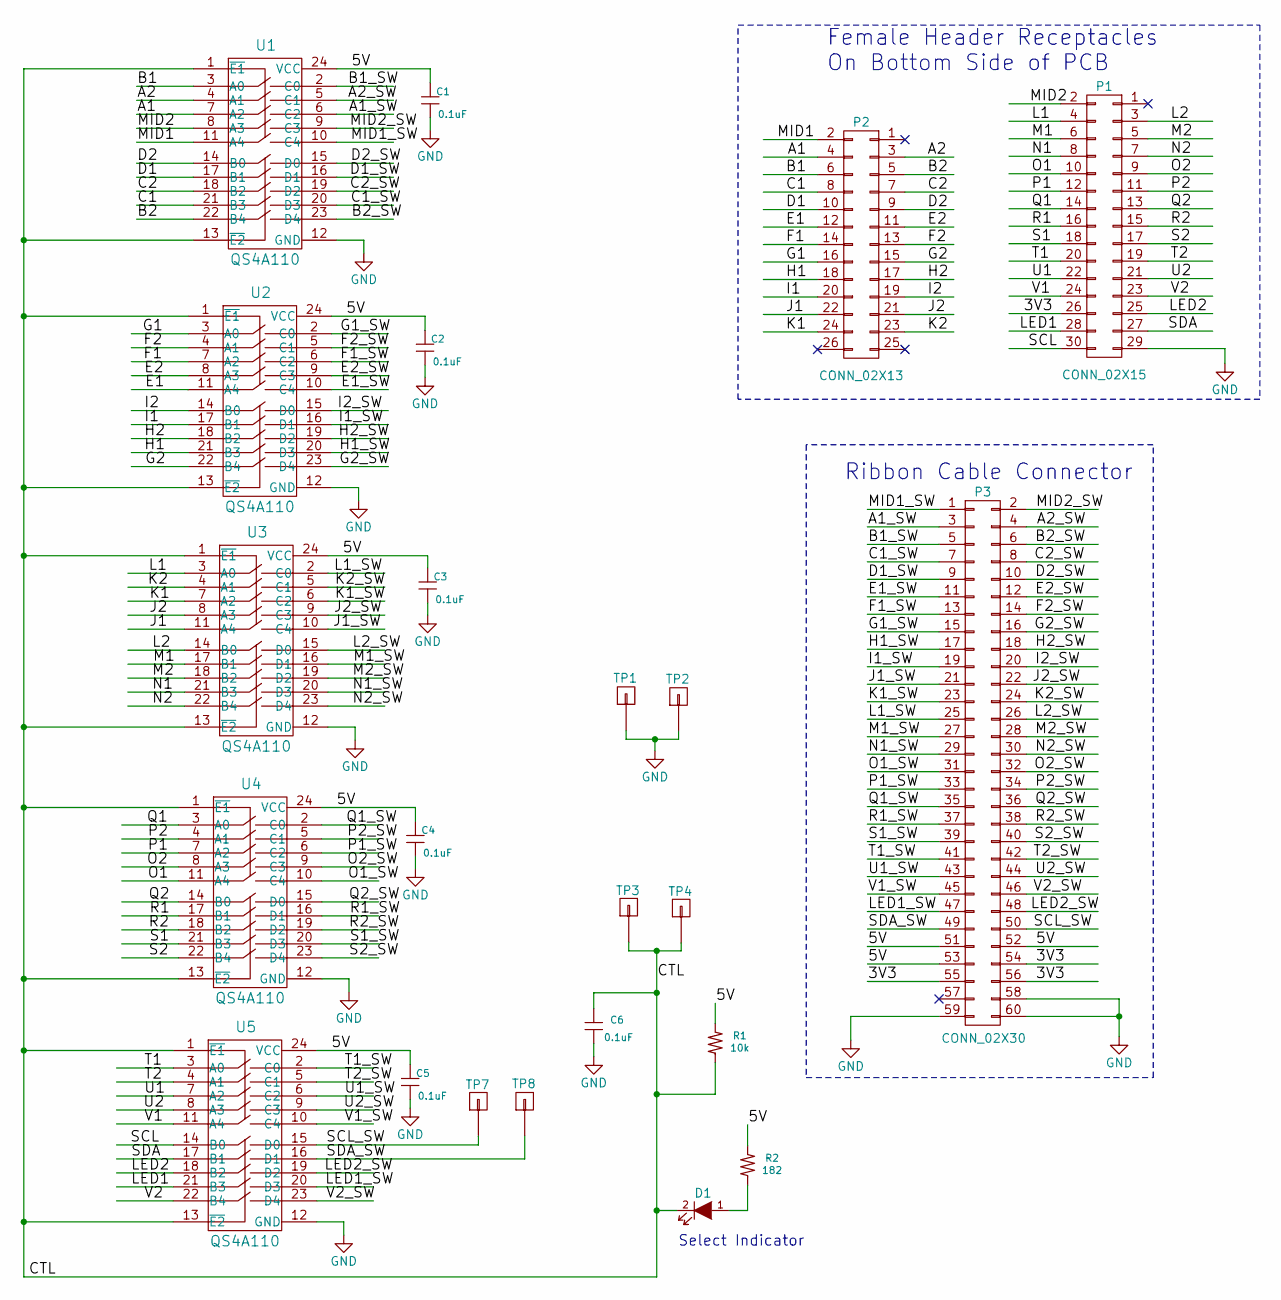
[picture p59: schematic nea_research_pcb_rev1_switch.sch, Schematic - NEA Research Fixture Switch PCB]

Parts:
C1, C2, C3, C4, C5, C6: 0.1uF; 0402; manufacturer pn 0402YD104KAT2A
D1: LED_SMT; 0603-D; manufacturer pn APT1608SGC
P1: CONN_02X15; Pin_Header_Straight_2x15_Pitch2.54mm; manufacturer pn 2-146134-1
P2: CONN_02X13; Pin_Header_Straight_2x13_Pitch2.54mm; manufacturer pn 1-534998-5
P3: CONN_02X30; HDR_2x30_F_latch; manufacturer pn 1-5499922-1
R1: 10k; 0603; manufacturer pn RC0603FR-0710KL
R2: 182; 0603; manufacturer pn RC0603FR-07182RL
TP1, TP2, TP3, TP4, TP7, TP8: header_pin; Header_Pin_Rnd
U1, U2, U3, U4, U5: QS4A110; QSOP-24; manufacturer pn QS4A110QG

Connections:
/3V3: P1.26, P3.54, P3.55, P3.56
/5V: C1.1, C2.1, C3.1, C4.1, C5.1, P3.51, P3.52, P3.53, R1.1, R2.1, U1.24 (VCC), U2.24 (VCC), U3.24 (VCC), U4.24 (VCC), U5.24 (VCC)
/A1: P2.4, U1.7 (A2)
/A1_SW: P3.3, U1.6 (C2)
/A2: P2.3, U1.4 (A1)
/A2_SW: P3.4, U1.5 (C1)
/B1: P2.6, U1.3 (A0)
/B1_SW: P3.5, U1.2 (C0)
/B2: P2.5, U1.22 (B4)
/B2_SW: P3.6, U1.23 (D4)
/C1: P2.8, U1.21 (B3)
/C1_SW: P3.7, U1.20 (D3)
/C2: P2.7, U1.18 (B2)
/C2_SW: P3.8, U1.19 (D2)
/CTL: C6.1, D1.2 (K), R1.2, TP3.1, TP4.1, U1.1 (~E1), U1.13 (~E2), U2.1 (~E1), U2.13 (~E2), U3.1 (~E1), U3.13 (~E2), U4.1 (~E1), U4.13 (~E2), U5.1 (~E1), U5.13 (~E2)
/D1: P2.10, U1.17 (B1)
/D1_SW: P3.9, U1.16 (D1)
/D2: P2.9, U1.14 (B0)
/D2_SW: P3.10, U1.15 (D0)
/E1: P2.12, U2.11 (A4)
/E1_SW: P3.11, U2.10 (C4)
/E2: P2.11, U2.8 (A3)
/E2_SW: P3.12, U2.9 (C3)
/F1: P2.14, U2.7 (A2)
/F1_SW: P3.13, U2.6 (C2)
/F2: P2.13, U2.4 (A1)
/F2_SW: P3.14, U2.5 (C1)
/G1: P2.16, U2.3 (A0)
/G1_SW: P3.15, U2.2 (C0)
/G2: P2.15, U2.22 (B4)
/G2_SW: P3.16, U2.23 (D4)
/H1: P2.18, U2.21 (B3)
/H1_SW: P3.17, U2.20 (D3)
/H2: P2.17, U2.18 (B2)
/H2_SW: P3.18, U2.19 (D2)
/I1: P2.20, U2.17 (B1)
/I1_SW: P3.19, U2.16 (D1)
/I2: P2.19, U2.14 (B0)
/I2_SW: P3.20, U2.15 (D0)
/J1: P2.22, U3.11 (A4)
/J1_SW: P3.21, U3.10 (C4)
/J2: P2.21, U3.8 (A3)
/J2_SW: P3.22, U3.9 (C3)
/K1: P2.24, U3.7 (A2)
/K1_SW: P3.23, U3.6 (C2)
/K2: P2.23, U3.4 (A1)
/K2_SW: P3.24, U3.5 (C1)
/L1: P1.4, U3.3 (A0)
/L1_SW: P3.25, U3.2 (C0)
/L2: P1.3, U3.14 (B0)
/L2_SW: P3.26, U3.15 (D0)
/LED1: P1.28, U5.21 (B3)
/LED1_SW: P3.47, U5.20 (D3)
/LED2: P1.25, U5.18 (B2)
/LED2_SW: P3.48, U5.19 (D2)
/M1: P1.6, U3.17 (B1)
/M1_SW: P3.27, U3.16 (D1)
/M2: P1.5, U3.18 (B2)
/M2_SW: P3.28, U3.19 (D2)
/MID1: P2.2, U1.11 (A4)
/MID1_SW: P3.1, U1.10 (C4)
/MID2: P1.2, U1.8 (A3)
/MID2_SW: P3.2, U1.9 (C3)
/N1: P1.8, U3.21 (B3)
/N1_SW: P3.29, U3.20 (D3)
/N2: P1.7, U3.22 (B4)
/N2_SW: P3.30, U3.23 (D4)
/O1: P1.10, U4.11 (A4)
/O1_SW: P3.31, U4.10 (C4)
/O2: P1.9, U4.8 (A3)
/O2_SW: P3.32, U4.9 (C3)
/P1: P1.12, U4.7 (A2)
/P1_SW: P3.33, U4.6 (C2)
/P2: P1.11, U4.4 (A1)
/P2_SW: P3.34, U4.5 (C1)
/Q1: P1.14, U4.3 (A0)
/Q1_SW: P3.35, U4.2 (C0)
/Q2: P1.13, U4.14 (B0)
/Q2_SW: P3.36, U4.15 (D0)
/R1: P1.16, U4.17 (B1)
/R1_SW: P3.37, U4.16 (D1)
/R2: P1.15, U4.18 (B2)
/R2_SW: P3.38, U4.19 (D2)
/S1: P1.18, U4.21 (B3)
/S1_SW: P3.39, U4.20 (D3)
/S2: P1.17, U4.22 (B4)
/S2_SW: P3.40, U4.23 (D4)
/SCL: P1.30, U5.14 (B0)
/SCL_SW: P3.50, TP7.1, U5.15 (D0)
/SDA: P1.27, U5.17 (B1)
/SDA_SW: P3.49, TP8.1, U5.16 (D1)
/T1: P1.20, U5.3 (A0)
/T1_SW: P3.41, U5.2 (C0)
/T2: P1.19, U5.4 (A1)
/T2_SW: P3.42, U5.5 (C1)
/U1: P1.22, U5.7 (A2)
/U1_SW: P3.43, U5.6 (C2)
/U2: P1.21, U5.8 (A3)
/U2_SW: P3.44, U5.9 (C3)
/V1: P1.24, U5.11 (A4)
/V1_SW: P3.45, U5.10 (C4)
/V2: P1.23, U5.22 (B4)
/V2_SW: P3.46, U5.23 (D4)
GND: C1.2, C2.2, C3.2, C4.2, C5.2, C6.2, P1.29, P3.58, P3.59, P3.60, TP1.1, TP2.1, U1.12 (GND), U2.12 (GND), U3.12 (GND), U4.12 (GND), U5.12 (GND)
unnamed: D1.1 (A), R2.2

Notes on the sheet:
Female Header Receptacles On Bottom Side of PCB
Ribbon Cable Connector
Select Indicator

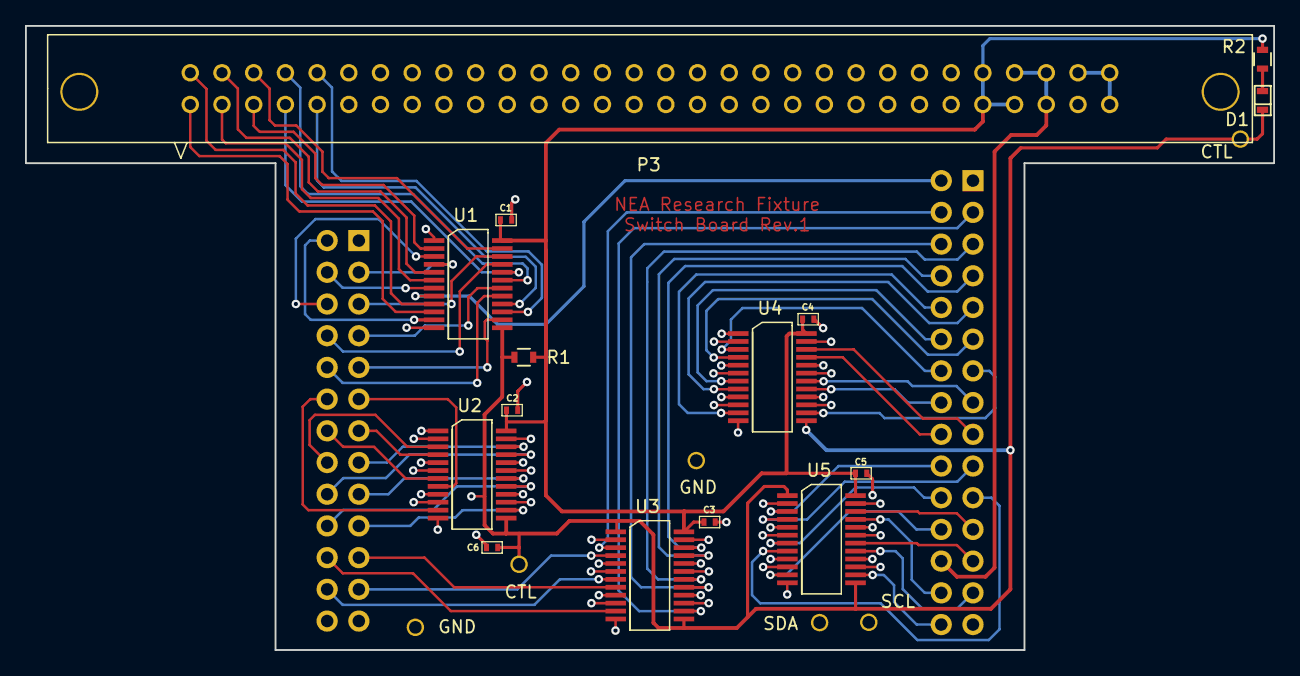
[picture p60: board nea_research_pcb_rev1_switch.kicad_pcb from above]

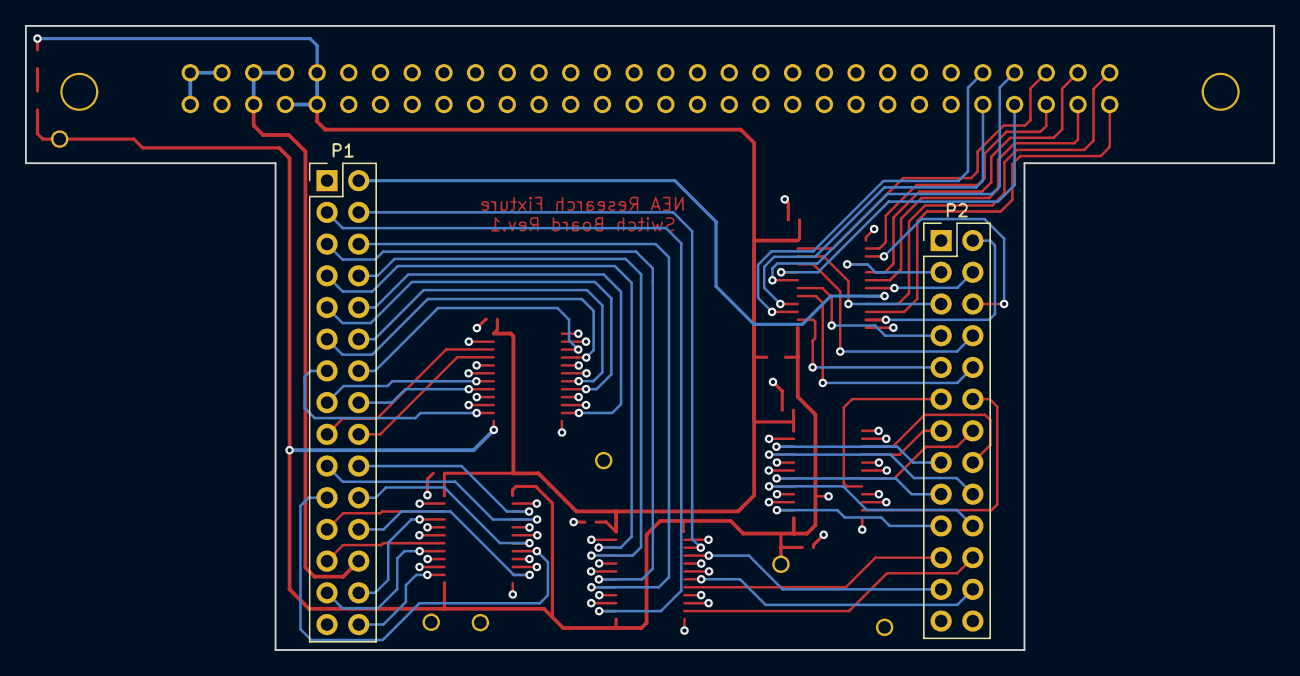
[picture p61: board nea_research_pcb_rev1_switch.kicad_pcb from below]

Board: 4 copper layers, 100.0 x 50.0 mm, 23 parts (2 on the bottom side), 105 nets.
