tawender/Sensor_Research_System_Hardware/(commit log)

2017-01-11 Initial commit for test fixture using reduced size pcb, oval PHT sensor cutout
    [NEA_research_fixture_R2.FCStd, SHCS_1_4-20.FCStd, die_holder_block.FCStd, die_rev2.FCStd, dowel_0.0625x.75L.FCStd, headers_smt_24.FCStd, headers_smt_26.FCStd, hose_barb_0.25.FCStd]
2017-01-12 before swapping headers/pcb mounting holes, -no changes to keying method yet
    [die_holder_block.FCStd, pcb.FCStd, probe_block.FCStd]
2017-01-13 -widened pcb -moved headers to outside edges of board -moved mounting screws to inside of headers -changed size of probe block to match pcb size
    [NEA_research_fixture_R2.FCStd, pcb.FCStd, probe_block.FCStd, washer_num4_nylon.FCStd]
2017-01-14 -increased die size -cut probe block in half (probe_block_top, probe_block_bot)
    [NEA_research_fixture_R2.FCStd, die_holder_block.FCStd, die_holder_block2.FCStd, die_rev2.FCStd, pcb.FCStd, probe_block.FCStd, probe_block_bot.FCStd, probe_block_top.FCStd]
2017-01-17 -changed dowel pins to 1/8
    [NEA_research_fixture_R2.FCStd, die_holder_block.FCStd, die_rev2.FCStd, dowel_0.125x.75L.FCStd, pcb.FCStd, probe_block_bot.FCStd, probe_block_top.FCStd]
2017-01-17 -changed dowel pins to 1/8 inch -changed die size to 21.5mm wide by 17mm high(got rid of text at bottom) -updated probe block which was cut in half(top and bottom section) -fixture assembly constrain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
    [NEA_research_fixture_R2.FCStd]
2017-01-18 -saved a copy of probe_block_bot to 'another_name' and that allowed the assembly to accept constraints to assemble the fixture pieces -updated die_holder_block to match the increased size of the pcb,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
    [NEA_research_fixture_R2.FCStd, another_name.FCStd, die_holder_block.FCStd, dowel_0.125x.875L.FCStd]
2017-01-19 -renamed file another_name.FCStd to probe_block_bot_.FCStd > -used renamed file to fix test fixture assembly NEA_research_fixture_R2
    [NEA_research_fixture_R2.FCStd, another_name.FCStd, die_holder_block.FCStd, probe_block_bot.FCStd, probe_block_bot_.FCStd]
2017-01-20 -increased width of all blocks to accomodate thumbscrews for clamping -added thumbscrews and threaded inserts to the fixture assembly
    [SENSOR_CHIP_DAISY.DXF, SHCS_1_4-20.FCStd, SHCS_4-40x0.25.FCStd, SHCS_4-40x0.4375.FCStd, SHCS_4-40x0.5.FCStd, die_holder_block.FCStd, die_holder_block_thumbscrews.step, die_layout.FCStd]
2017-01-21 -increased size of blocks slightly to be larger than pcb outline -removed gas inlet/outlet holes in the probe_block_top and probe_block_bot files -added new files probe_block_bot_gas and probe_block_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
    [die_holder_block.FCStd, die_holder_block.step, die_holder_block2.FCStd, die_layout.FCStd, headers_smt_30.FCStd, pcb.FCStd, pcb_bare.FCStd, probe_block_bot.step]
2017-01-21 -fixed tweezer pocket in die_holder_block to reach to the edge of the part
    [_saved_nea_fixture_breakout_board.sch, die_holder_block.FCStd, die_holder_block.step, nea_fixture_breakout_board.kicad_pcb, nea_fixture_breakout_board.sch]
2017-01-24 completed schematic and layout for breakout pcb
    [NEA_002.DXF, SENSOR_CHIP_005.DXF, SENSOR_CHIP_006.DXF, SENSOR_CHIP_DAISY.DXF, _saved_nea_fixture_breakout_board.sch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]
2017-01-25 -updated schematic with unique resistor values at each sensor location -created pdfs of the schematic and pcb layout
    [nea_fixture_breakout_board.sch]
2017-01-26 -reorganized directory structure -created new directory for pcb used to connect sensors to adc and take measurements
    [nea_fixture_breakout_board-R1.drl, nea_fixture_breakout_board-R1.gbl, nea_fixture_breakout_board-R1.gbo, nea_fixture_breakout_board-R1.gbs, nea_fixture_breakout_board-R1.gko, nea_fixture_breakout_board-R1.gtl, nea_fixture_breakout_board-R1.gto, nea_fixture_breakout_board-R1.gts]
2017-01-26 -starting on measurement pcb
    [nea_fixture_breakout_board.sch, nea_research_pcb_rev1.kicad_pcb, nea_research_pcb_rev1.sch]
2017-02-04 --fixed breakout pcb drill file for reorder and regenerated gerbers --
    [header_positions.xlsx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]
2017-02-08 -added directory and project files for switch pcb / measurement pcb -schematic for switch pcb is created -beginning to lay out switch pcb
    [costing_estimate.xls, header_positions.xlsx, nea_fixture_breakout_board.sch, nea_research_pcb_rev1_meas.sch, nea_research_pcb_rev1_switch.kicad_pcb, nea_research_pcb_rev1_switch.sch]
2017-02-08 -laying out switch board
    [nea_research_pcb_rev1_switch.kicad_pcb, nea_research_pcb_rev1_switch.sch]
2017-02-09 -progress on switch board layout
    [nea_research_pcb_rev1_switch.kicad_pcb, nea_research_pcb_rev1_switch.sch]
2017-02-10 -finished rev1 of switch board layout -zip file sent off for pcb order
    [nea_research_pcb_rev1_switch-B.Cu.gbl, nea_research_pcb_rev1_switch-B.Mask.gbs, nea_research_pcb_rev1_switch-B.Paste.gbp, nea_research_pcb_rev1_switch-B.SilkS.gbo, nea_research_pcb_rev1_switch-F.Cu.gtl, nea_research_pcb_rev1_switch-F.Mask.gts, nea_research_pcb_rev1_switch-F.Paste.gtp, nea_research_pcb_rev1_switch-F.SilkS.gto]
2017-02-15 -fixture probe blocks added secondary dowel pin holes to align independant of die holding block-added a relief around perimeter of die in the die holding block -tightened dowel holes in die holding b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
    [CSS118_rev4_CLCC.sch, _saved_nea_research_control_board.sch, die_holder_block.FCStd, die_holder_block.step, die_holder_block_r2.step, fixture_rev2_wiring_diagram.xls, nea_research_control_board.kicad_pcb, nea_research_control_board.sch]
2017-02-15 -saved probe_block_top_gas
    [probe_block_top_gas.FCStd]
2017-02-18 -revised breakout board to use BME280 sensor for SPI instead of I2C -revised switch board to accomodate SPI bus(2 extra signals) -added SPI bus testpoints to both boards -organized breakout and switc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
    [_saved_nea_research_control_board.sch, costing_estimate.xls, fixture_rev2_wiring_diagram_SPI.xls, header_positions.xlsx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]
2017-02-21 -removed solder paste layer from breakout board bond pad footprint -starting on control board schematic
    [CSS118_rev7a_CLCC.sch, die_holder_block.FCStd, fixture_rev2_wiring_diagram_SPI.xls, nea_fixture_breakout_board_rev2.kicad_pcb, nea_research_control_board.sch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]
2017-02-21 -adding invoices for spring probes, stencil
2017-02-22 -updated 3d model of manufacturing fixture with new mechanical parts for base mounted dowel pins -added 3d model of fixture used for gas testing
    [_saved_nea_research_control_board.sch, dowel_0.0625x.5L.FCStd, dowel_0.125x.625L.FCStd, pcb.FCStd]
2017-02-22 -added adc mux and gnd mux to control board schematic
    [_saved_nea_research_control_board.sch, nea_research_control_board.sch, nea_research_switch_pcb_rev2.sch]
2017-02-24 -updated wiring diagram for breakout board and switch board headers -fixed switch board schematic pdf naming
    [CSS118_rev6_CLCC.sch, _saved_nea_research_control_board.sch, fixture_rev2_wiring_diagram.xls, fixture_rev2_wiring_diagram_SPI.xls]
2017-04-08 -changed die_holder_block depth from 41mm to 40mm -added a probe block that is a one-piece design thick enough to hold spring probes
    [_saved_nea_research_control_board.sch, die_holder_block.FCStd, die_holder_block_r3.step, fixture_rev2_wiring_diagram_SPI.xls, nea_fixture_breakout_board_rev2.sch, nea_research_control_board.csv, nea_research_control_board.sch, probe_block.FCStd]
2017-04-22 -working on new pcb for research test fixture that will sit on top of the breakout board headers. This new pcb will use an msp430 to control measurements at each sensor and will communicate with a ra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
    [CSS118_rev7a_CLCC.sch, _saved_nea_research_control_board.sch, measurement_board.kicad_pcb, measurement_board.sch, nea_fixture_breakout_board_for_alignment.kicad_pcb, nea_research_control_board.sch, nea_research_pcb_rev1.kicad_pcb, nea_research_pcb_rev1_meas.sch]
2017-04-26 -schematic is being refined -working on placement of pcb parts -all footprints are completed
    [_saved_measurement_board.sch, measurement_board.csv, measurement_board.sch, nea_research_current_measurement.xls]
2017-04-27 -component placement completed -routing just started
    [_saved_measurement_board.sch, measurement_board.kicad_pcb, measurement_board.sch]
2017-04-28 -replaced all measurement board 0402 components with 0603 -adjusted placement and started routing on the layout
    [CSS118_rev7a_CLCC.sch, _saved_measurement_board.sch, measurement_board.csv, measurement_board.kicad_pcb, measurement_board.sch, nea_fixture_breakout_board_rev2.sch, nea_research_current_measurement.xls, nea_research_pcb_rev1_meas.sch]
2017-04-29 -updated current measurement spreadsheet
    [_saved_measurement_board.sch, nea_research_current_measurement.xls]
2017-05-04 -more progress on the measurement board layout
    [CSS118_rev7a_CLCC.sch, _saved_measurement_board.sch, measurement_board.kicad_pcb, measurement_board.sch, nea_fixture_breakout_board_rev2.sch, nea_research_current_measurement.xls, nea_research_pcb_rev1_meas.sch, nea_research_switch_pcb_rev2.sch]
2017-05-05 progress on the measurement board layout
    [measurement_board.kicad_pcb]
2017-05-08 -nearing completion of measurement board layout -routed most signal traces, just need to add testpoints and fix DRC voilations -changed MSP430 programming connector from 2x7 header to 10-pin flex cab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
    [measurement_board.kicad_pcb, measurement_board.sch]
2017-05-09 -layout of measurement board completed -gerber files created -added a pdf of the schematic
    [measurement_board-B.Cu.gbl, measurement_board-B.Mask.gbs, measurement_board-B.Paste.gbp, measurement_board-B.SilkS.gbo, measurement_board-Edge.Cuts.gm1, measurement_board-F.Cu.gtl, measurement_board-F.Mask.gts, measurement_board-F.Paste.gtp]
2017-07-20 -added BOM and files for measurement board assembly house
    [measurement_board.csv, measurement_board.kicad_pcb, measurement_board.sch, measurement_board_rev1_BOM.xls, nea_research_current_measurement.xls, nea_research_switch_pcb_rev2.sch]
